Edtison/EDTV4/media/renders/EDTV4_CAD_Render.png

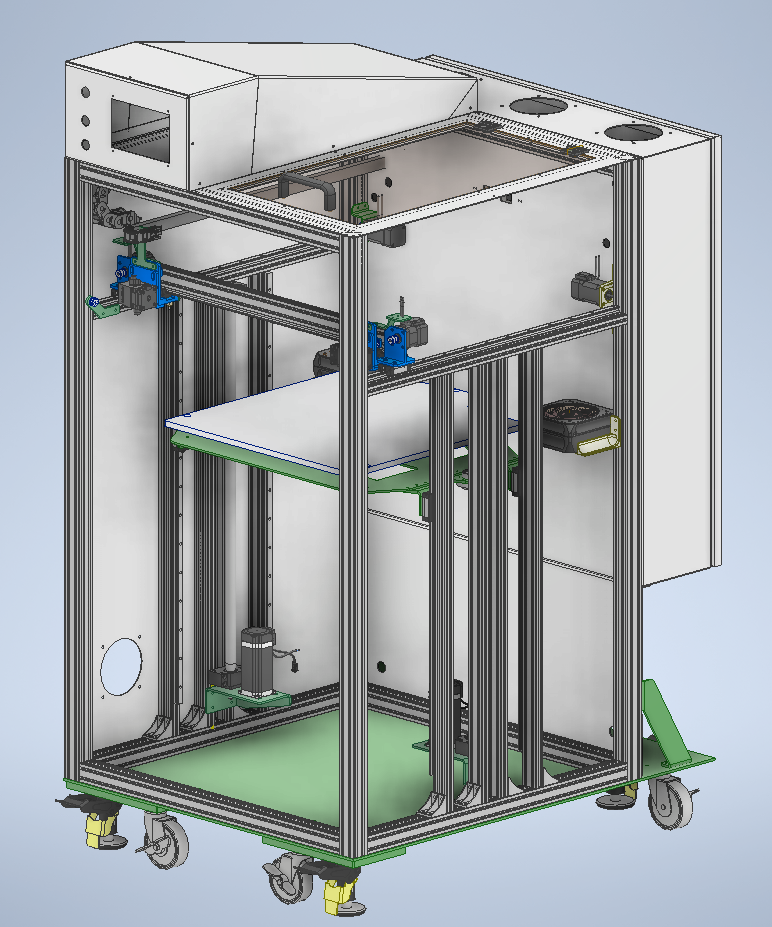
media/renders/EDTV4_CAD_Render.png
