Edtison/EDTV4/hardware/cad/milled_parts/Stueckliste_Fraesteile.pdf

Pos | Name | Stk | Besonderheit
1 Extruder Halteplatte | | 2 -
2 Extruderhalterung Mitnehmer X Links | | 2 -
3 Riemen Mitnhemer | | 2 -
4 Riemenspanner X-Achse | | 2 -
5 Träger X-Achse links | | 1 -
6 Träger X-Achse rechts | | 1 -
7
8
9
10
11
12

### Stückliste Frästeile EDT V4 - Drucker
