Edtison/EDTV4/hardware/cad/sheetmetal/Stueckliste_Blechteile_Verzinkt.pdf

Pos | Name | Stk | Besonderheit
1 Bodenplatte | | 1 -
2 Montageplatte_Lenkrollen_Fuss | | 4 -
3 Motorhalter Z-Achse Nema 23 | | 2 1 Stk Normal, 1 Stk gespiegelt
4 Winkel_Führung_zu_Träger | | 4 -
5 Druckbett Träger | | 1 -
6 Blech Spindelmutter zu Träger | | 2 -
7 Blechhalterung Y-Motoren | | 2 -
8 Mitnehmer Kabelschlepp | | 2 1 Stk Normal, 1 Stk gespiegelt
9 Mitnehmer Kabelschlepp Extruder | | 2 1 Stk Normal, 1 Stk gespiegelt
10 Riemenspanner | | 2 -
11 BLL-Touch HalterungsBlech | | 1 -
12 Bodenplatte_Winkel_Verstaerkung | | 2 1 Stk Normal, 1 Stk gespiegelt

### Stückliste galvanisch verzinkte Blechteile
