Edtison/EDTV4/hardware/cad/acrylics/Deckel Scheibe.stp

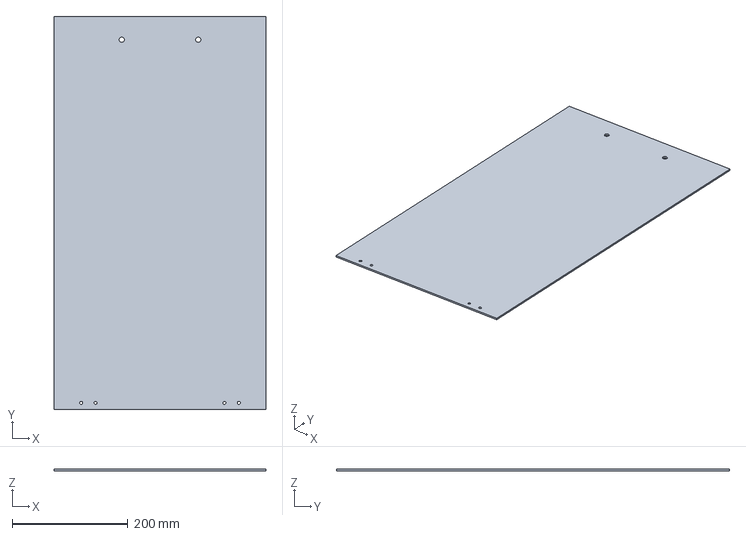
[picture p6: CAD file, 2026-10-13]
hardware/cad/acrylics/Deckel Scheibe.stp
365.0 x 678.0 x 3.00 mm
