Edtison/EDTV4/hardware/cad/electric_enclosure/Schaltschrank_Tuer.stp

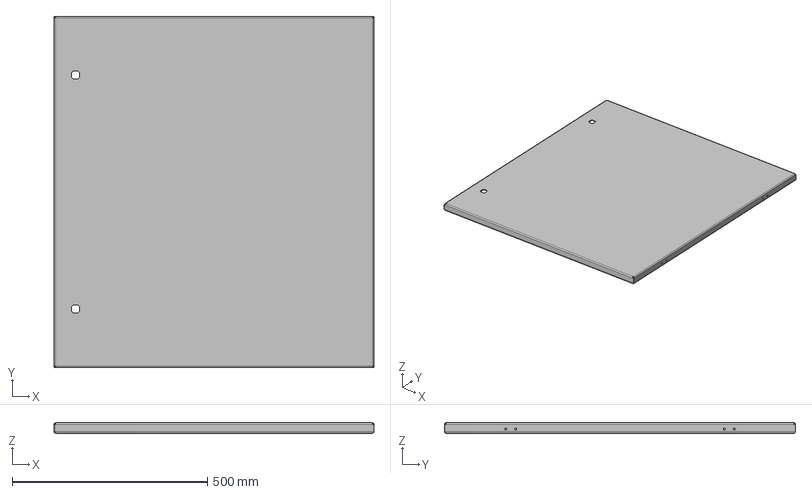
[picture p7: CAD file, 2026-10-13]
hardware/cad/electric_enclosure/Schaltschrank_Tuer.stp
820.0 x 900.0 x 27.0 mm
