Edtison/EDTV4/hardware/cad/milled_parts/Traeger X-Achse Links.stp

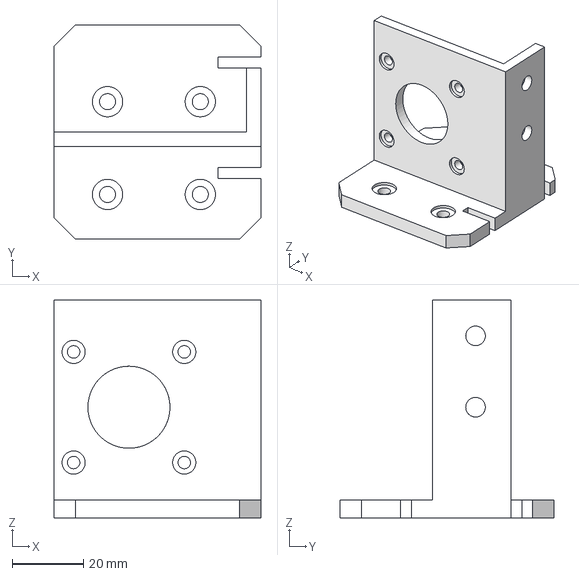
[picture p8: CAD file, 2026-10-13]
hardware/cad/milled_parts/Traeger X-Achse Links.stp
58.0 x 60.0 x 61.0 mm
