Edtison/EDTV4/hardware/cad/acrylics/Scheibe_Front_Tuer.stp

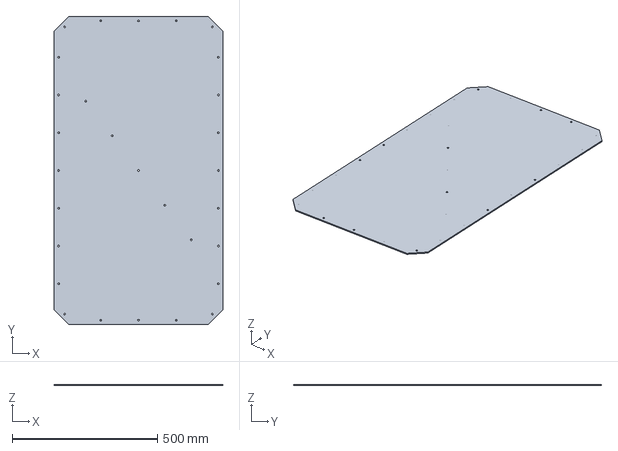
[picture p9: CAD file, 2026-10-13]
hardware/cad/acrylics/Scheibe_Front_Tuer.stp
580.0 x 1060.0 x 4.00 mm
