Edtison/EDTV4/hardware/cad/electric_enclosure/Blechabdeckung_Unten_Rueckseite.stp

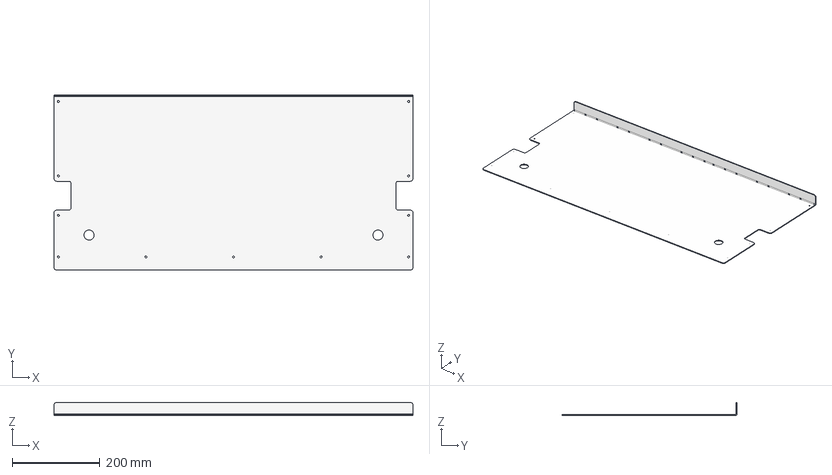
[picture p10: CAD file, 2026-10-13]
hardware/cad/electric_enclosure/Blechabdeckung_Unten_Rueckseite.stp
820.0 x 400.0 x 30.0 mm
