Edtison/EDTV4/hardware/cad/milled_parts/Extruder_Halteplatte.stp

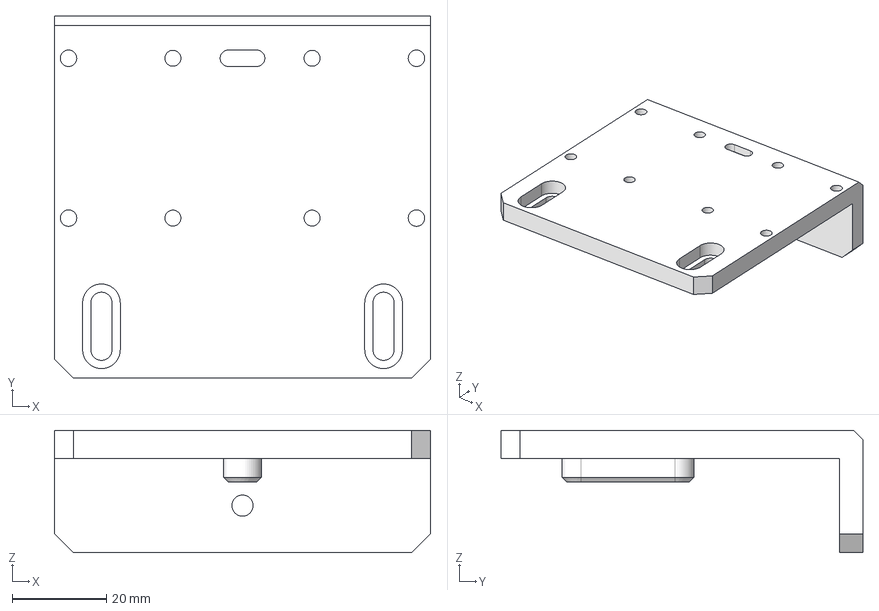
[picture p11: CAD file, 2026-10-13]
hardware/cad/milled_parts/Extruder_Halteplatte.stp
80.0 x 77.0 x 26.0 mm
