Edtison/EDTV4/hardware/cad/electric_enclosure/Schaltschrank_Kasten.stp

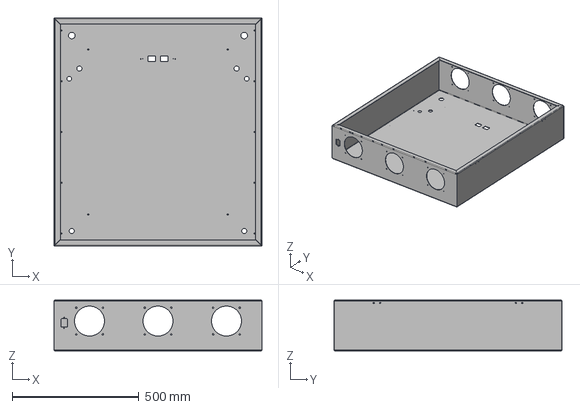
[picture p12: CAD file, 2026-10-13]
hardware/cad/electric_enclosure/Schaltschrank_Kasten.stp
820.0 x 900.0 x 200.0 mm
