Edtison/EDTV4/hardware/cad/milled_parts/Extruderhalterung_MitnehmerX_Links.stp

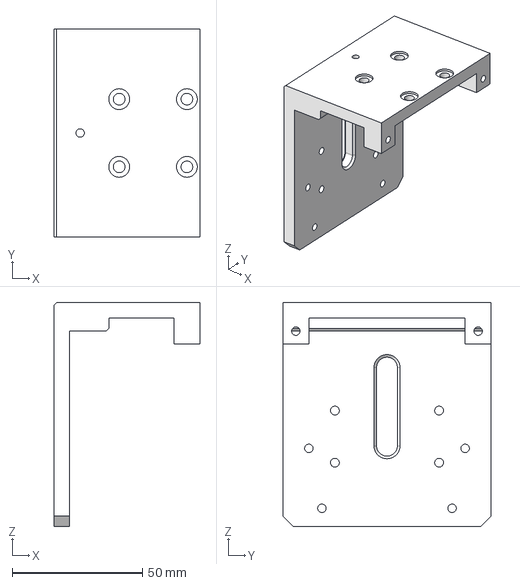
[picture p13: CAD file, 2026-10-13]
hardware/cad/milled_parts/Extruderhalterung_MitnehmerX_Links.stp
56.0 x 80.0 x 86.0 mm
