Edtison/EDTV4/hardware/cad/electric_enclosure/Elektronik_Blech.stp

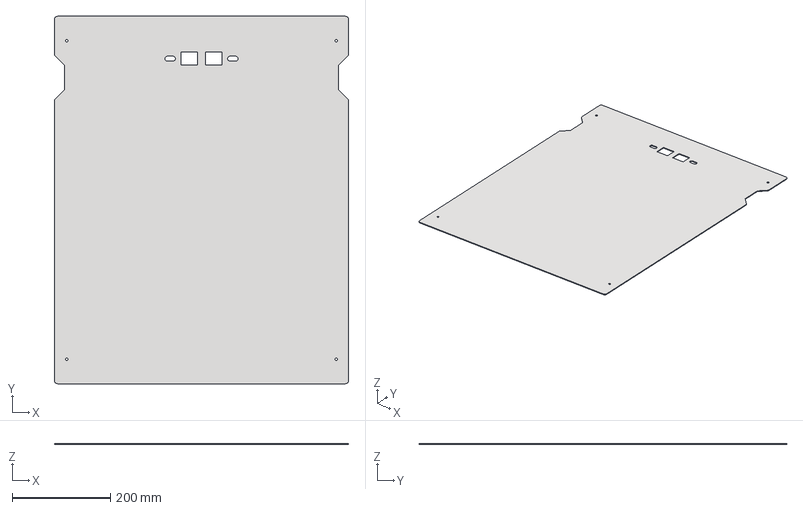
[picture p14: CAD file, 2026-10-13]
hardware/cad/electric_enclosure/Elektronik_Blech.stp
600.0 x 750.0 x 2.00 mm
