Edtison/EDTV4/hardware/cad/milled_parts/Riemen_Mitnehmer.stp

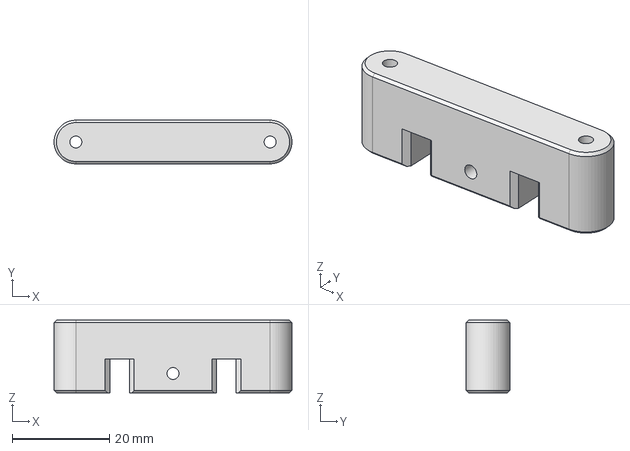
[picture p15: CAD file, 2026-10-13]
hardware/cad/milled_parts/Riemen_Mitnehmer.stp
49.0 x 9.00 x 15.0 mm
