Edtison/EDTV4/hardware/cad/milled_parts/Traeger X-Achse Rechts.stp

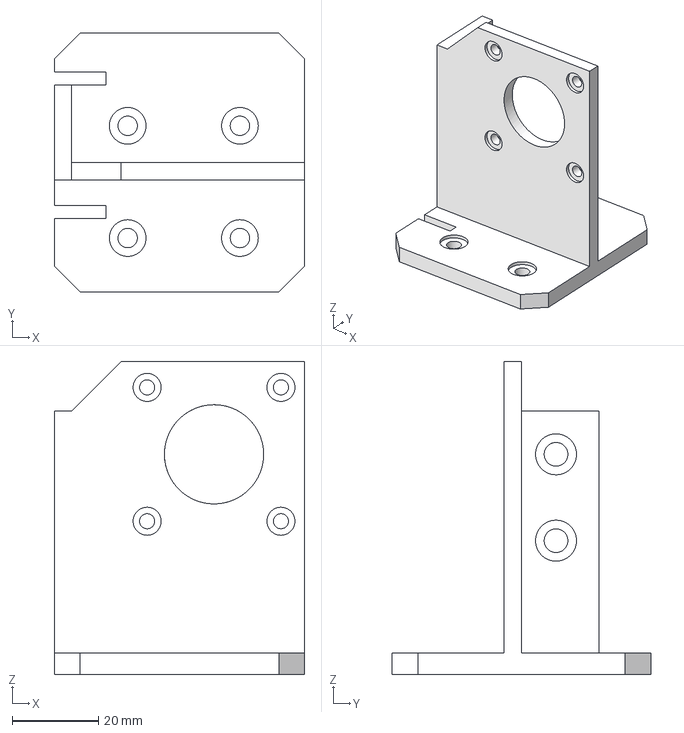
[picture p16: CAD file, 2026-10-13]
hardware/cad/milled_parts/Traeger X-Achse Rechts.stp
58.0 x 60.0 x 72.5 mm
