Edtison/EDTV4/hardware/cad/sheetmetal/Mitnehmer kabelschlepp Extruder.stp

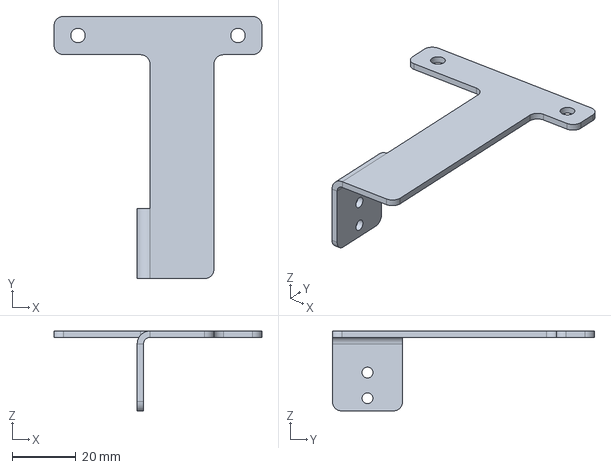
[picture p17: CAD file, 2026-10-13]
hardware/cad/sheetmetal/Mitnehmer kabelschlepp Extruder.stp
65.0 x 82.0 x 25.0 mm
