Edtison/EDTV4/hardware/cad/milled_parts/Riemenspanner X-Achse.stp

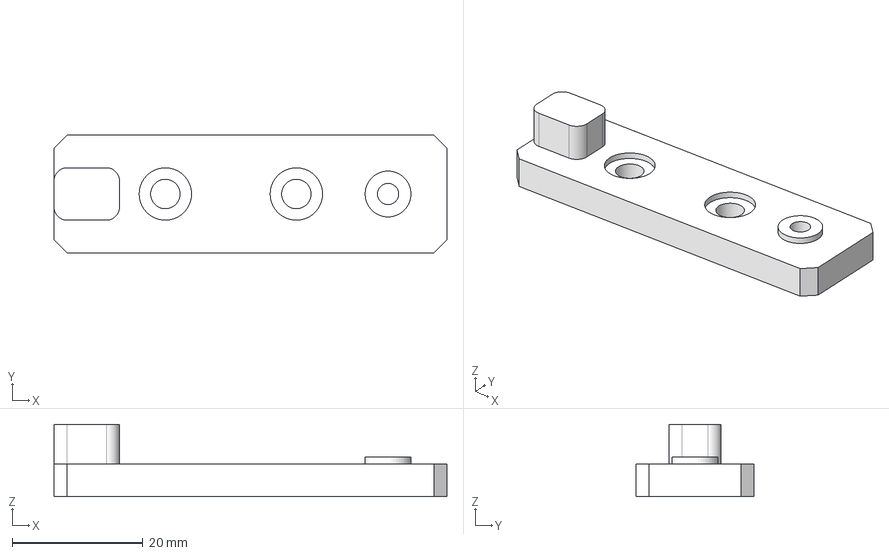
[picture p18: CAD file, 2026-10-13]
hardware/cad/milled_parts/Riemenspanner X-Achse.stp
60.0 x 18.0 x 11.0 mm
