Edtison/EDTV4/hardware/cad/sheetmetal/Motorhalter Z-Achse Nema 23.stp

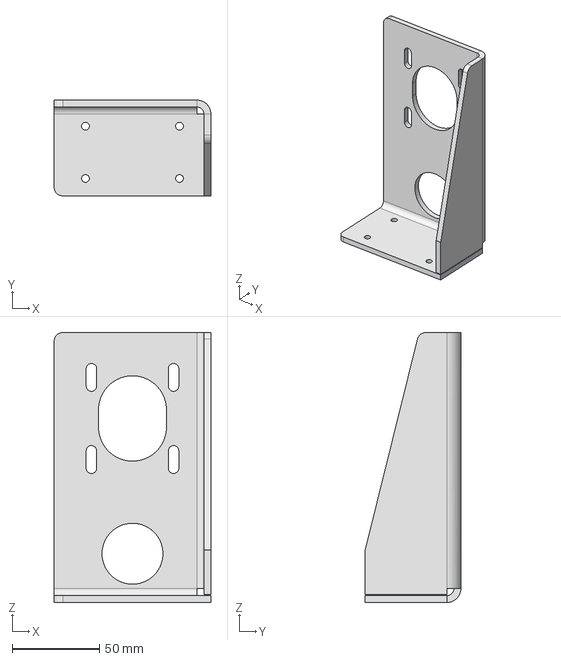
[picture p19: CAD file, 2026-10-13]
hardware/cad/sheetmetal/Motorhalter Z-Achse Nema 23.stp
90.0 x 55.0 x 155.0 mm
