Edtison/EDTV4/hardware/cad/sheetmetal/Mitnehmer Kabelschlepp.stp

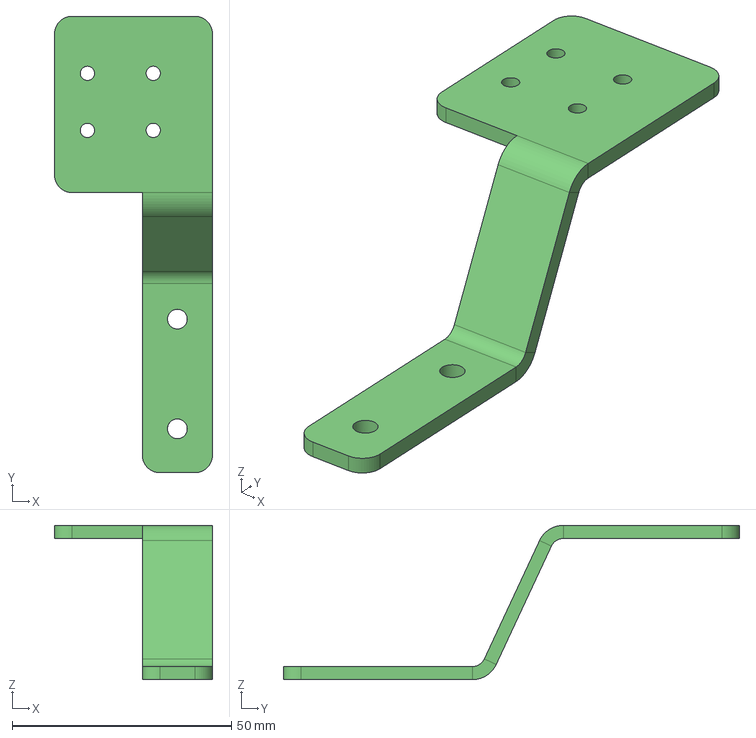
[picture p20: CAD file, 2026-10-13]
hardware/cad/sheetmetal/Mitnehmer Kabelschlepp.stp
36.0 x 104.0 x 35.2 mm
