Edtison/EDTV4/hardware/cad/sheetmetal/BL-Touch_HalterungsBlech.stp

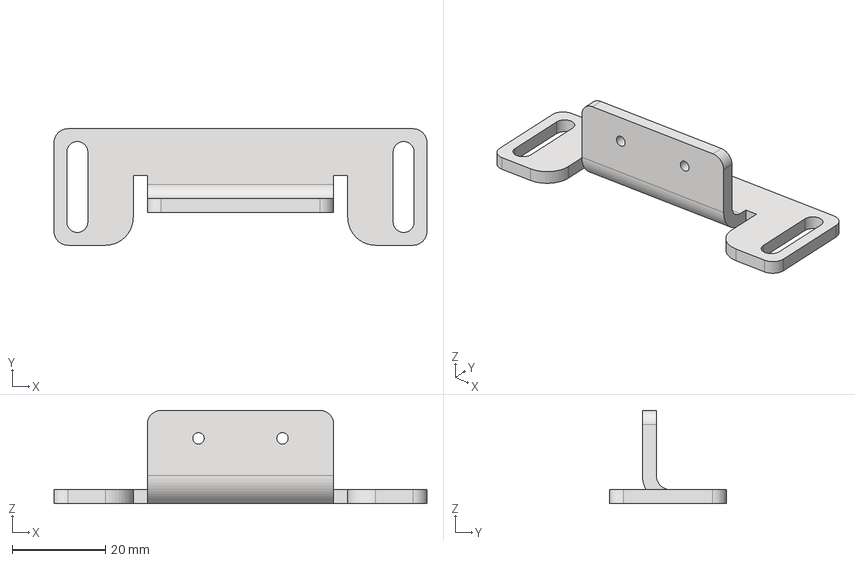
[picture p21: CAD file, 2026-10-13]
hardware/cad/sheetmetal/BL-Touch_HalterungsBlech.stp
80.0 x 25.0 x 20.0 mm
