Edtison/EDTV4/hardware/cad/sheetmetal/Druckbett_Traeger_Blech.stp

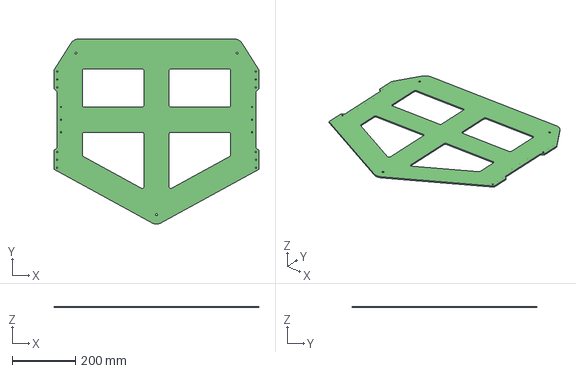
[picture p22: CAD file, 2026-10-13]
hardware/cad/sheetmetal/Druckbett_Traeger_Blech.stp
648.0 x 585.0 x 4.00 mm
