Edtison/EDTV4/hardware/cad/sheetmetal/Blechhalterung_Y_Motoren.stp

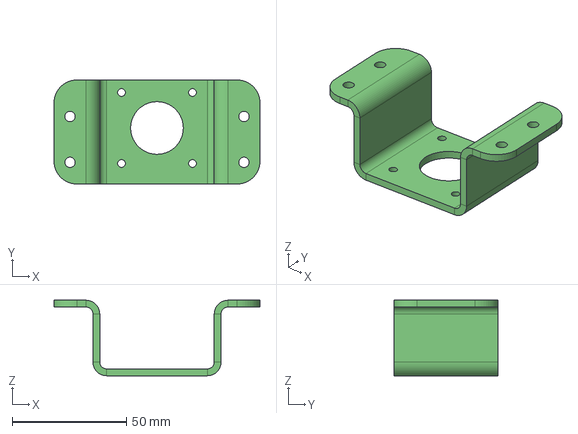
[picture p23: CAD file, 2026-10-13]
hardware/cad/sheetmetal/Blechhalterung_Y_Motoren.stp
90.0 x 45.5 x 33.0 mm
