Edtison/EDTV4/hardware/cad/sheetmetal/Montageplatte_Lenkrollen_Fuss.stp

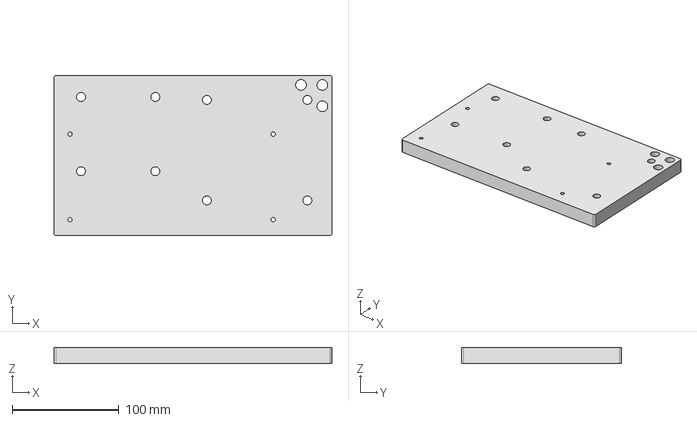
[picture p24: CAD file, 2026-10-13]
hardware/cad/sheetmetal/Montageplatte_Lenkrollen_Fuss.stp
260.0 x 150.0 x 15.0 mm
