Edtison/EDTV4/hardware/cad/sheetmetal/Blech_Spindelmutter_zu_Traeger.stp

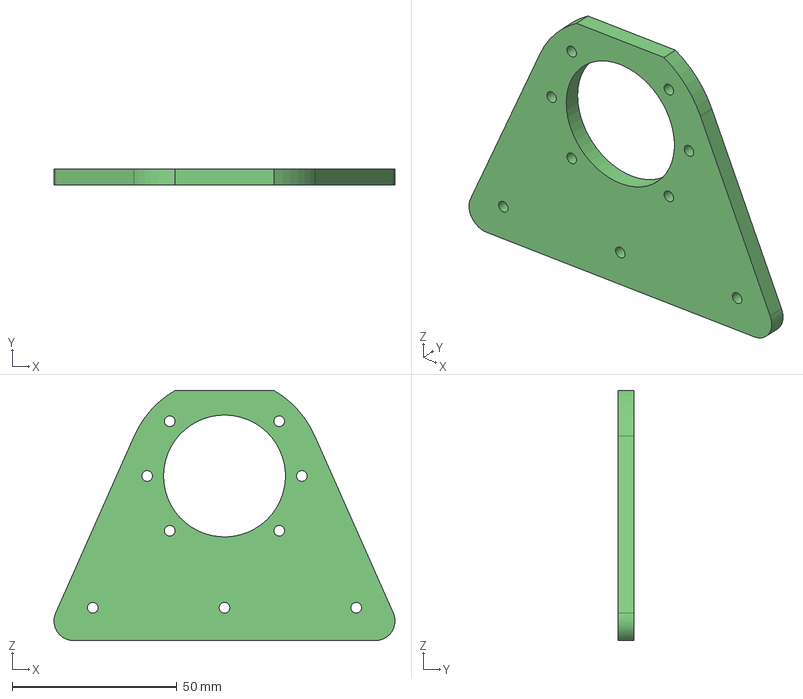
[picture p25: CAD file, 2026-10-13]
hardware/cad/sheetmetal/Blech_Spindelmutter_zu_Traeger.stp
103.5 x 5.00 x 76.0 mm
