Edtison/EDTV4/hardware/cad/sheetmetal/Bodenplatte_Winkel_Verstaerkung.stp

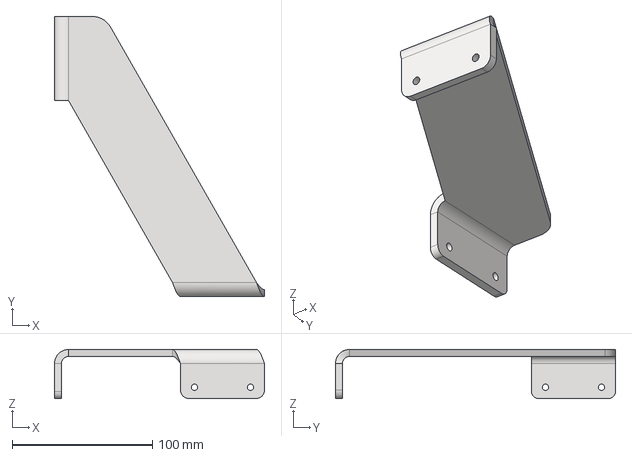
[picture p26: CAD file, 2026-10-13]
hardware/cad/sheetmetal/Bodenplatte_Winkel_Verstaerkung.stp
150.0 x 200.0 x 35.0 mm
