Edtison/EDTV4/hardware/cad/sheetmetal/Riemenspanner Y.stp

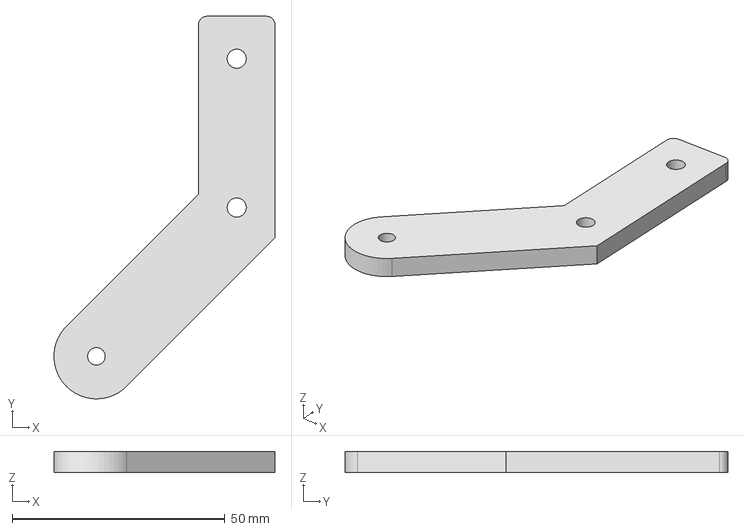
[picture p27: CAD file, 2026-10-13]
hardware/cad/sheetmetal/Riemenspanner Y.stp
52.0 x 90.0 x 5.00 mm
