Edtison/EDTV4/hardware/cad/sheetmetal/Bodenplatte.stp

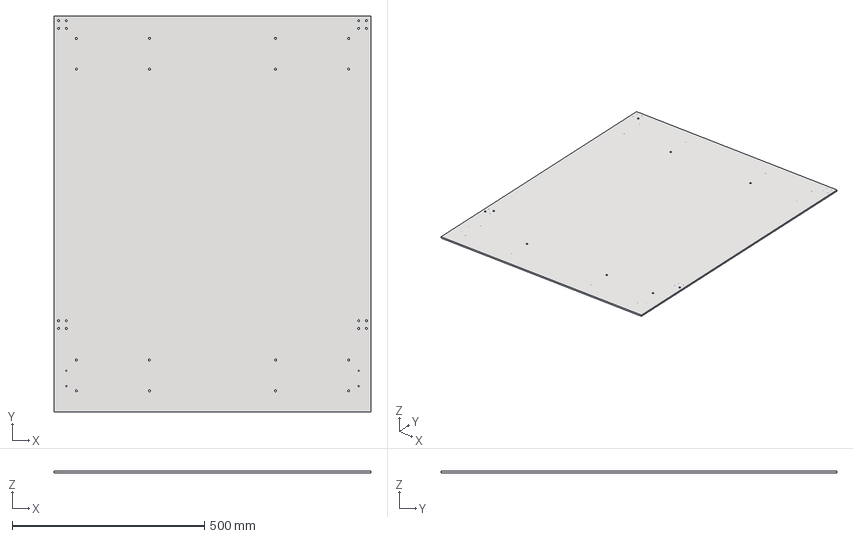
[picture p28: CAD file, 2026-10-13]
hardware/cad/sheetmetal/Bodenplatte.stp
824.0 x 1029.0 x 5.00 mm
