Edtison/EDTV4/(list of files, cad)

Other CAD files:
hardware/cad/sheetmetal/Deckel_Klappe_Blech.dwg
hardware/cad/sheetmetal/Winkel_Fuehrung_zu_Traeger.dwg
hardware/cad/sheetmetal/Seitenblech.dwg
hardware/cad/sheetmetal/Abstandsblech_Dichtung_Tuer.dwg
hardware/cad/sheetmetal/Deckplatte.dwg
hardware/cad/sheetmetal/Tuerblech_Front.dwg
hardware/cad/sheetmetal/Dichtungsblech.dwg
hardware/cad/sheetmetal/Frontblech.dwg
hardware/cad/sheetmetal/Dichtungsblech_Tuer_Front.dwg
hardware/cad/sheetmetal/Zwischenblech_Klappe.dwg
hardware/cad/sheetmetal/Deckel_Haube.dwg
hardware/cad/sheetmetal/Mitnehmer Kabelschlepp X.dwg
hardware/cad/acrylics/Deckel Scheibe.dwg
hardware/cad/acrylics/Scheibe_Front_Tuer.dwg
hardware/cad/electric_enclosure/Blechabdeckung_Unten_Rueckseite.dwg
hardware/cad/electric_enclosure/Elektronik_Blech.dwg
hardware/cad/electric_enclosure/Schaltschranktuer.dwg
hardware/cad/sheetmetal/BL-Touch_HalterungsBlech.dwg
hardware/cad/sheetmetal/Blech_Spindelmutter_zu_Traeger.dwg
hardware/cad/sheetmetal/Blechhalterung_Y_Motoren.dwg
hardware/cad/sheetmetal/Bodenplatte.dwg
hardware/cad/sheetmetal/Bodenplatte_Winkel_Verstaerkung.dwg
hardware/cad/sheetmetal/Druckbett_Traeger_Blech.dwg
hardware/cad/sheetmetal/Mitnehmer kabelschlepp Extruder.dwg
hardware/cad/sheetmetal/Montageplatte_Lenkrollen_Fuss.dwg
hardware/cad/sheetmetal/Motorhalter Z-Achse Nema 23.dwg
hardware/cad/sheetmetal/Riemenspanner Y.dwg
