Edtison/EDTV4/hardware/cad/acrylics/Deckel Scheibe.pdf

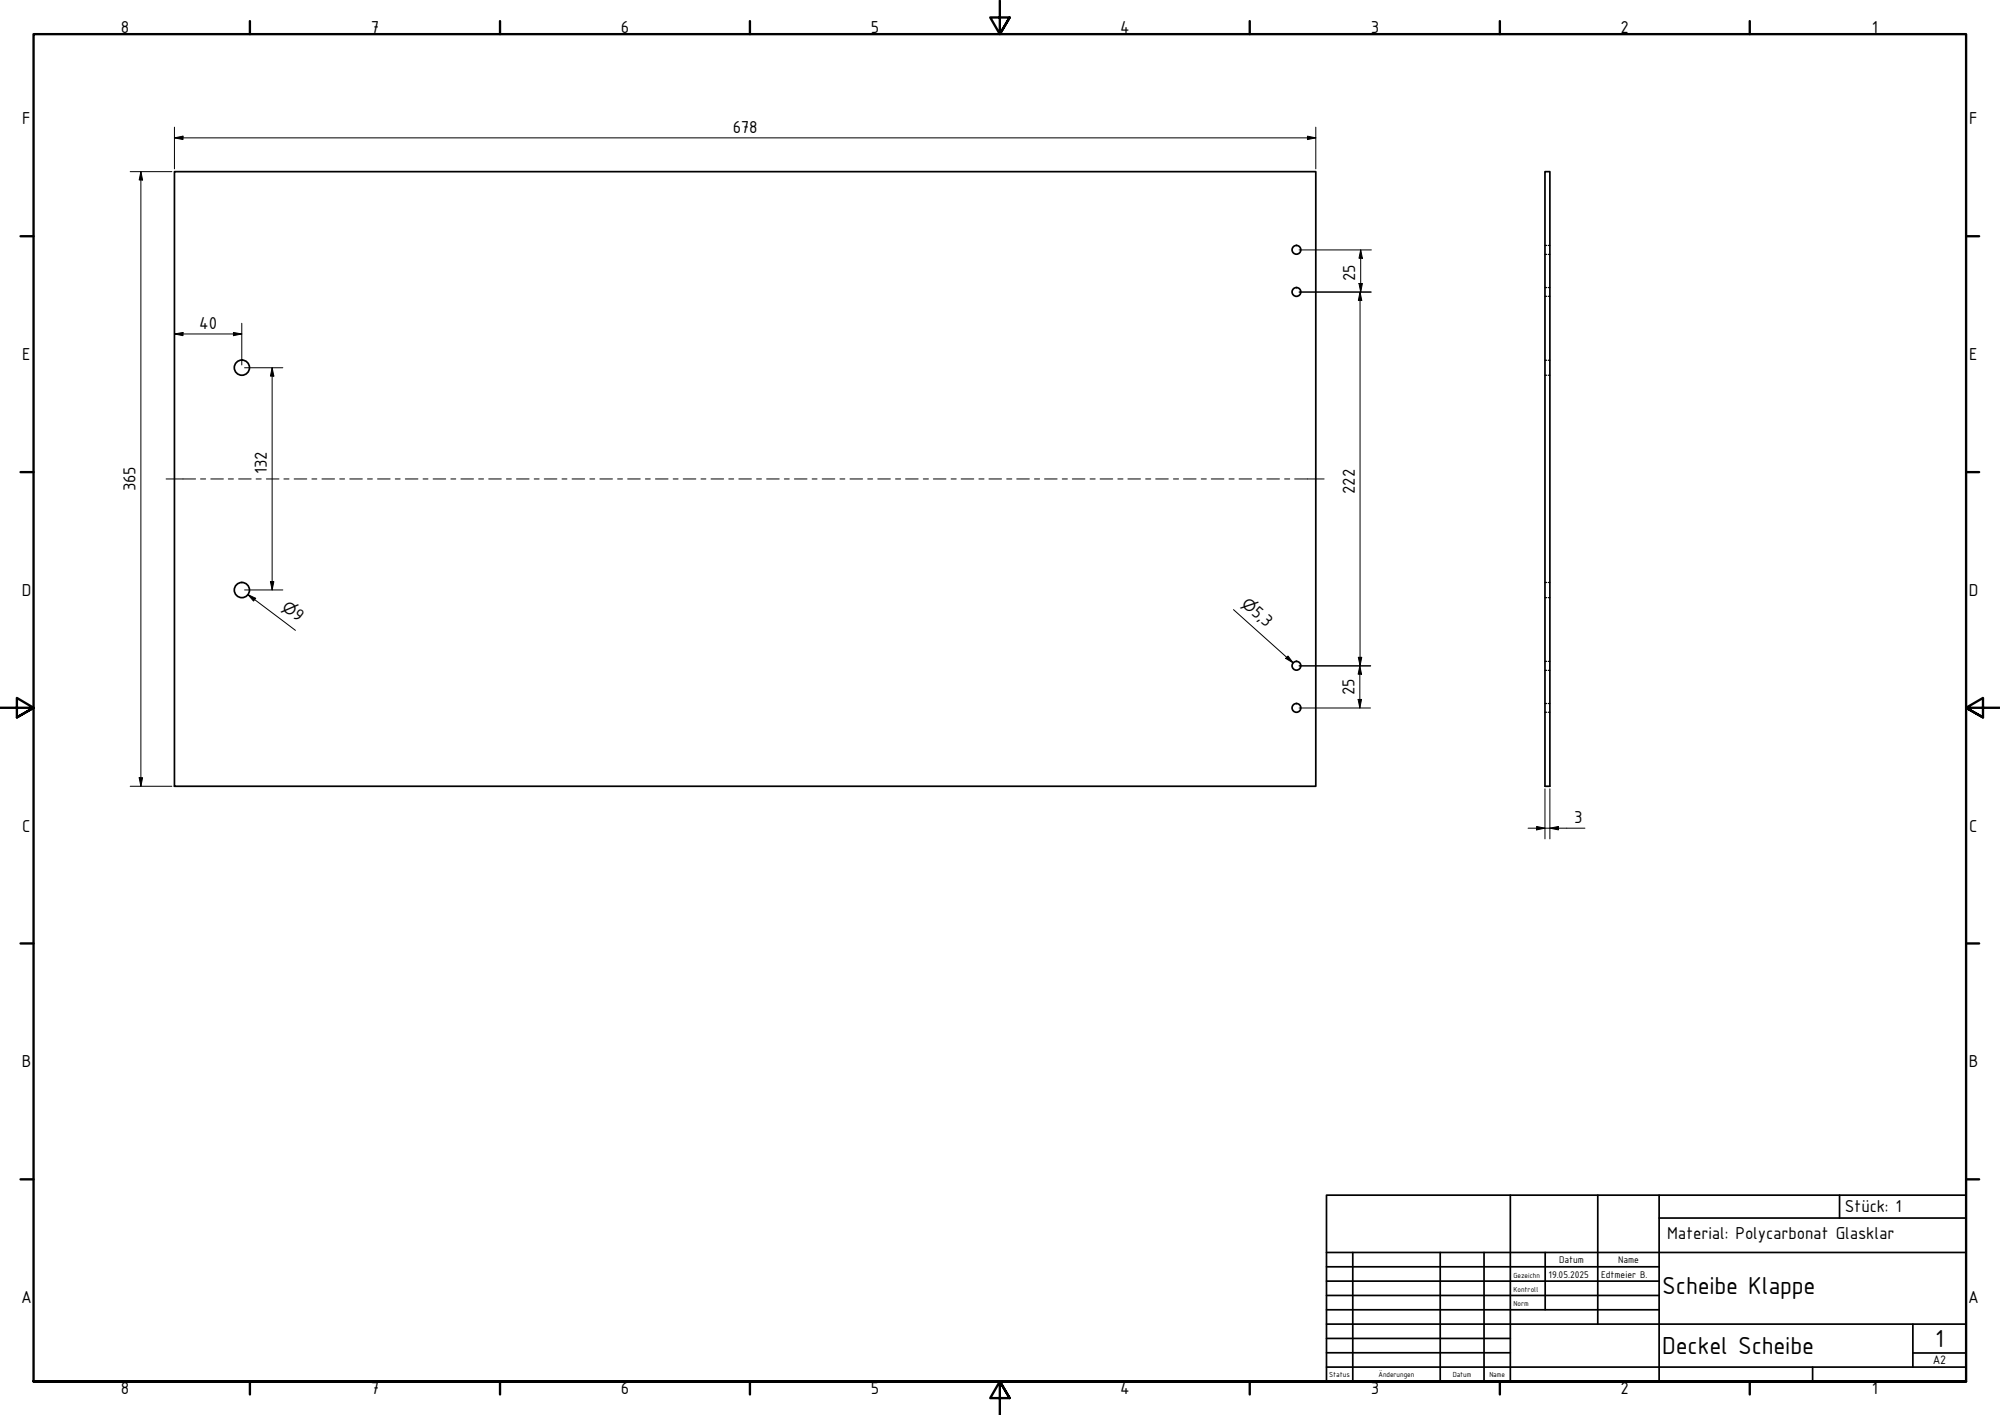
[picture p29: page 1]
Deckel Scheibe

Material: Polycarbonat Glasklar

Datum | Name | Scheibe Klappe

Gezeichn | 19.05.2025 | Edtmeier B.

Kontroll

Norm
