Edtison/EDTV4/hardware/cad/acrylics/Scheibe_Front_Tuer.pdf

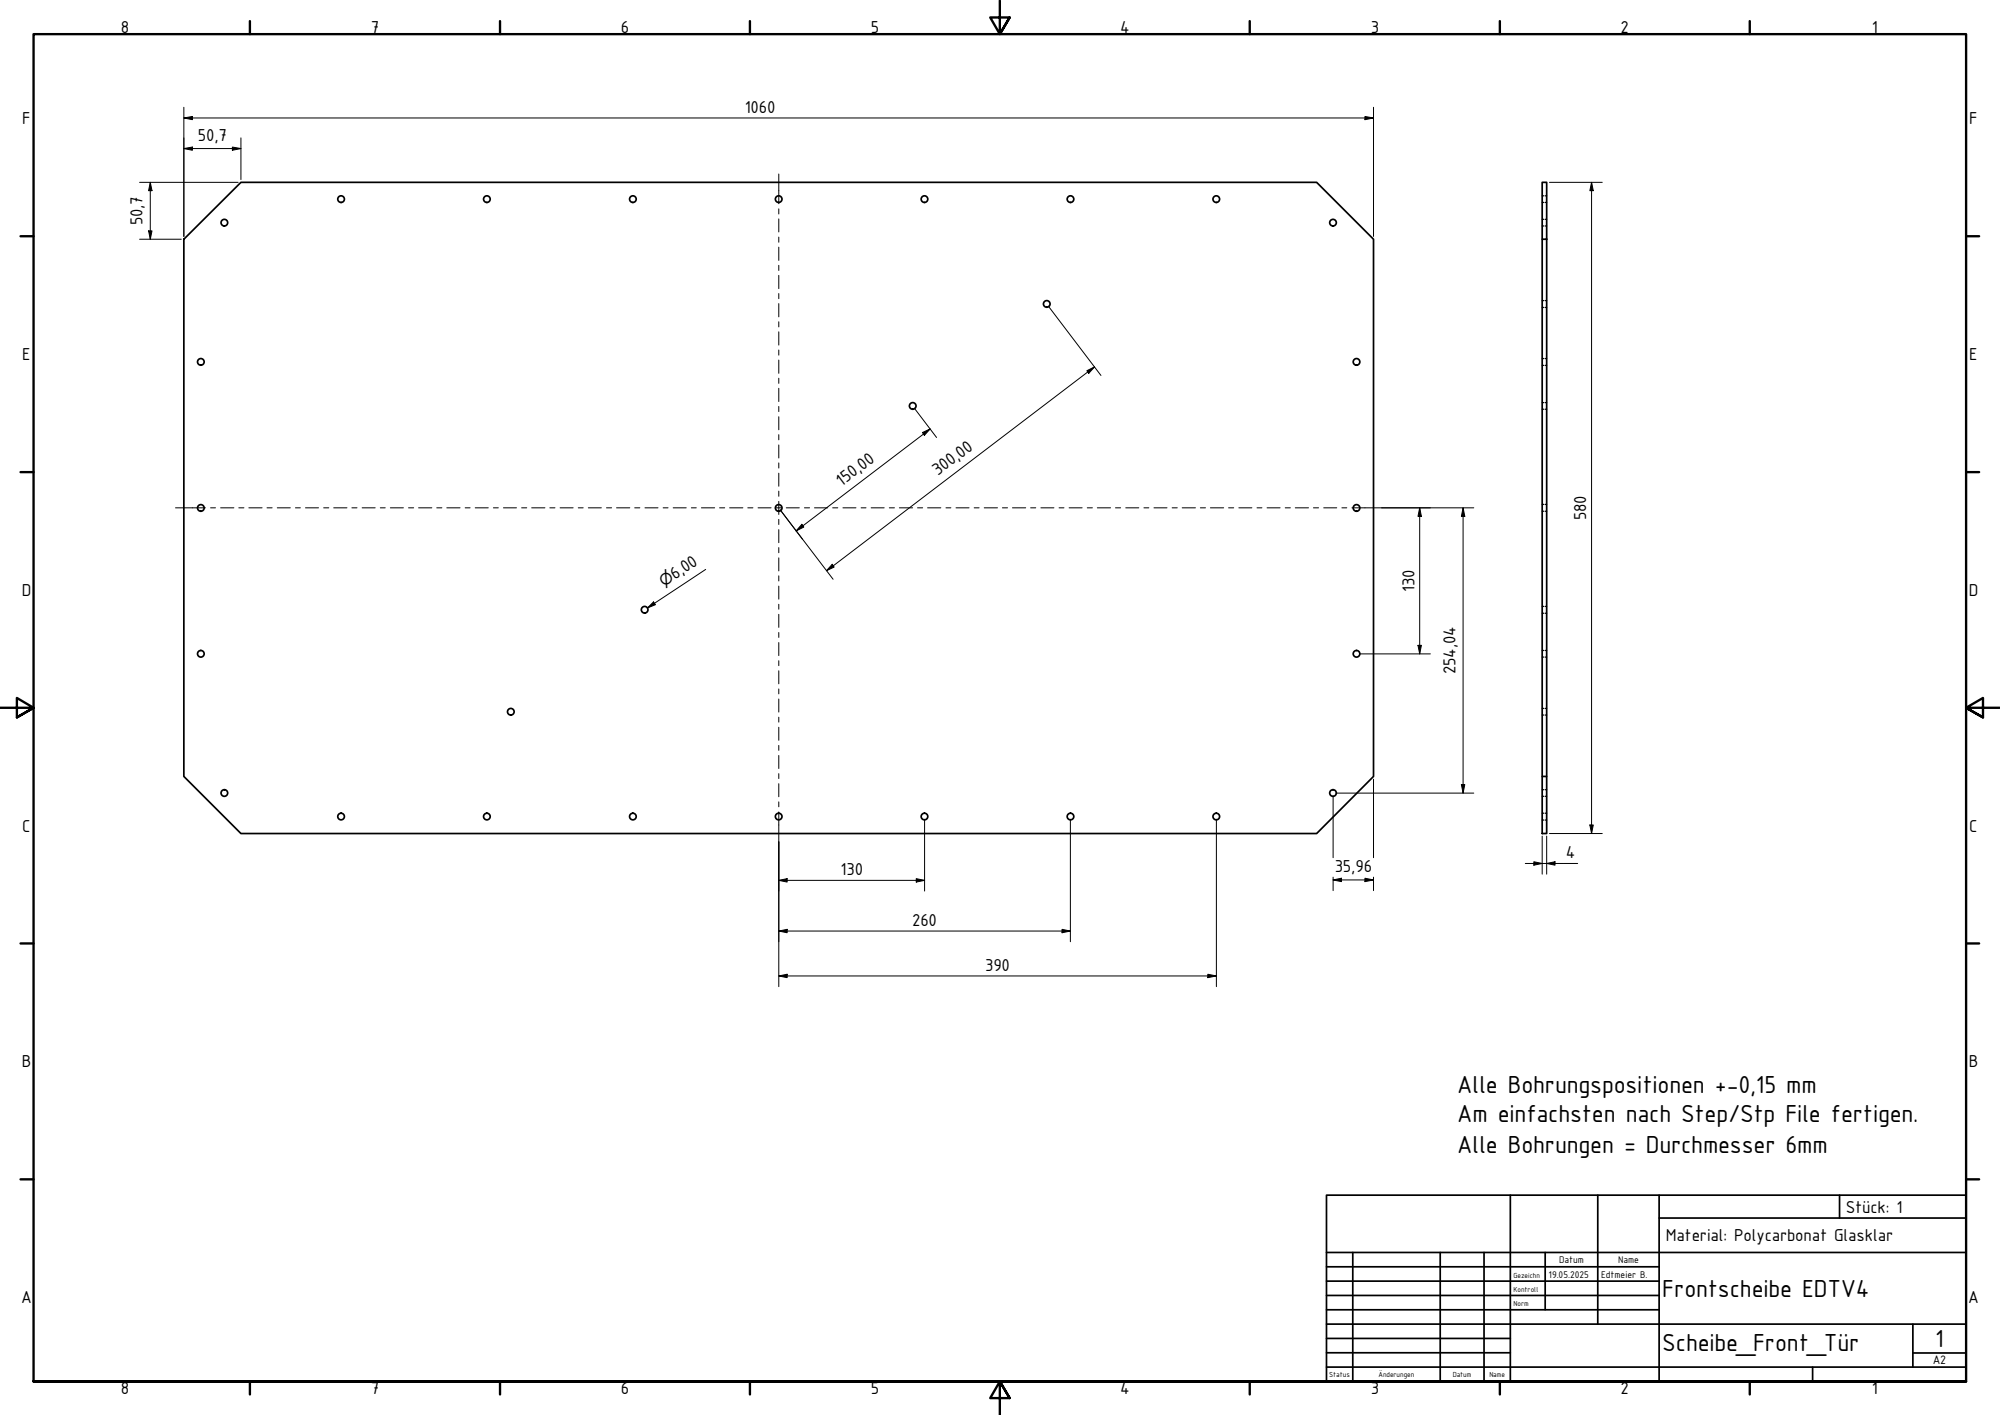
[picture p30: page 1]

Alle Bohrungspositionen +-0,15 mm
Am einfachsten nach Step/Stp File fertigen.
Alle Bohrungen = Durchmesser 6mm

Material: Polycarbonat Glasklar

Datum | Name | Frontscheibe EDTV4

Gezeichn | 19.05.2025 | Edtmeier B.

Kontroll

Norm
