Edtison/EDTV4/hardware/cad/electric_enclosure/Blechabdeckung_Unten_Rueckseite.pdf

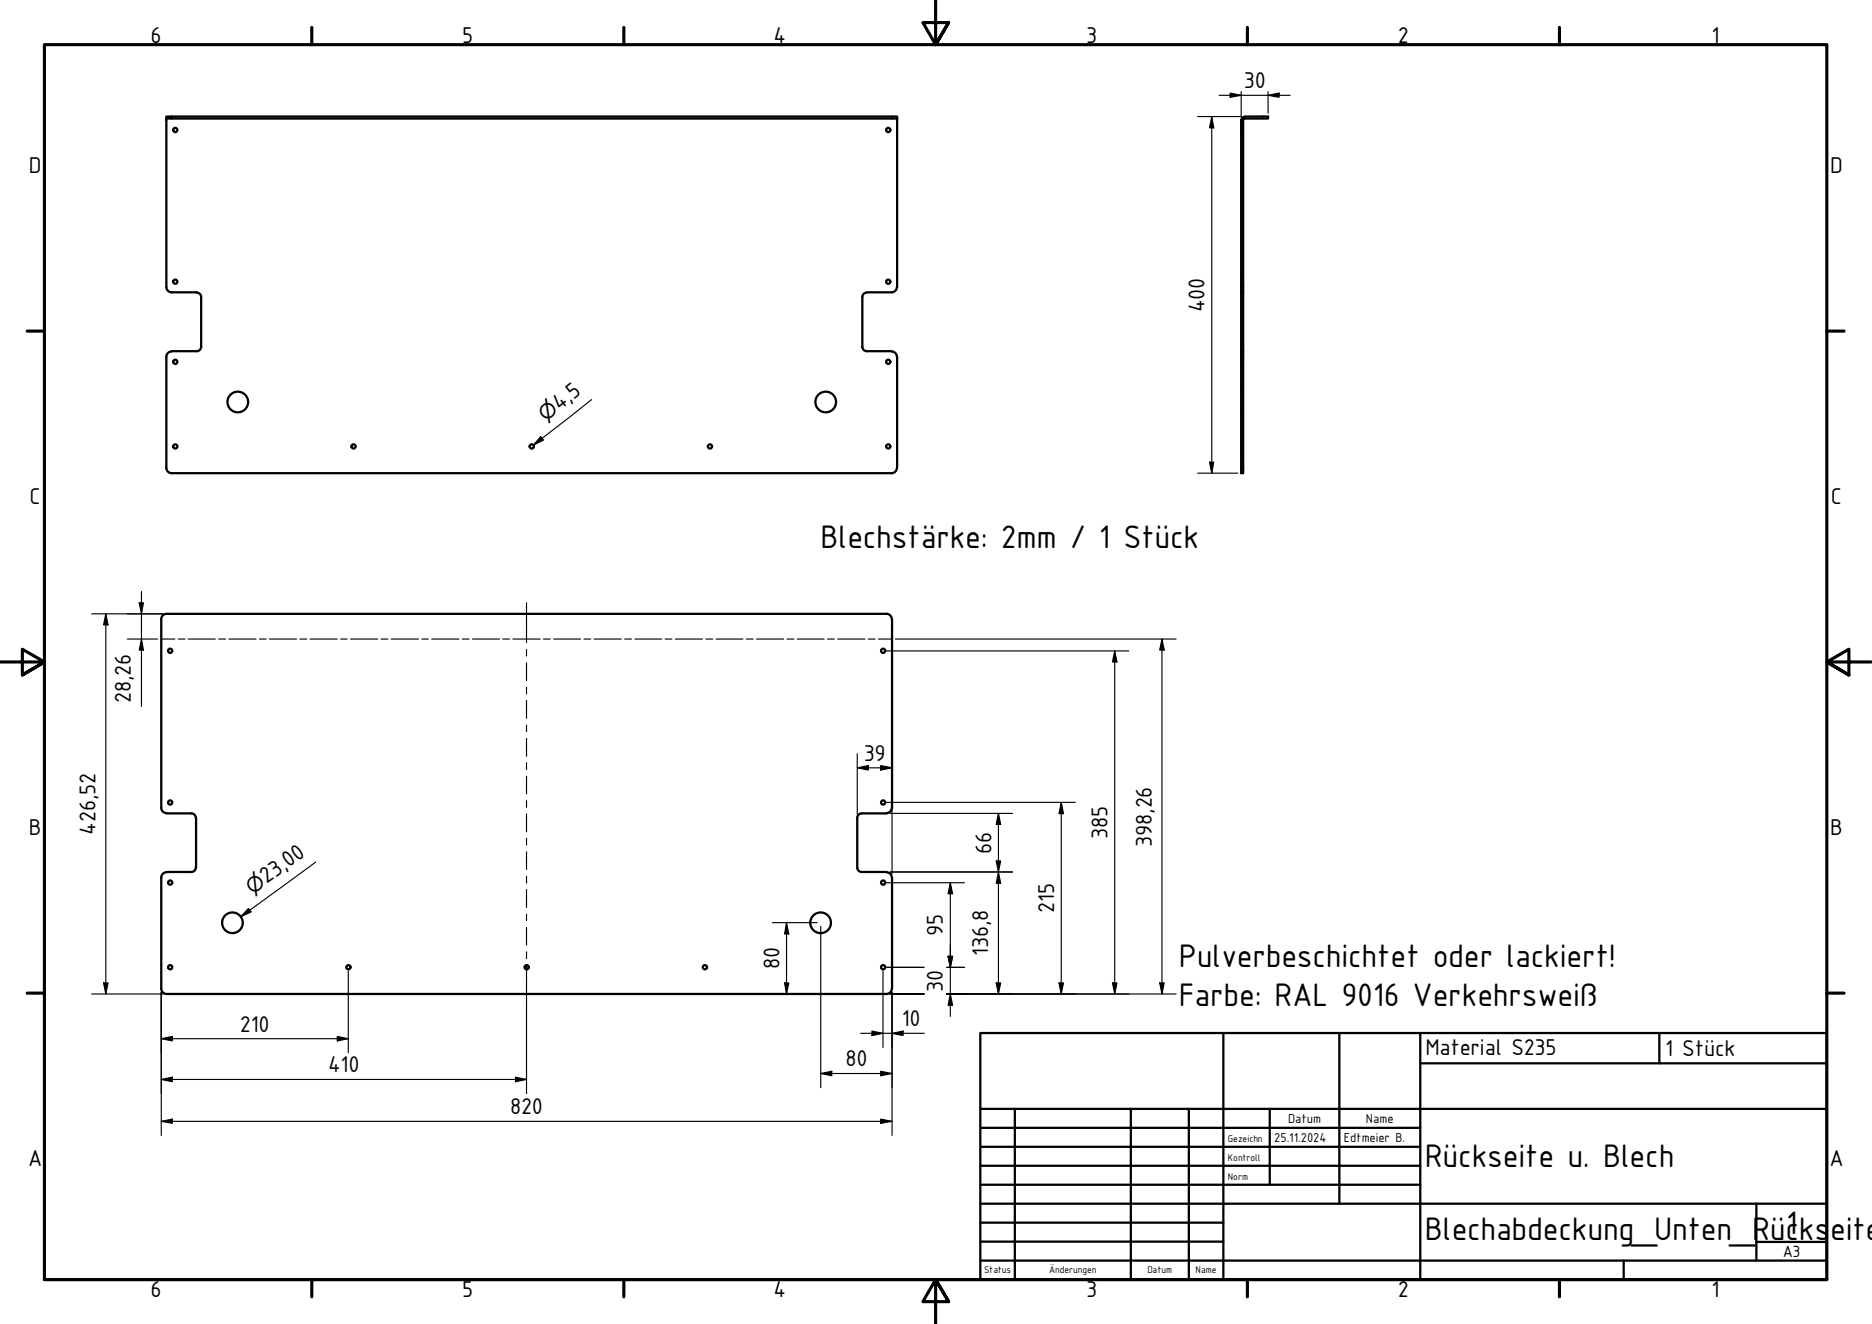
[picture p31: page 1]
Material S235

Blechstrke: 2mm / 1 St¯ck

Pulverbeschichtet oder lackiert!
Farbe: RAL 9016 Verkehrswei

Datum | Name | R¯ckseite u. Blech

Gezeichn | 25.11.2024 | Edtmeier B.

Kontroll

Norm
