Edtison/EDTV4/hardware/cad/electric_enclosure/Elektronik_Blech.pdf

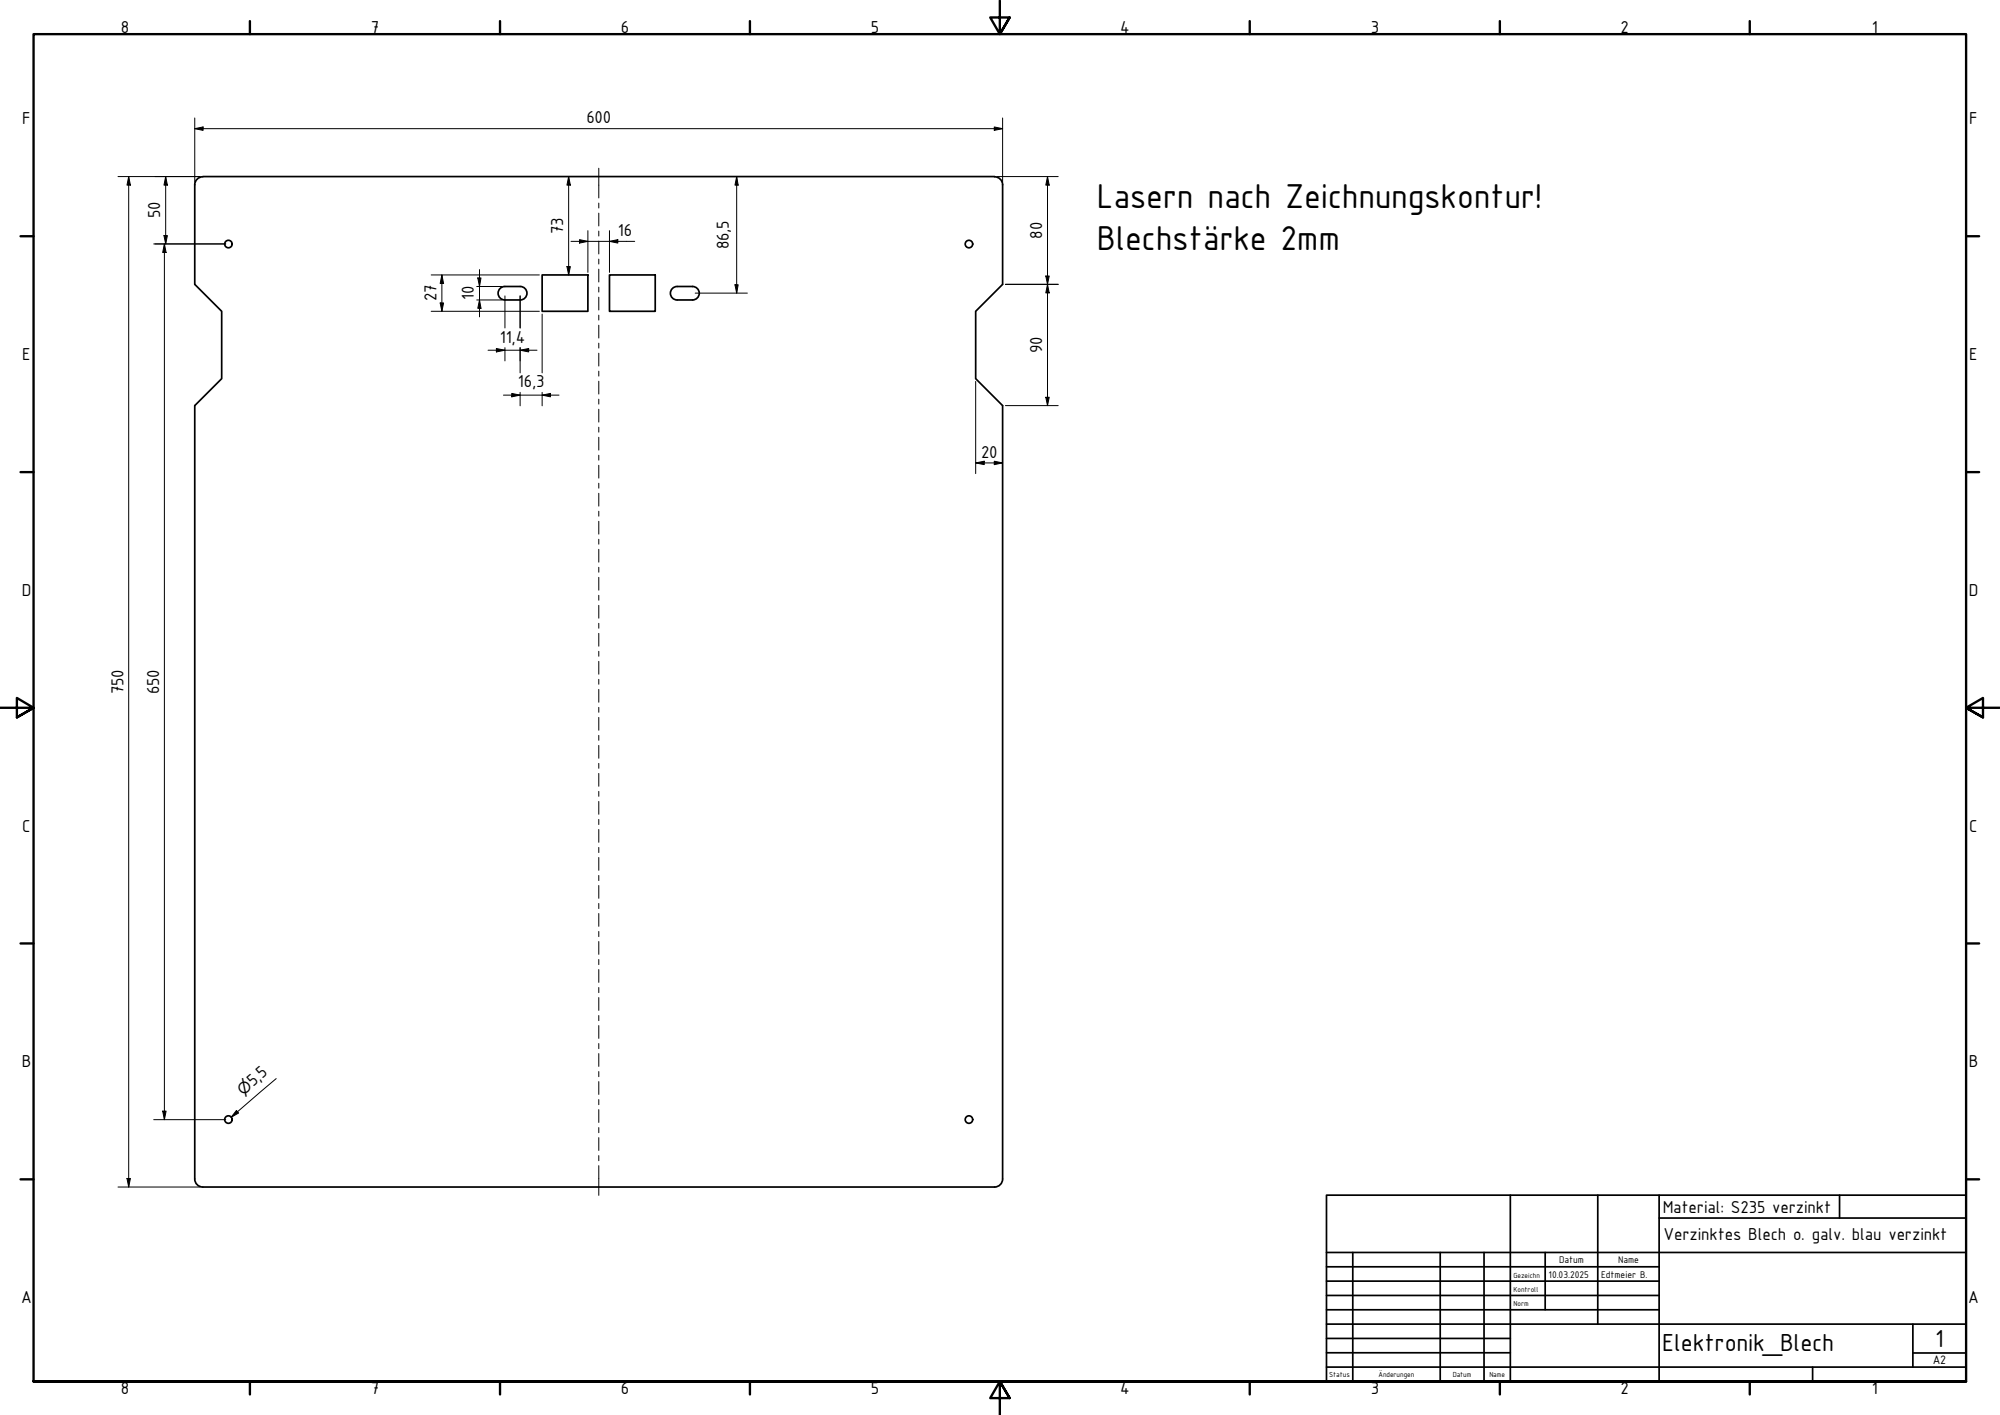
[picture p32: page 1]

Lasern nach Zeichnungskontur!
Blechstrke 2mm

Material: S235 verzinkt
Verzinktes Blech o. galv. blau verzinkt

Datum | Name

Gezeichn | 10.03.2025 | Edtmeier B.

Kontroll

Norm
