Edtison/EDTV4/hardware/cad/electric_enclosure/Schaltschrank_Kasten.pdf

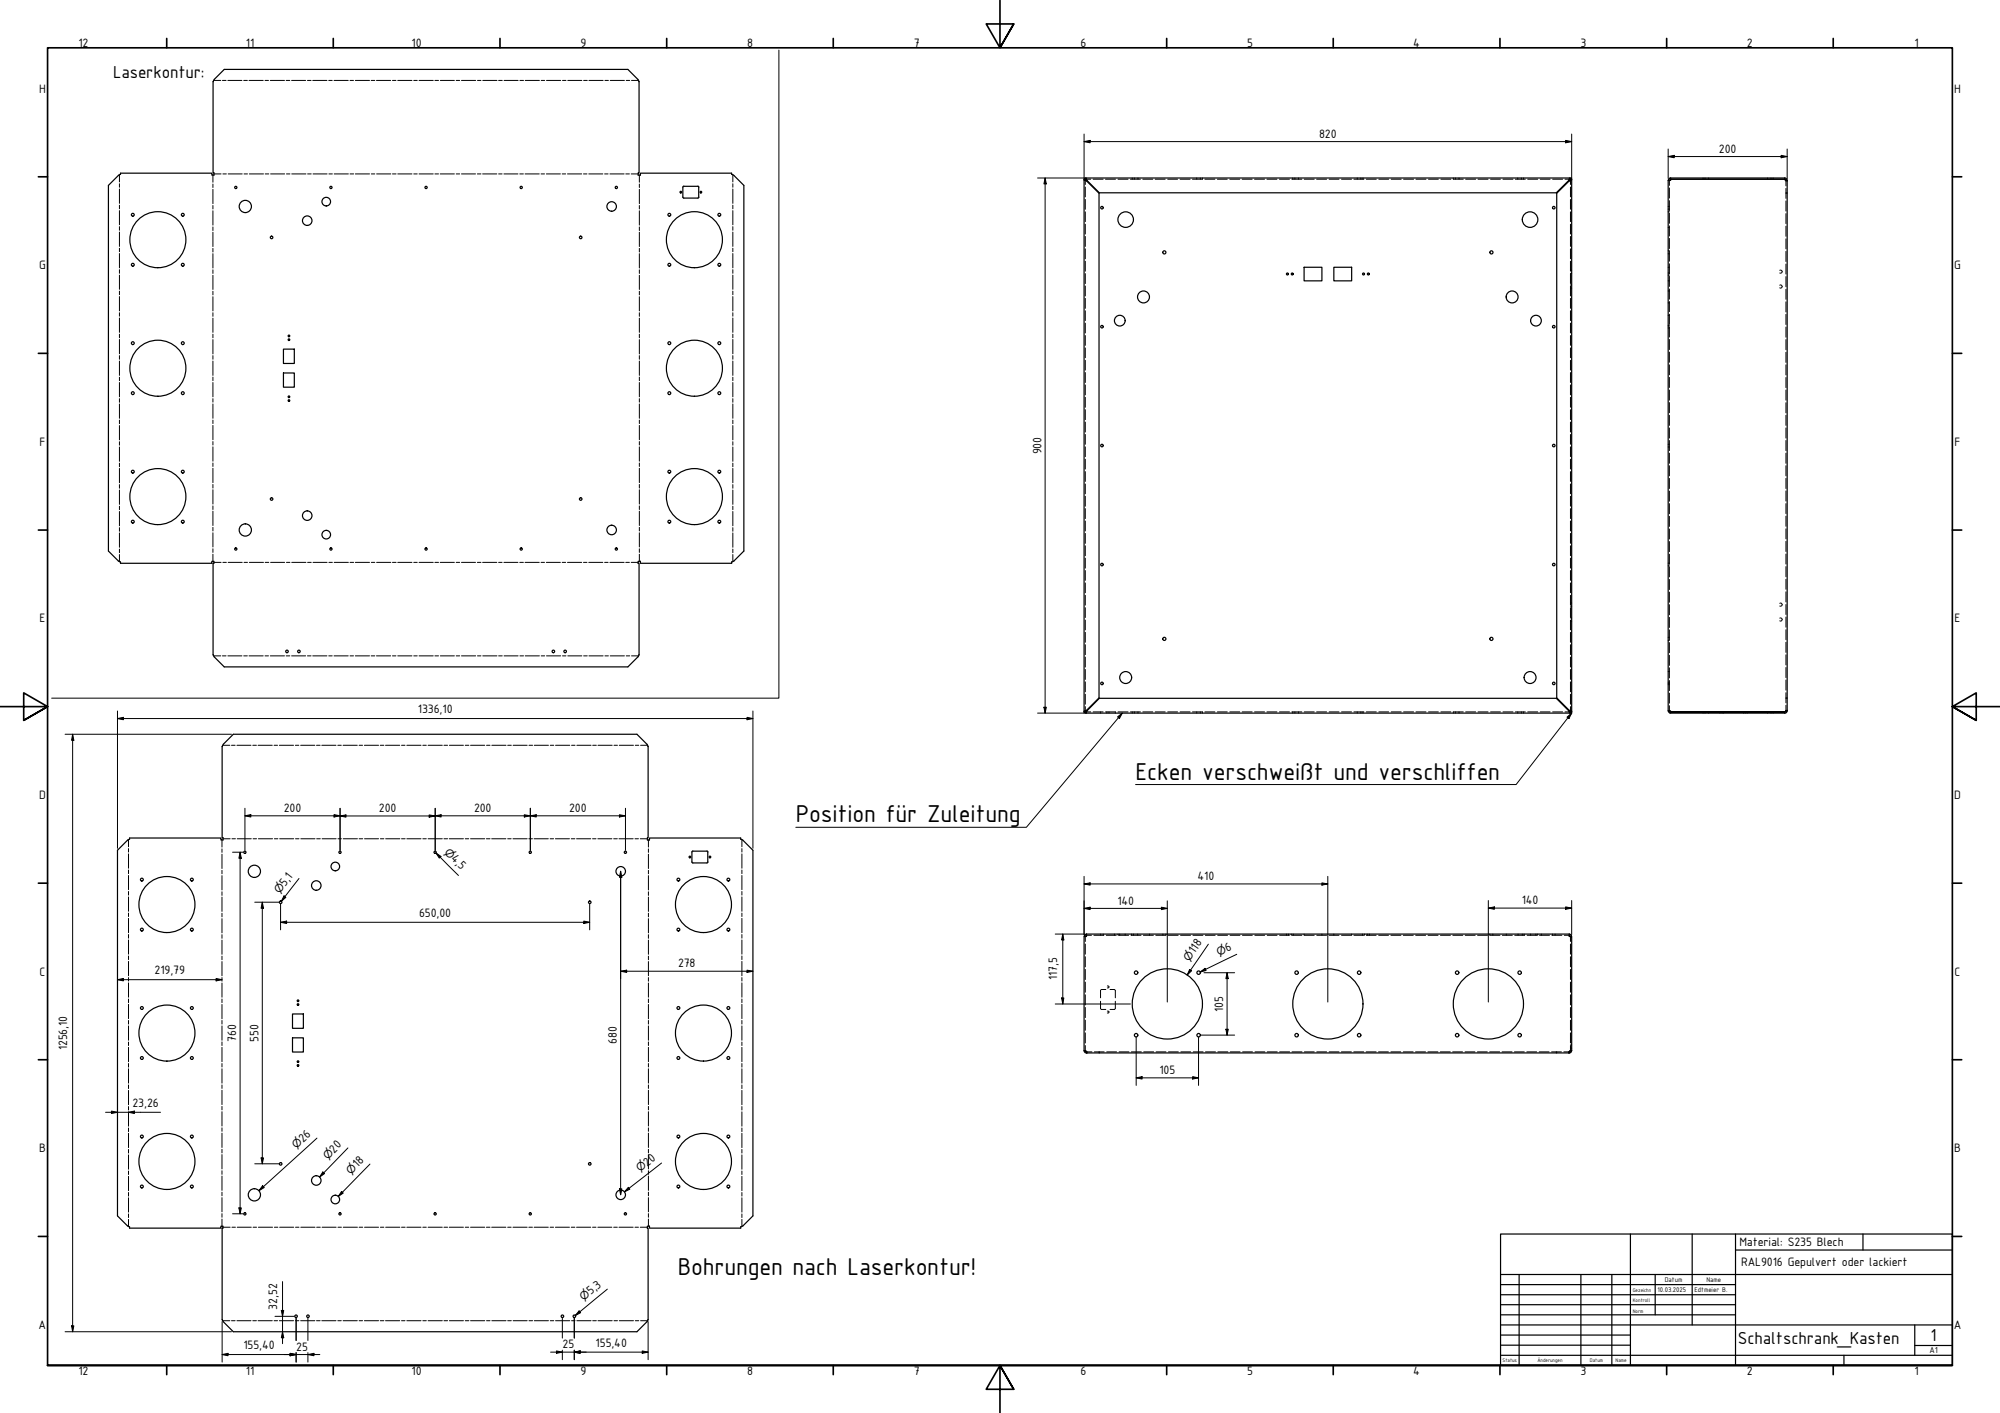
[picture p33: page 1]
Position f¯r Zuleitung

Ecken verschweit und verschliffen

Material: S235 Blech
RAL9016 Gepulvert oder lackiert

Bohrungen nach Laserkontur!

Datum | Name

Gezeichn | 10.03.2025 | Edtmeier B.

Kontroll

Norm
