Edtison/EDTV4/hardware/cad/milled_parts/Extruder_Halteplatte.pdf

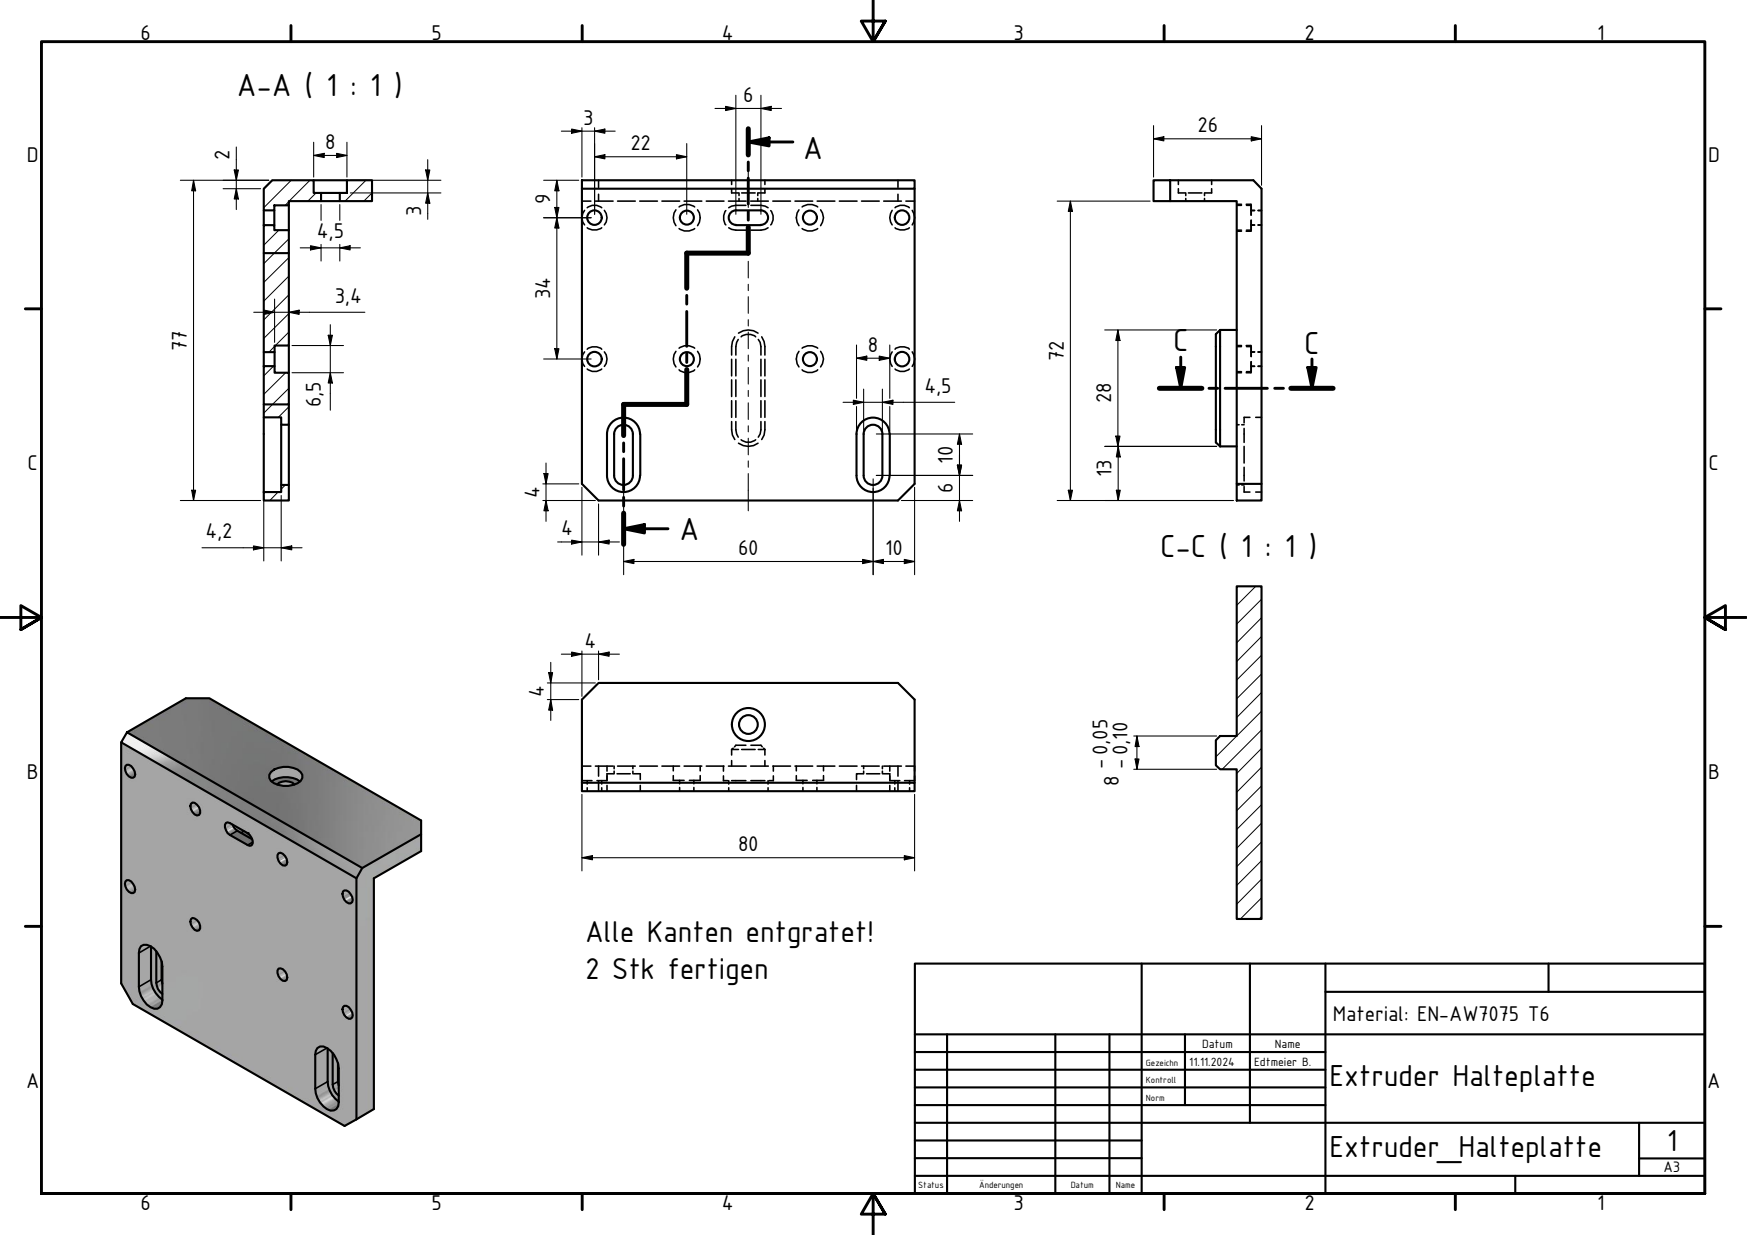
[picture p34: page 1]
Material: EN-AW7075 T6

Alle Kanten entgratet!
2 Stk fertigen

Datum | Name | Extruder Halteplatte

Gezeichn | 11.11.2024 | Edtmeier B.

Kontroll

Norm
