Edtison/EDTV4/hardware/cad/milled_parts/Extruderhalterung_MitnehmerX_Links.pdf

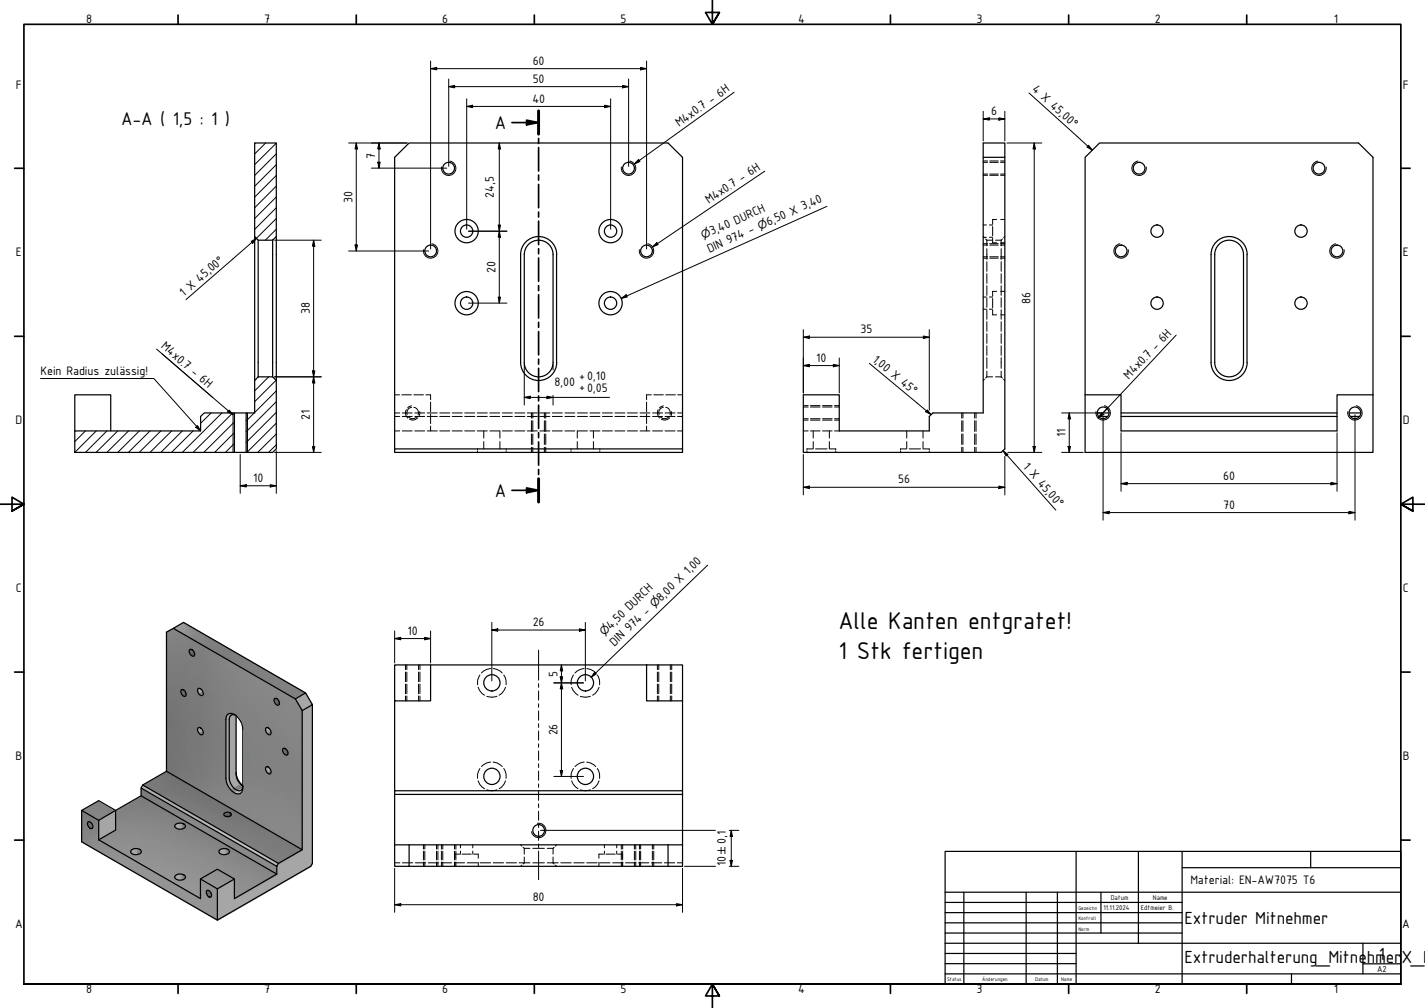
[picture p35: page 1]
Material: EN-AW7075 T6

Kein Radius zulssig!

Alle Kanten entgratet!
1 Stk fertigen

Datum | Name | Extruder Mitnehmer

Gezeichn | 11.11.2024 | Edtmeier B.

Kontroll

Norm
