Edtison/EDTV4/hardware/cad/milled_parts/Riemen_Mitnehmer.pdf

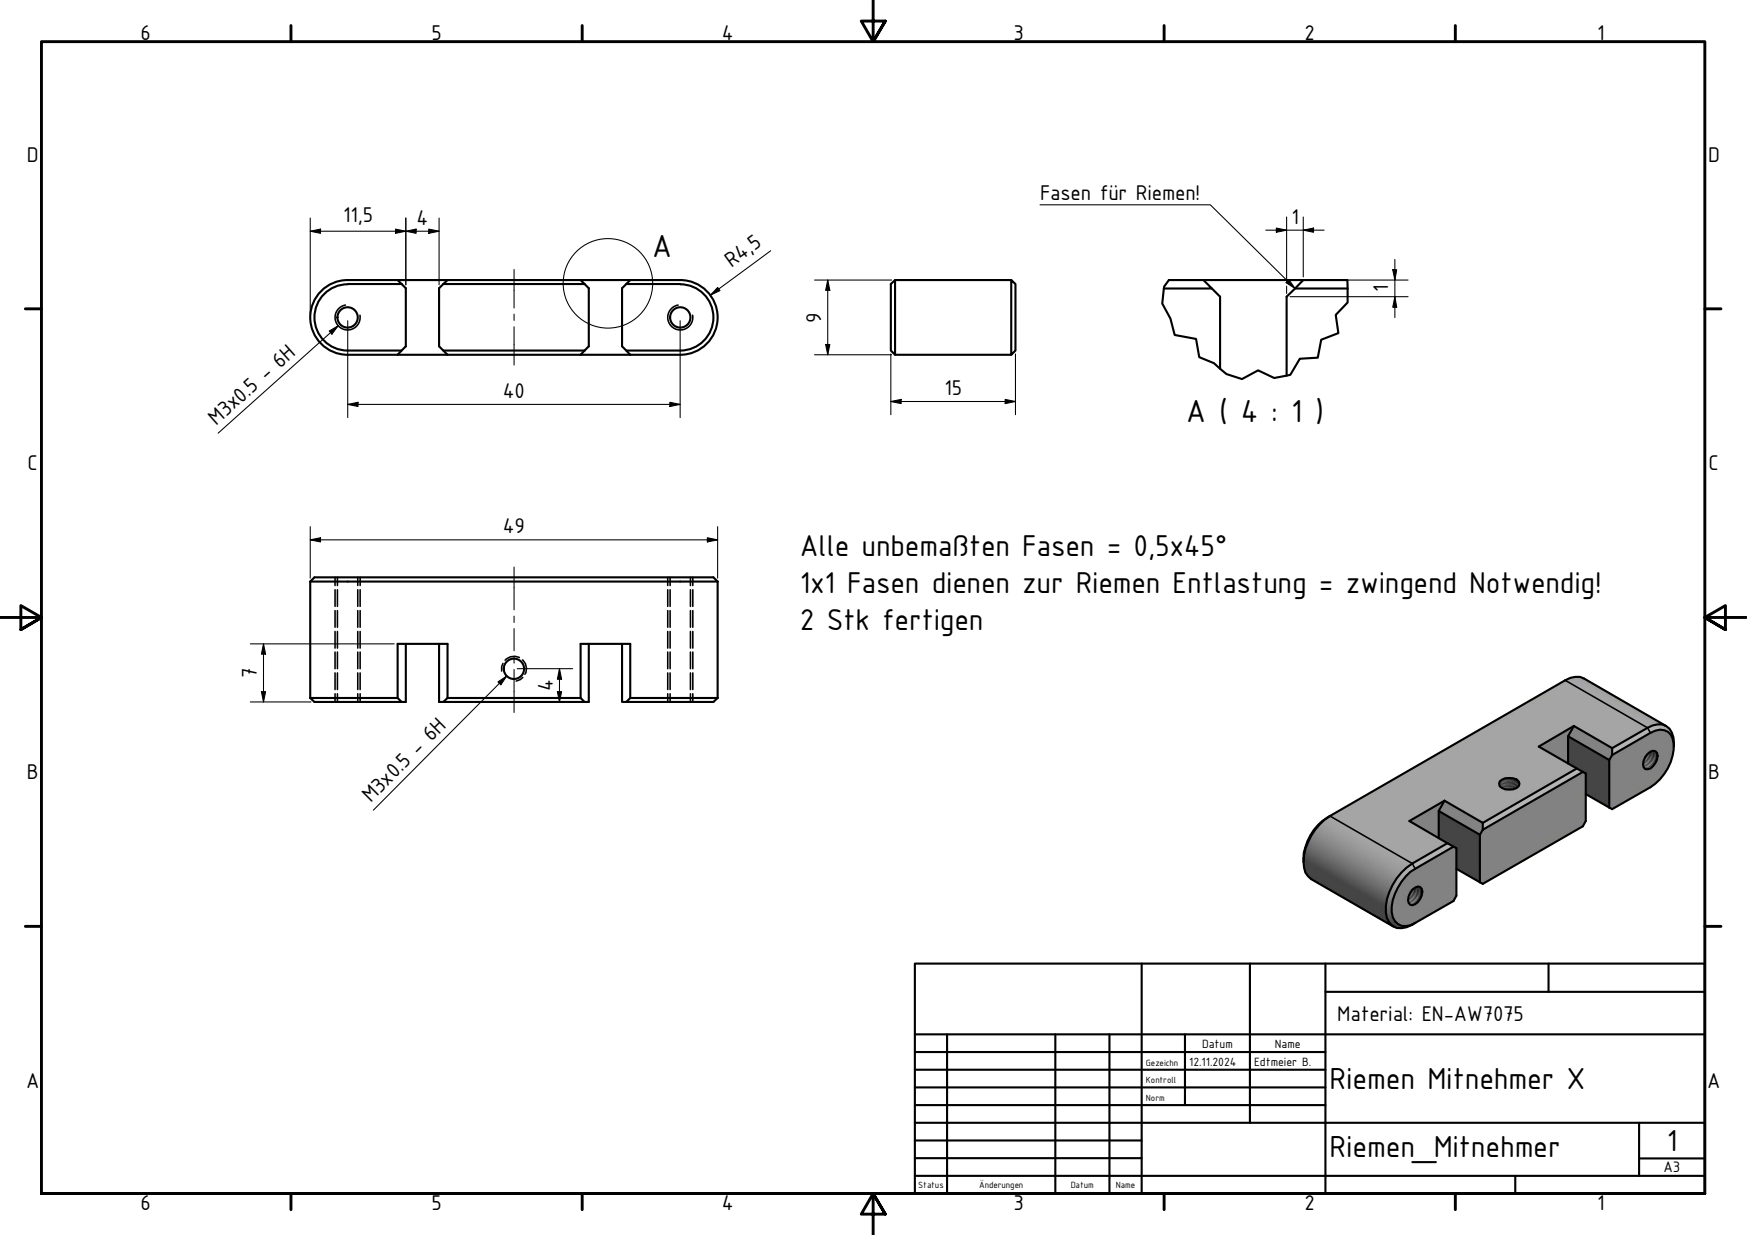
[picture p36: page 1]
Material: EN-AW7075; Fasen f¯r Riemen!

Alle unbematen Fasen = 0,5x45n
1x1 Fasen dienen zur Riemen Entlastung = zwingend Notwendig!
2 Stk fertigen

Datum | Name | Riemen Mitnehmer X

Gezeichn | 12.11.2024 | Edtmeier B.

Kontroll

Norm
