Edtison/EDTV4/hardware/cad/milled_parts/Riemenspanner X-Achse.pdf

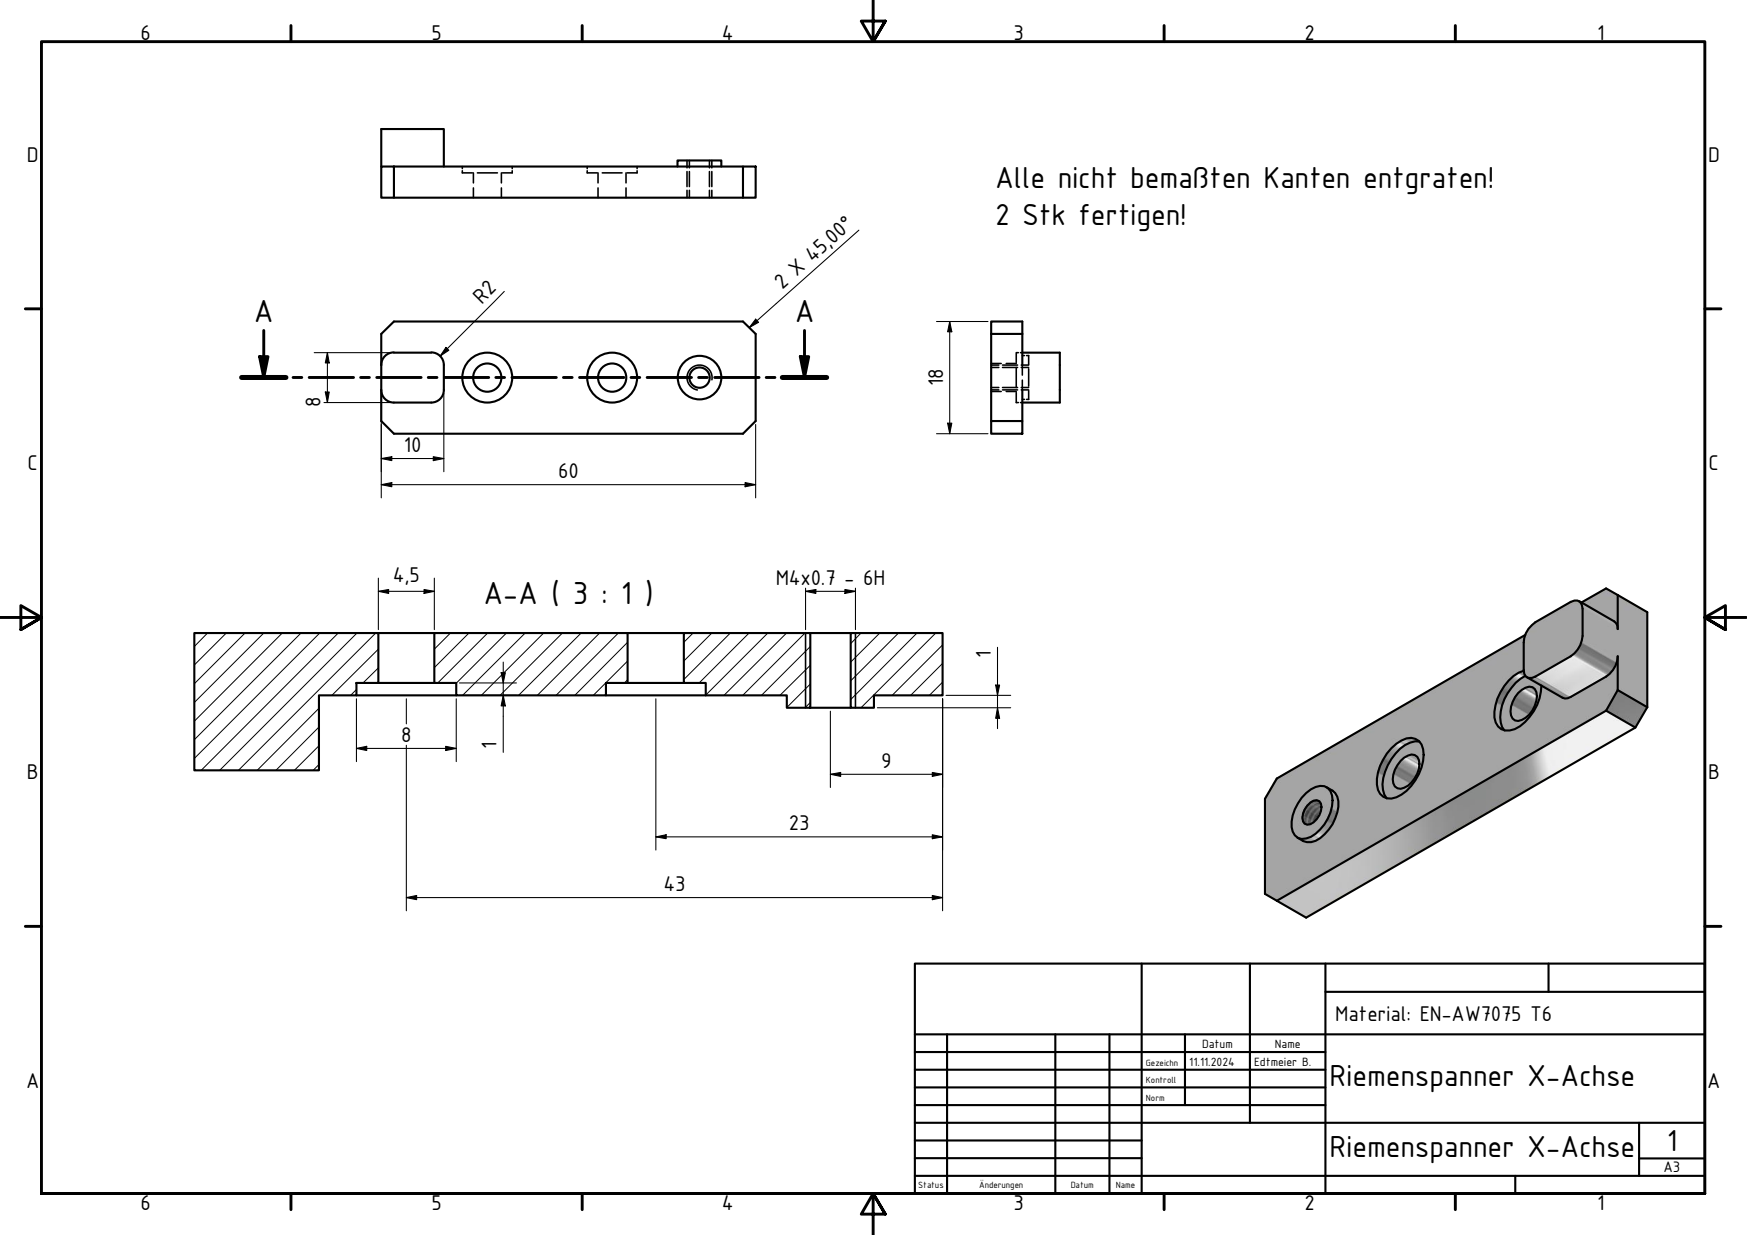
[picture p37: page 1]
Riemenspanner X-Achse; Material: EN-AW7075 T6

Alle nicht bematen Kanten entgraten!
2 Stk fertigen!

Datum | Name | Riemenspanner X-Achse

Gezeichn | 11.11.2024 | Edtmeier B.

Kontroll

Norm
