Edtison/EDTV4/hardware/cad/milled_parts/Traeger X-Achse Rechts.pdf

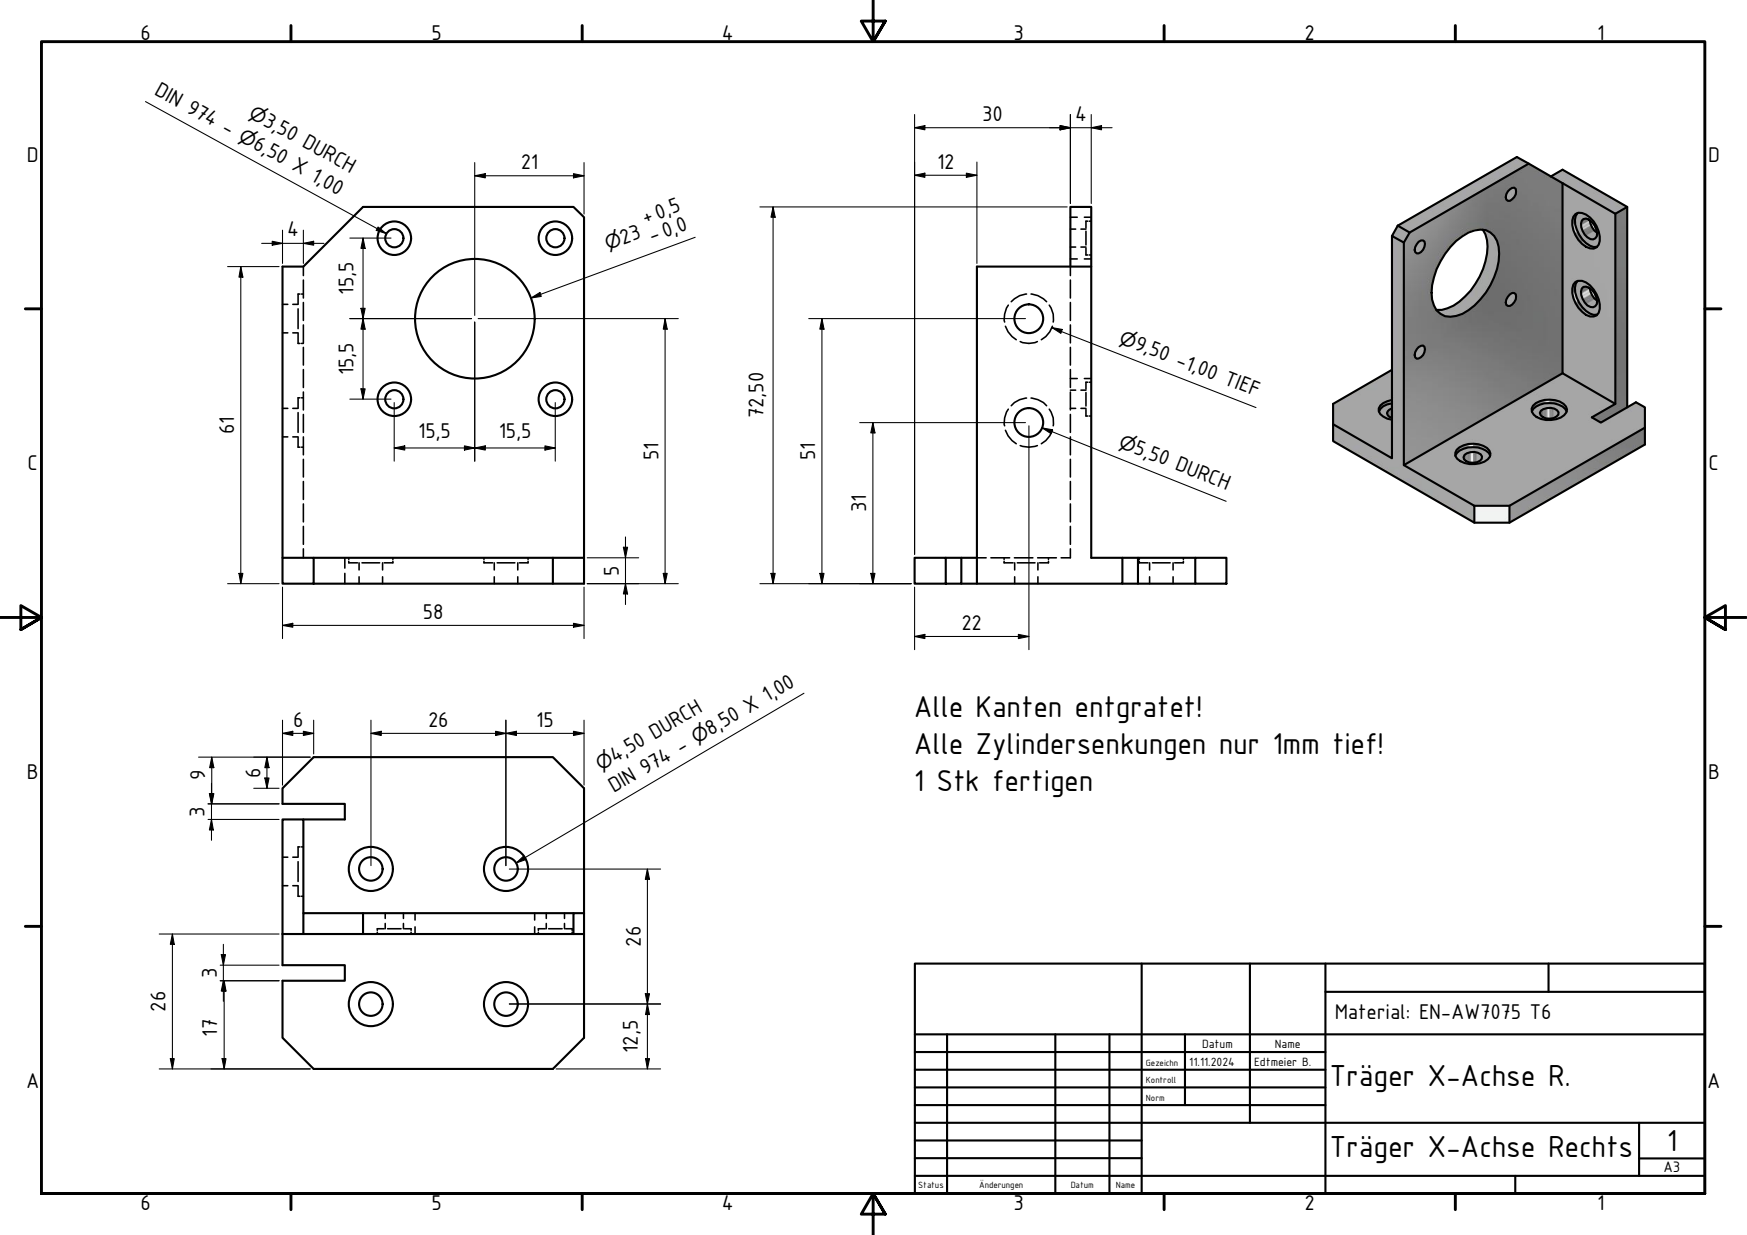
[picture p39: page 1]
Material: EN-AW7075 T6

Alle Kanten entgratet!
Alle Zylindersenkungen nur 1mm tief!
1 Stk fertigen

Datum | Name | Trger X-Achse R.

Gezeichn | 11.11.2024 | Edtmeier B.

Kontroll

Norm

Trger X-Achse Rechts
