Edtison/EDTV4/hardware/cad/sheetmetal/Abstandsblech_Dichtung_Tuer.pdf

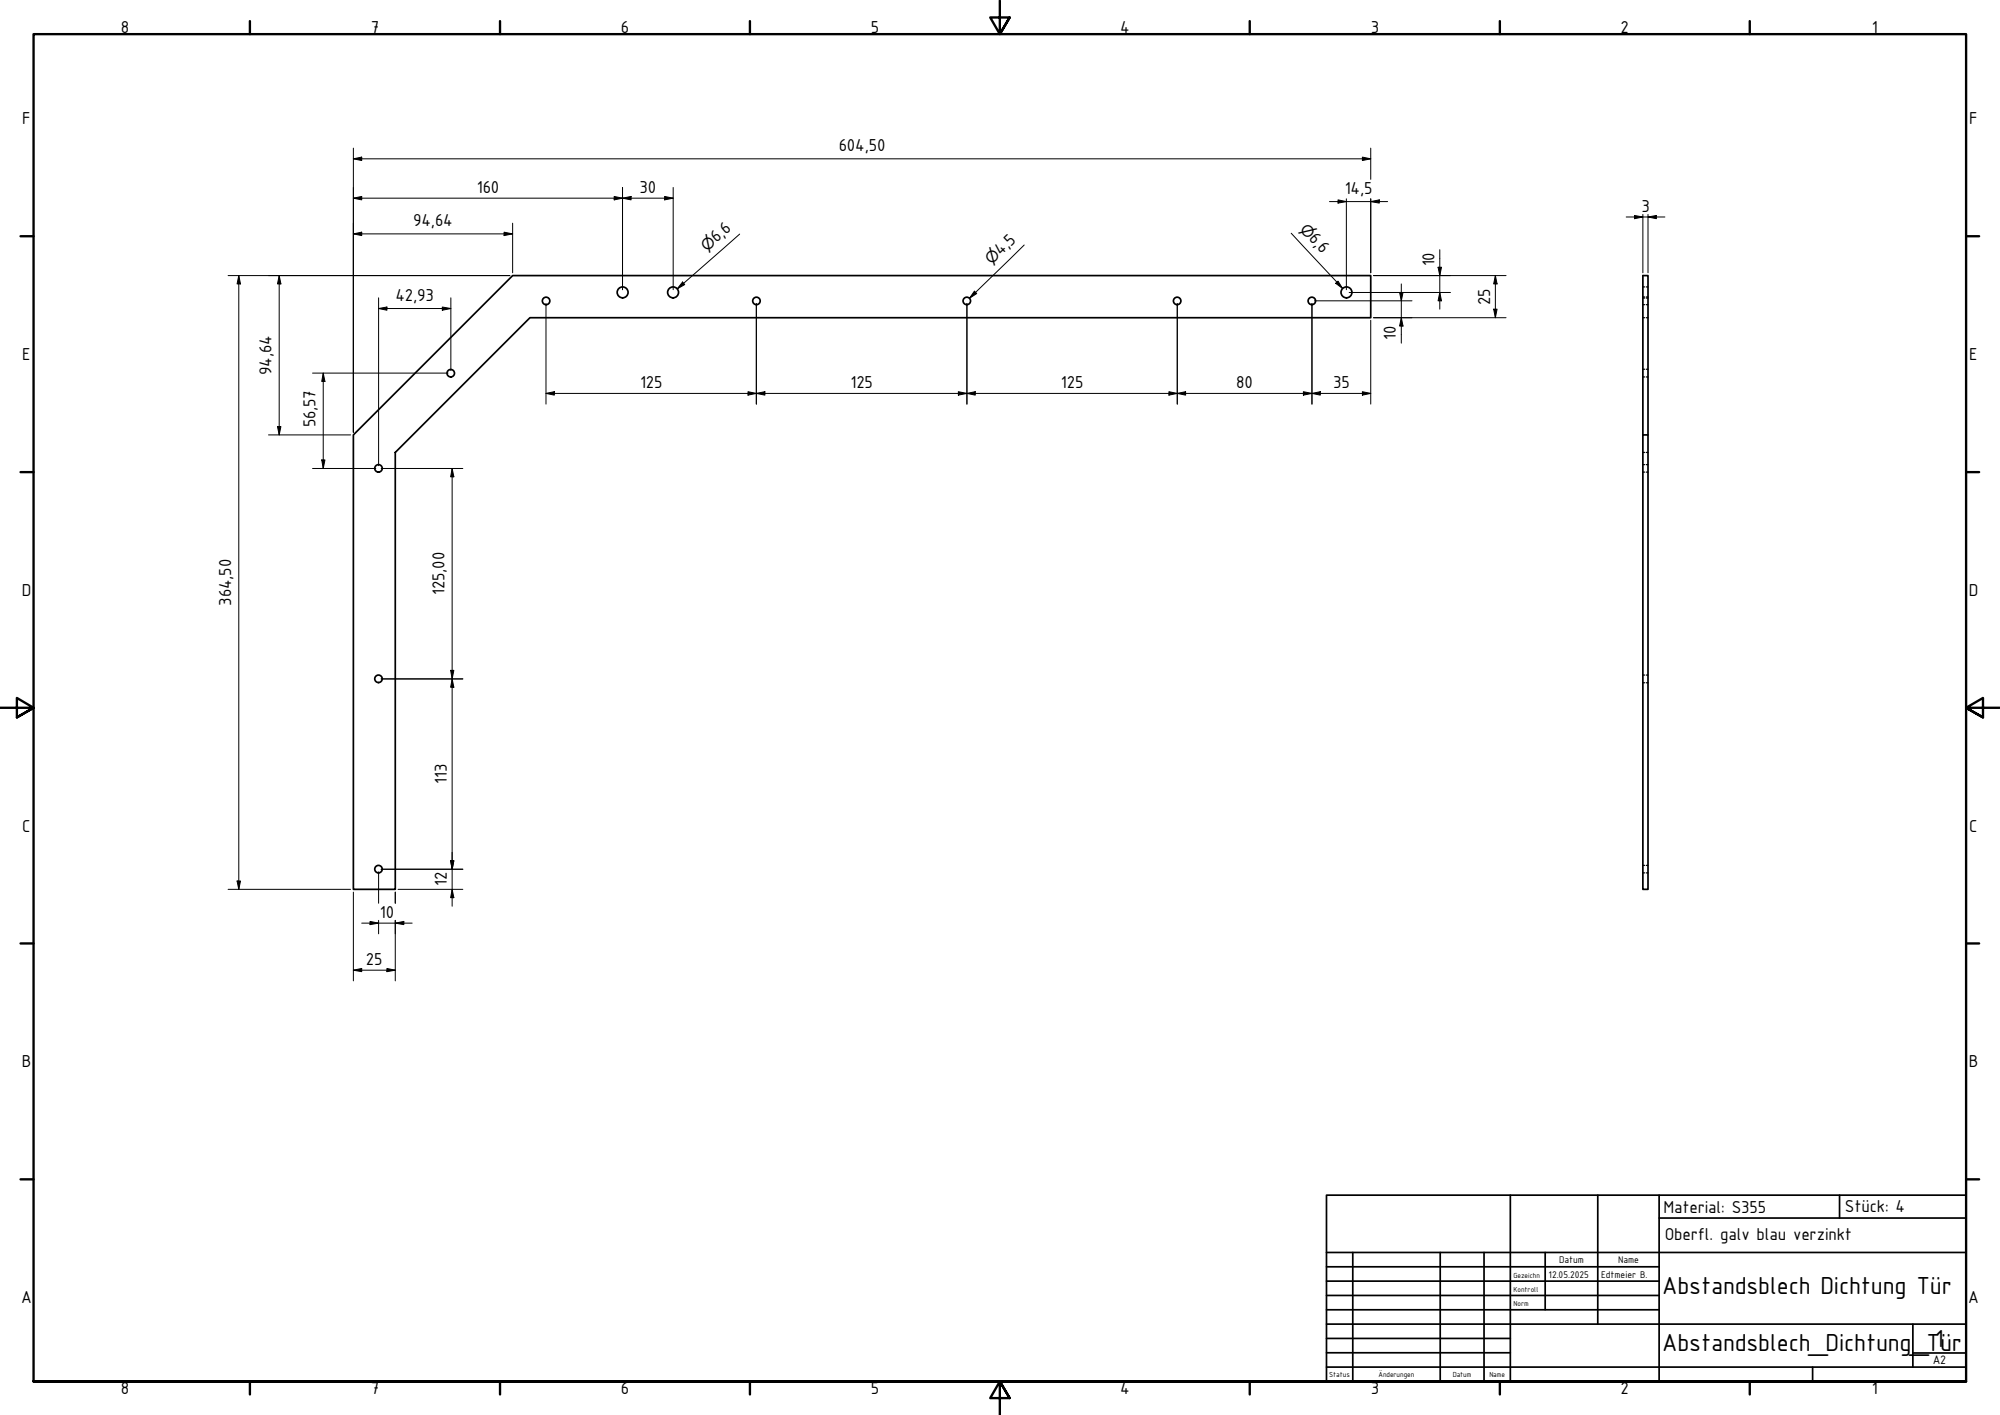
[picture p40: page 1]
Material: S355

Oberfl. galv blau verzinkt

Datum | Name | Abstandsblech Dichtung T¯r

Gezeichn | 12.05.2025 | Edtmeier B.

Kontroll

Norm
