Edtison/EDTV4/hardware/cad/sheetmetal/BL-Touch_HalterungsBlech.pdf

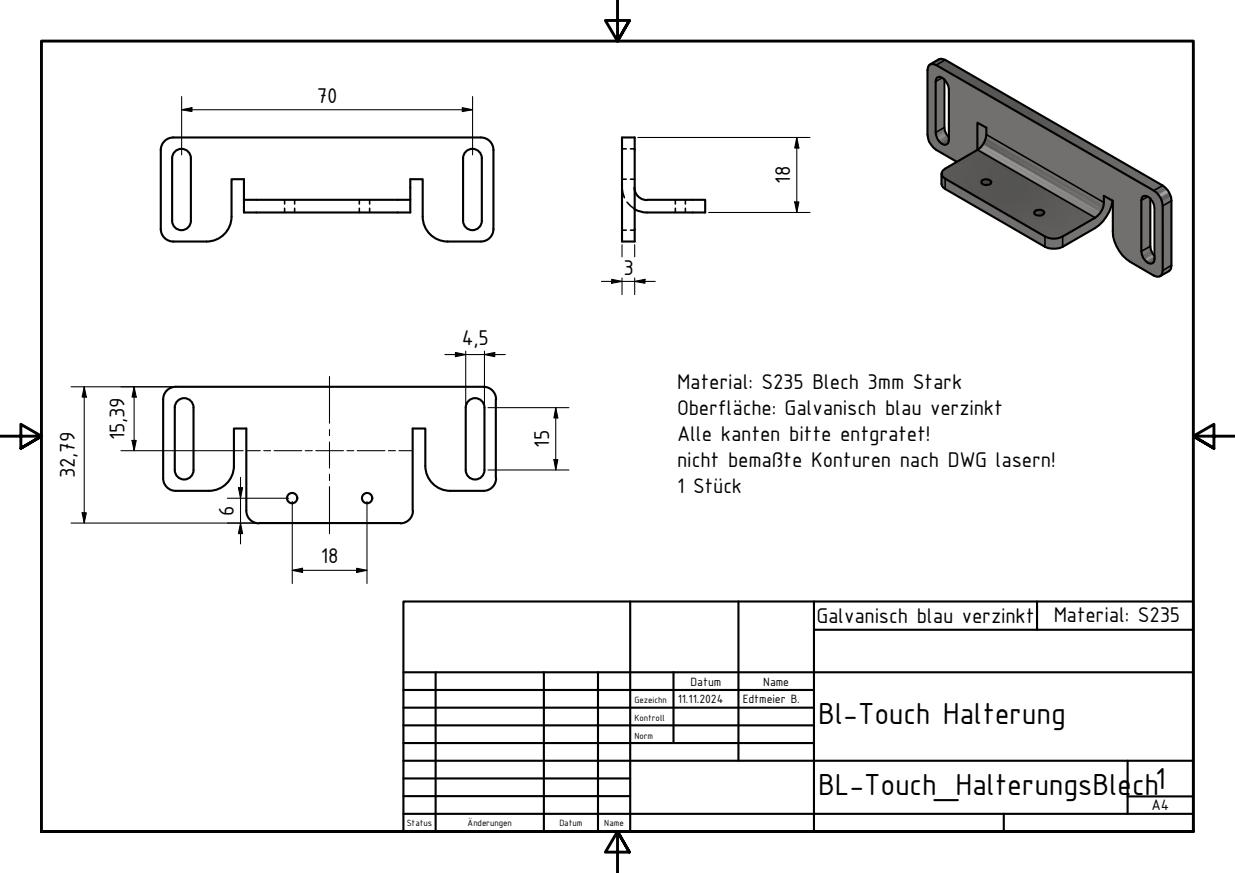
[picture p41: page 1]
Galvanisch blau verzinkt; Material: S235

Material: S235 Blech 3mm Stark
Oberflche: Galvanisch blau verzinkt
Alle kanten bitte entgratet!
nicht bemate Konturen nach DWG lasern!

Datum | Name | Bl-Touch Halterung

Gezeichn | 11.11.2024 | Edtmeier B.

Kontroll

Norm
