Edtison/EDTV4/hardware/cad/sheetmetal/Blech_Spindelmutter_zu_Traeger.pdf

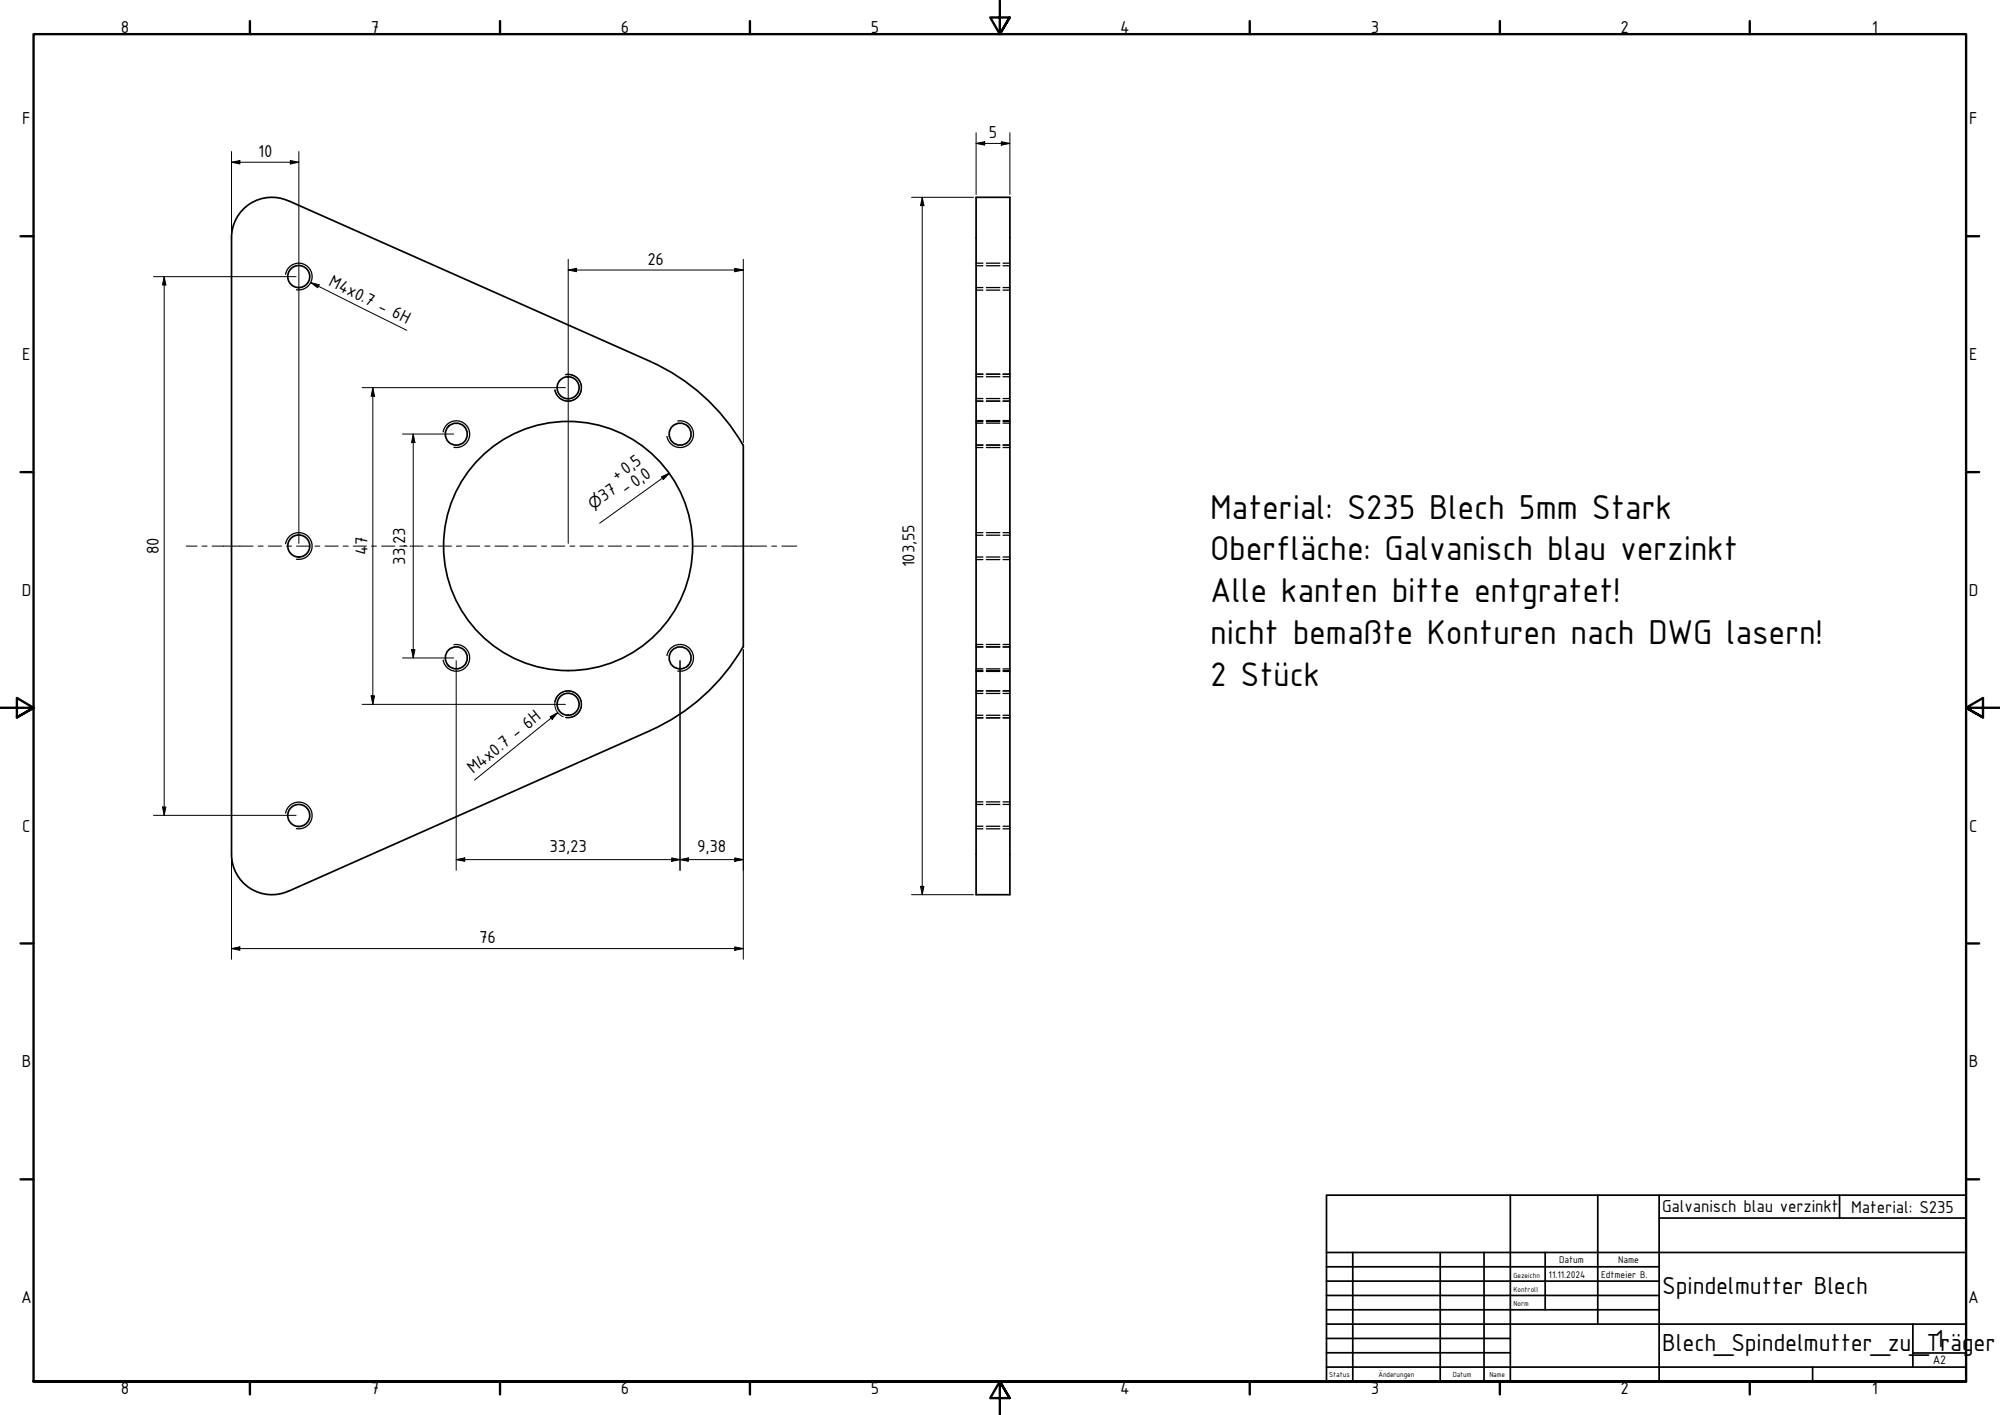
[picture p42: page 1]
Galvanisch blau verzinkt; Material: S235

Material: S235 Blech 5mm Stark
Oberflche: Galvanisch blau verzinkt
Alle kanten bitte entgratet!
nicht bemate Konturen nach DWG lasern!

Datum | Name | Spindelmutter Blech

Gezeichn | 11.11.2024 | Edtmeier B.

Kontroll

Norm
