Edtison/EDTV4/hardware/cad/sheetmetal/Blechhalterung_Y_Motoren.pdf

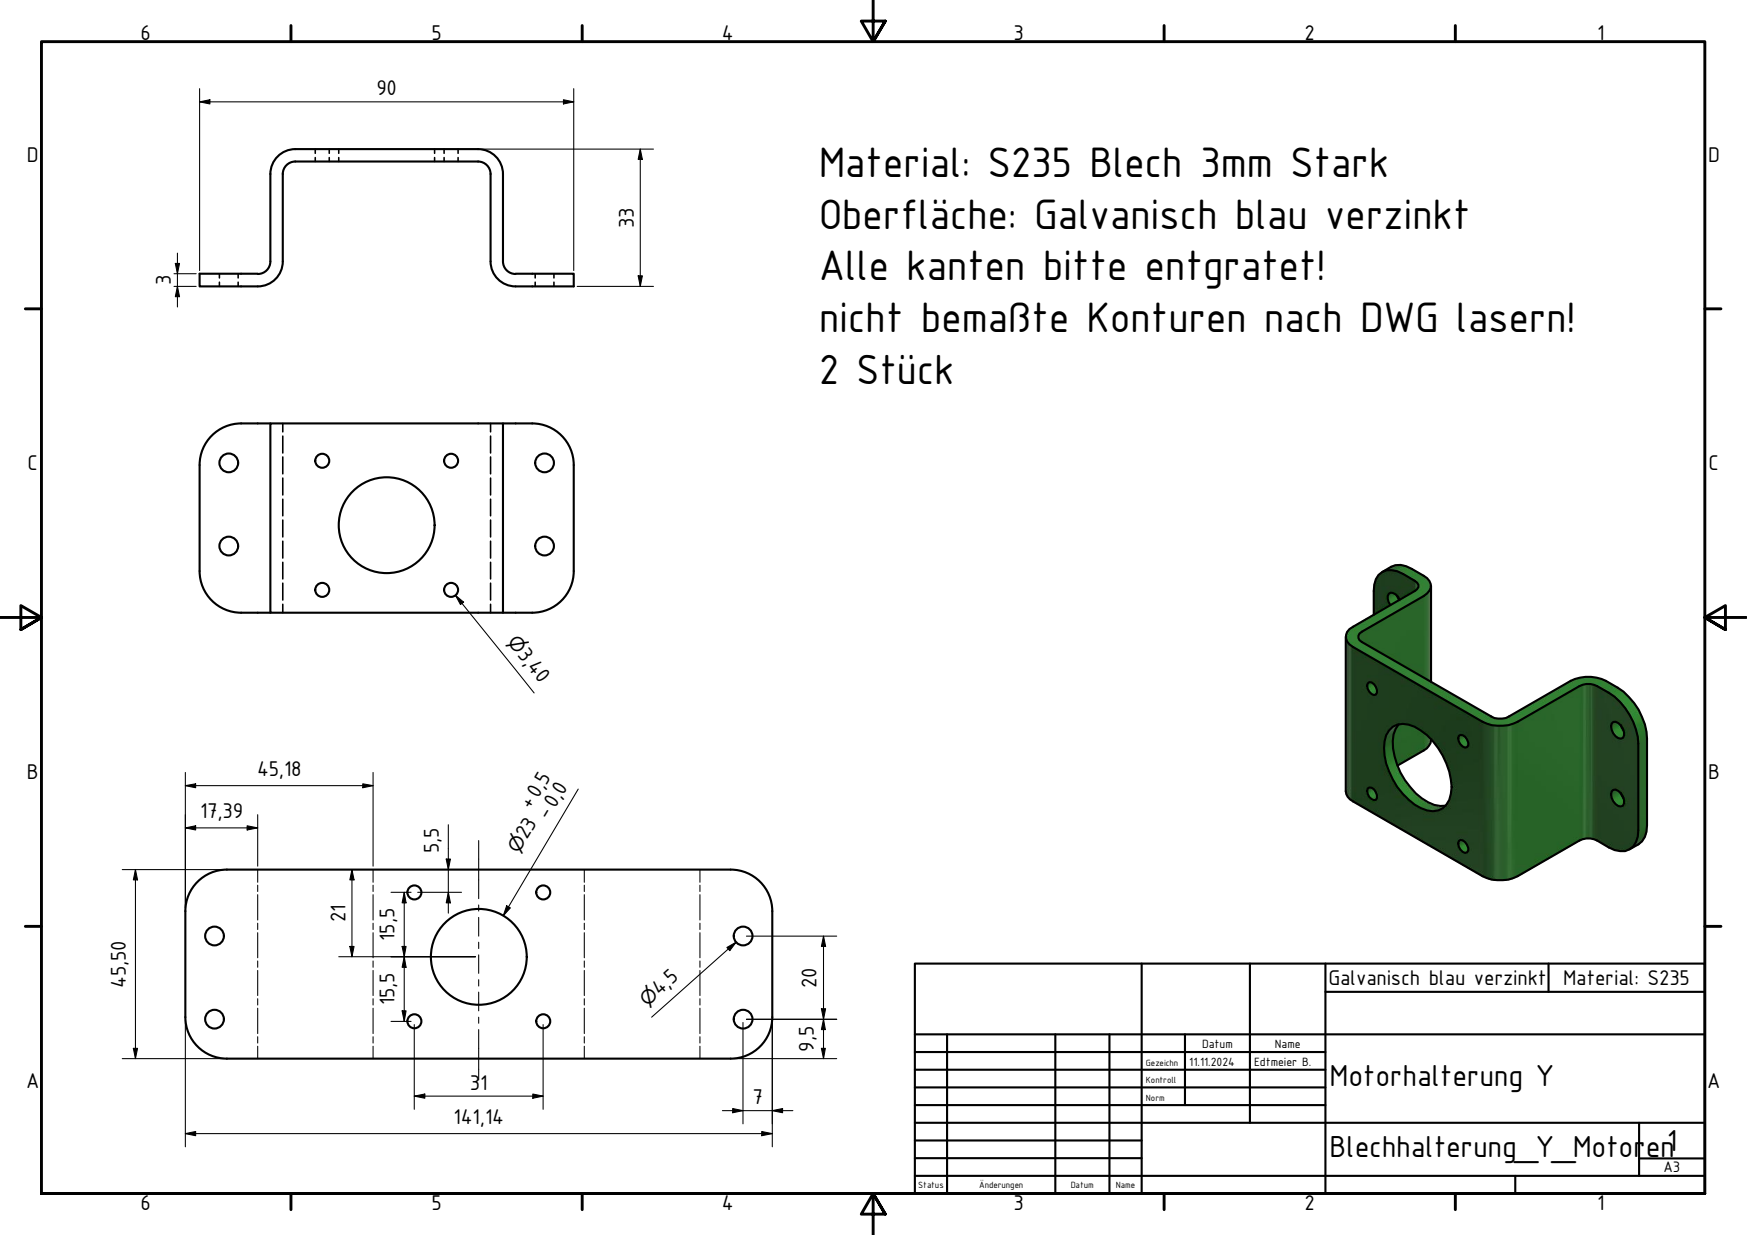
[picture p43: page 1]
Galvanisch blau verzinkt; Material: S235

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

Datum | Name | Motorhalterung Y

Gezeichn | 11.11.2024 | Edtmeier B.

Kontroll

Norm
