Edtison/EDTV4/hardware/cad/sheetmetal/Bodenplatte.pdf

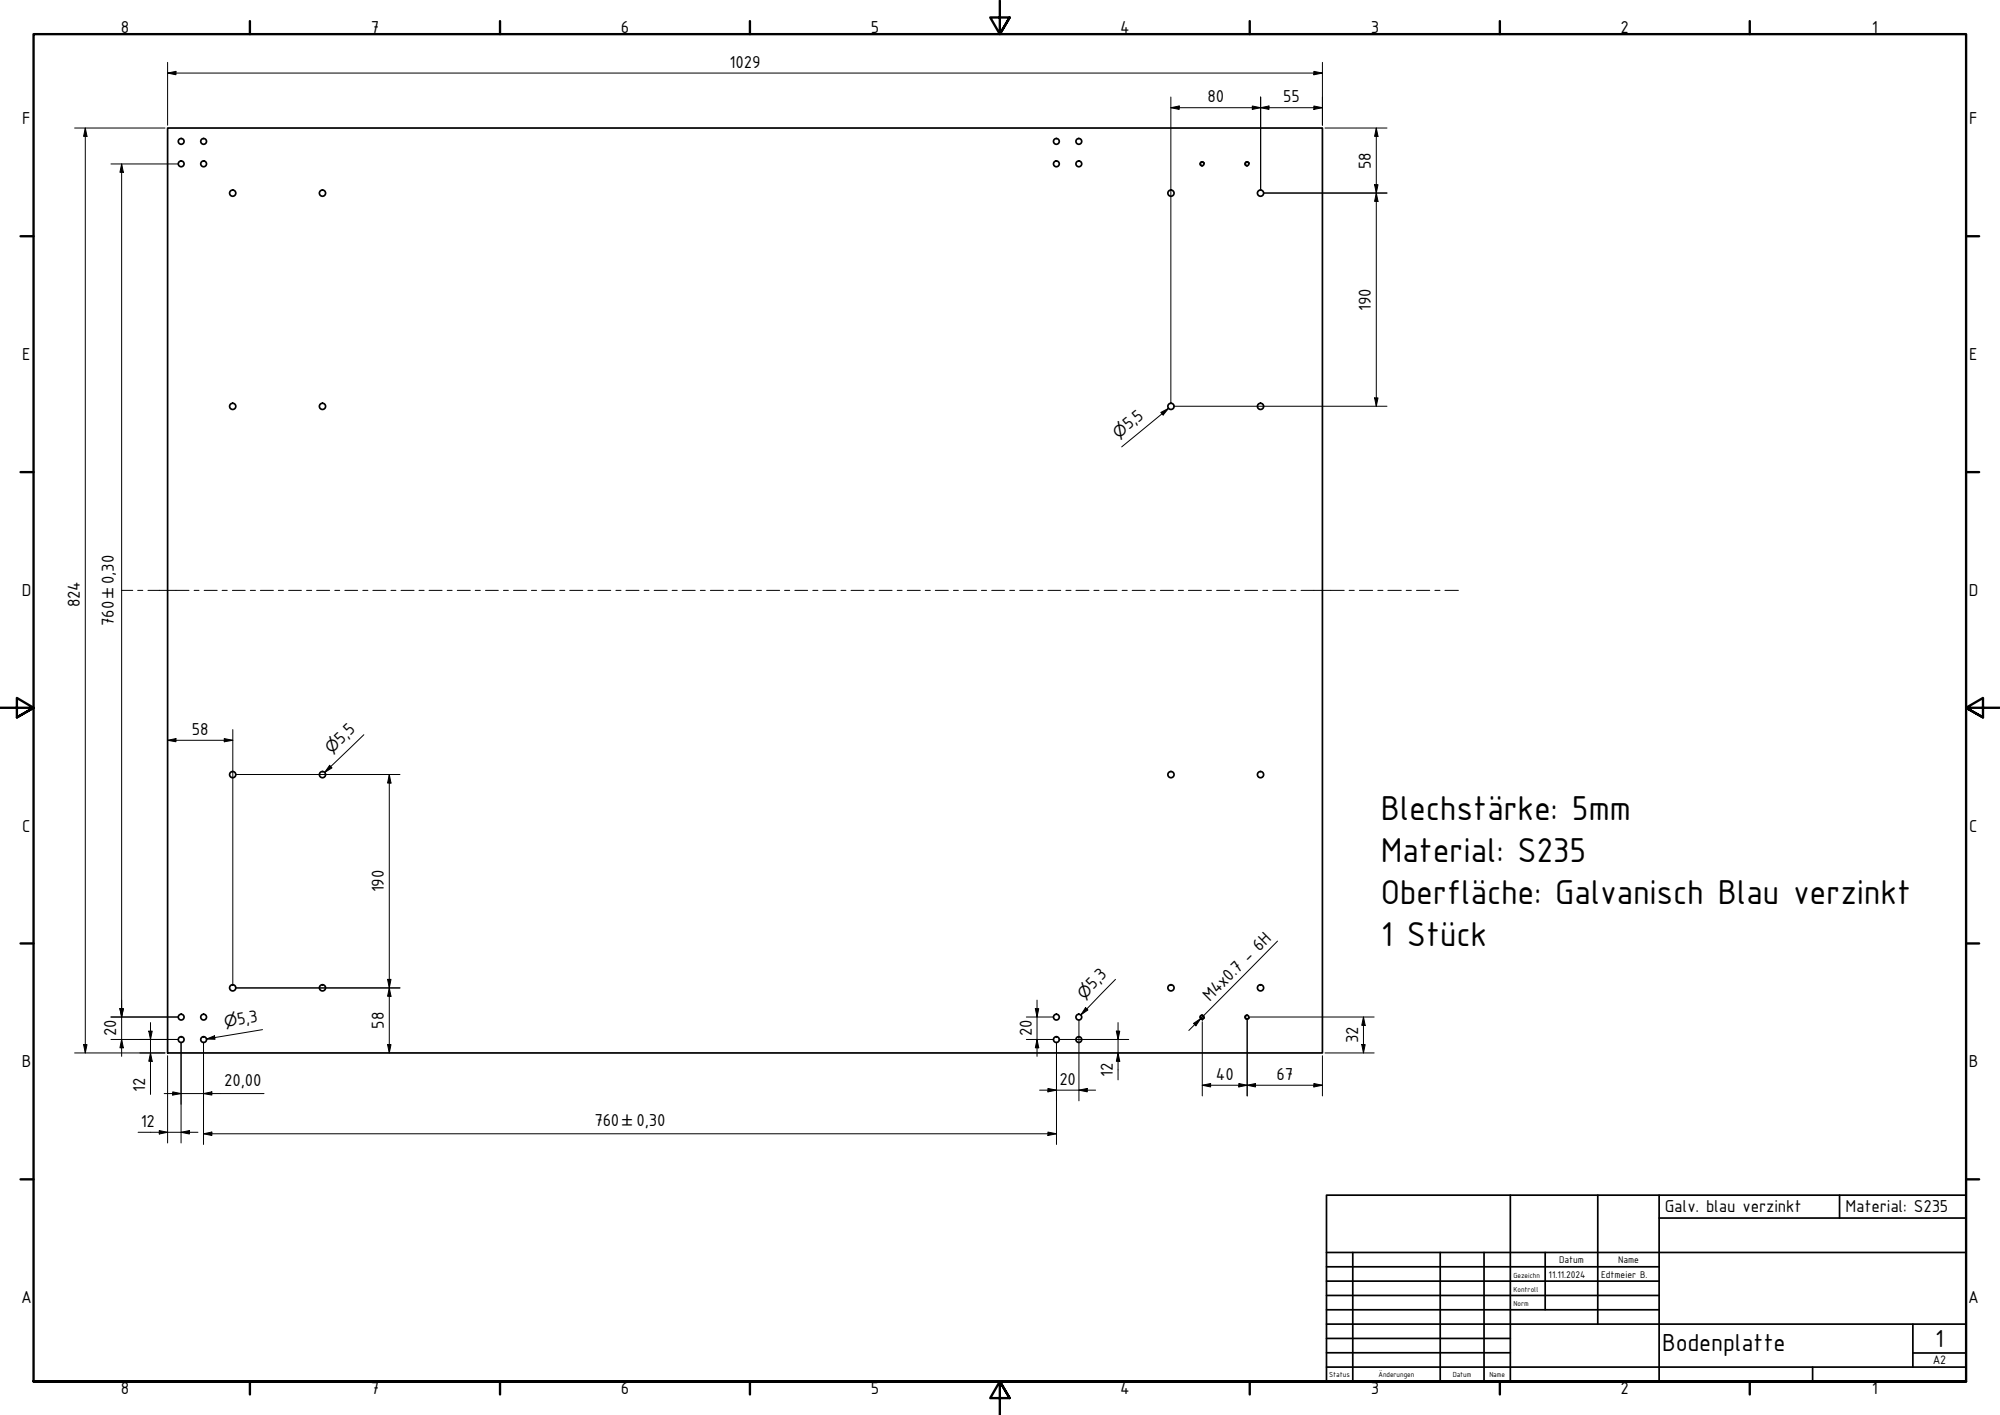
[picture p44: page 1]
Galv. blau verzinkt; Material: S235

Blechstrke: 5mm
Material: S235
Oberflche: Galvanisch Blau verzinkt

Datum | Name

Gezeichn | 11.11.2024 | Edtmeier B.

Kontroll

Norm
