Edtison/EDTV4/hardware/cad/sheetmetal/Bodenplatte_Winkel_Verstaerkung.pdf

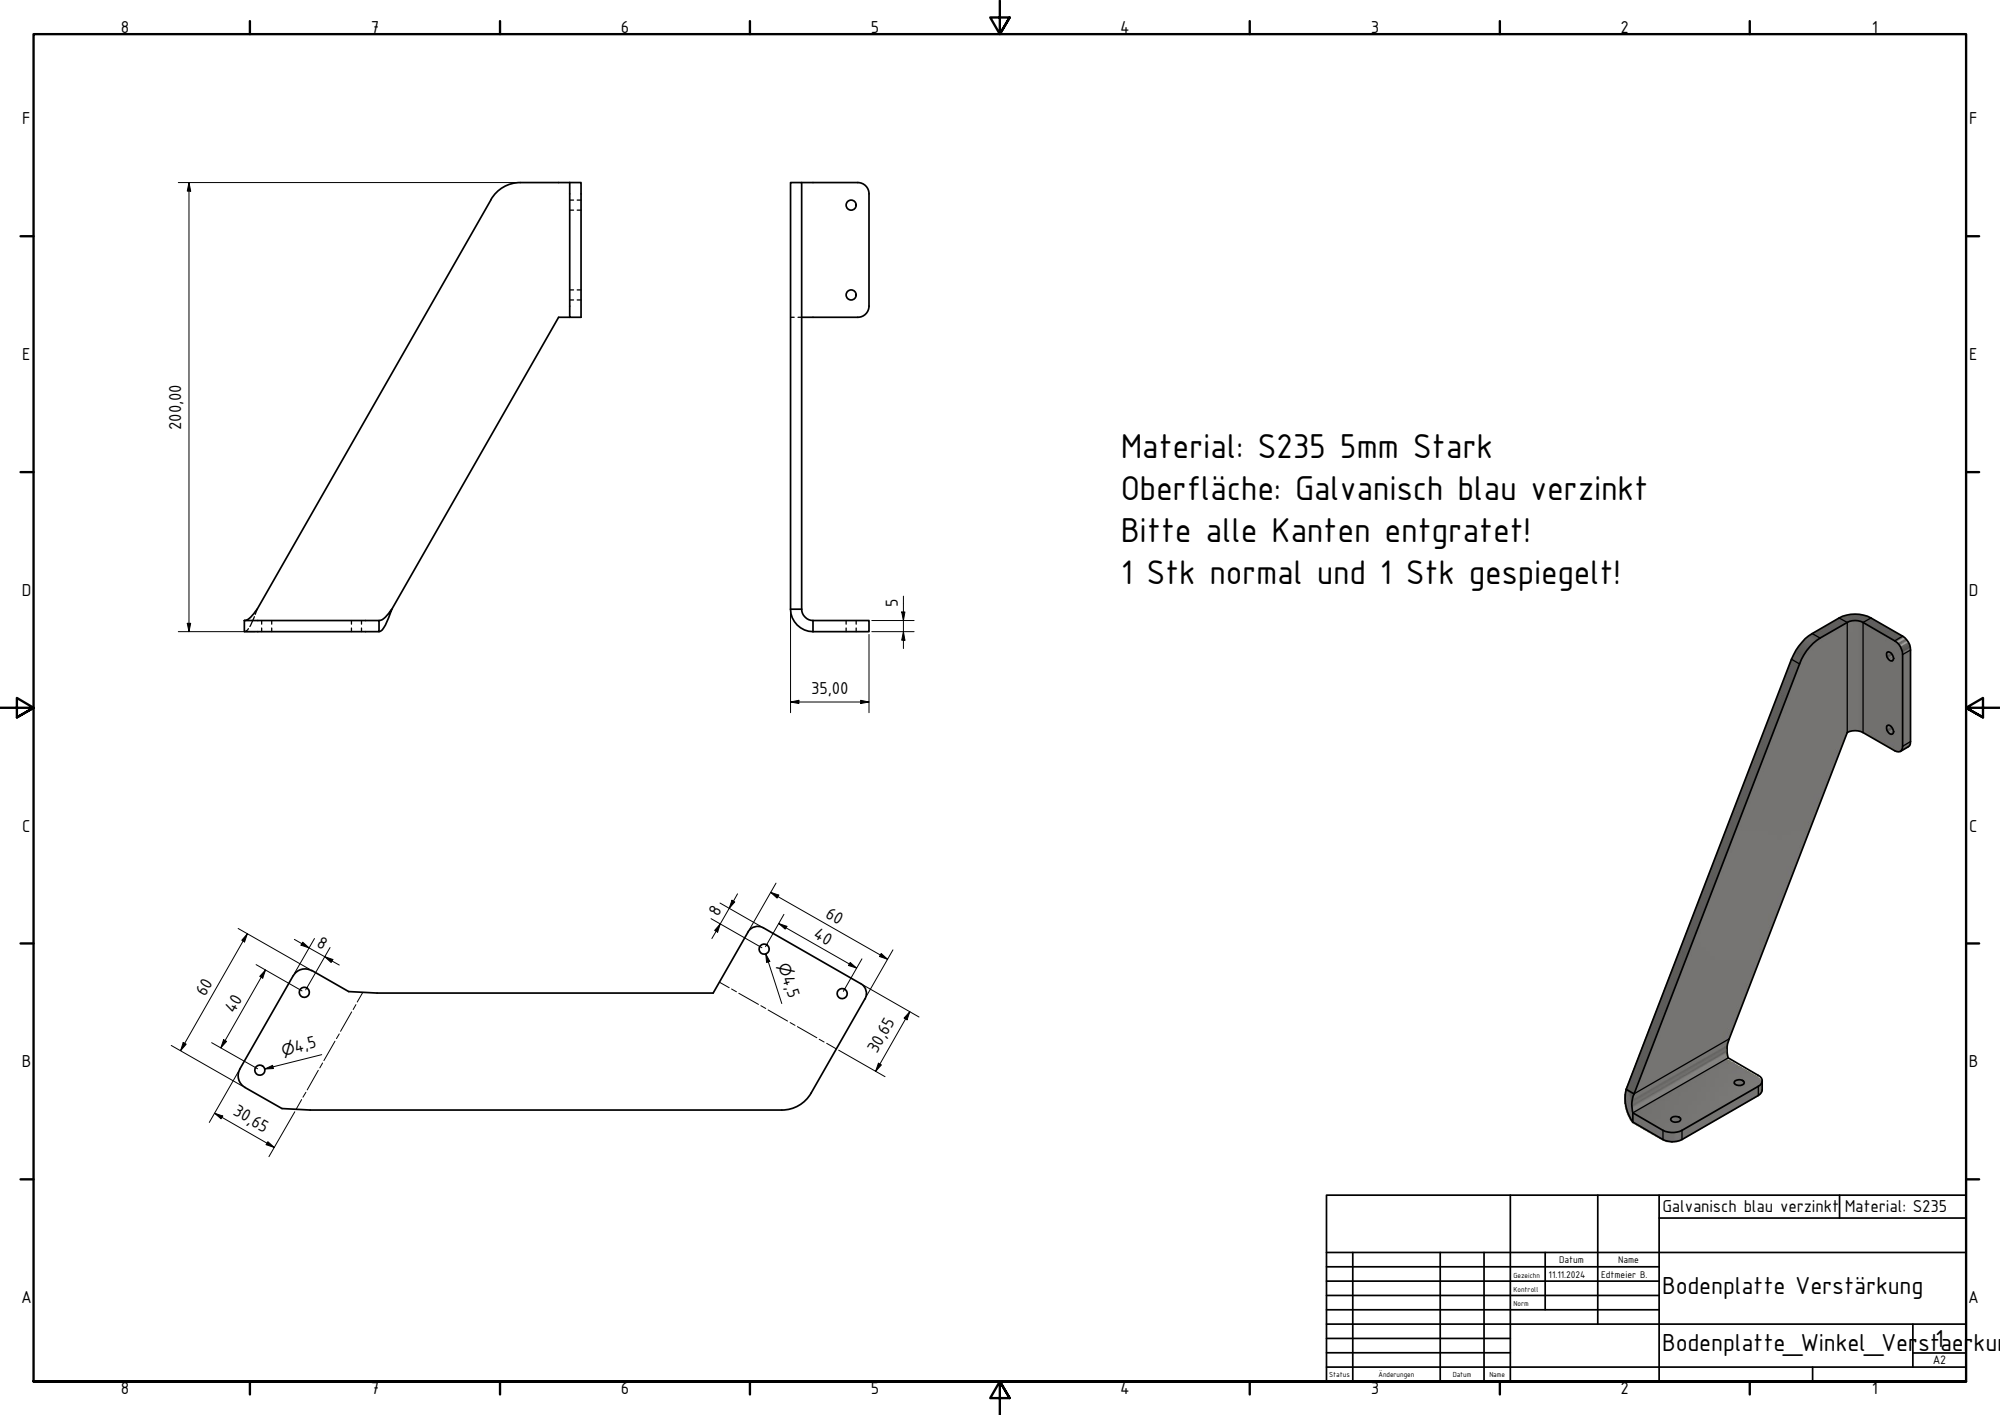
[picture p45: page 1]
Galvanisch blau verzinkt; Material: S235

Material: S235 5mm Stark
Oberflche: Galvanisch blau verzinkt
Bitte alle Kanten entgratet!
1 Stk normal und 1 Stk gespiegelt!

Datum | Name | Bodenplatte Verstrkung

Gezeichn | 11.11.2024 | Edtmeier B.

Kontroll

Norm
