Edtison/EDTV4/hardware/cad/sheetmetal/Deckel_Haube.pdf

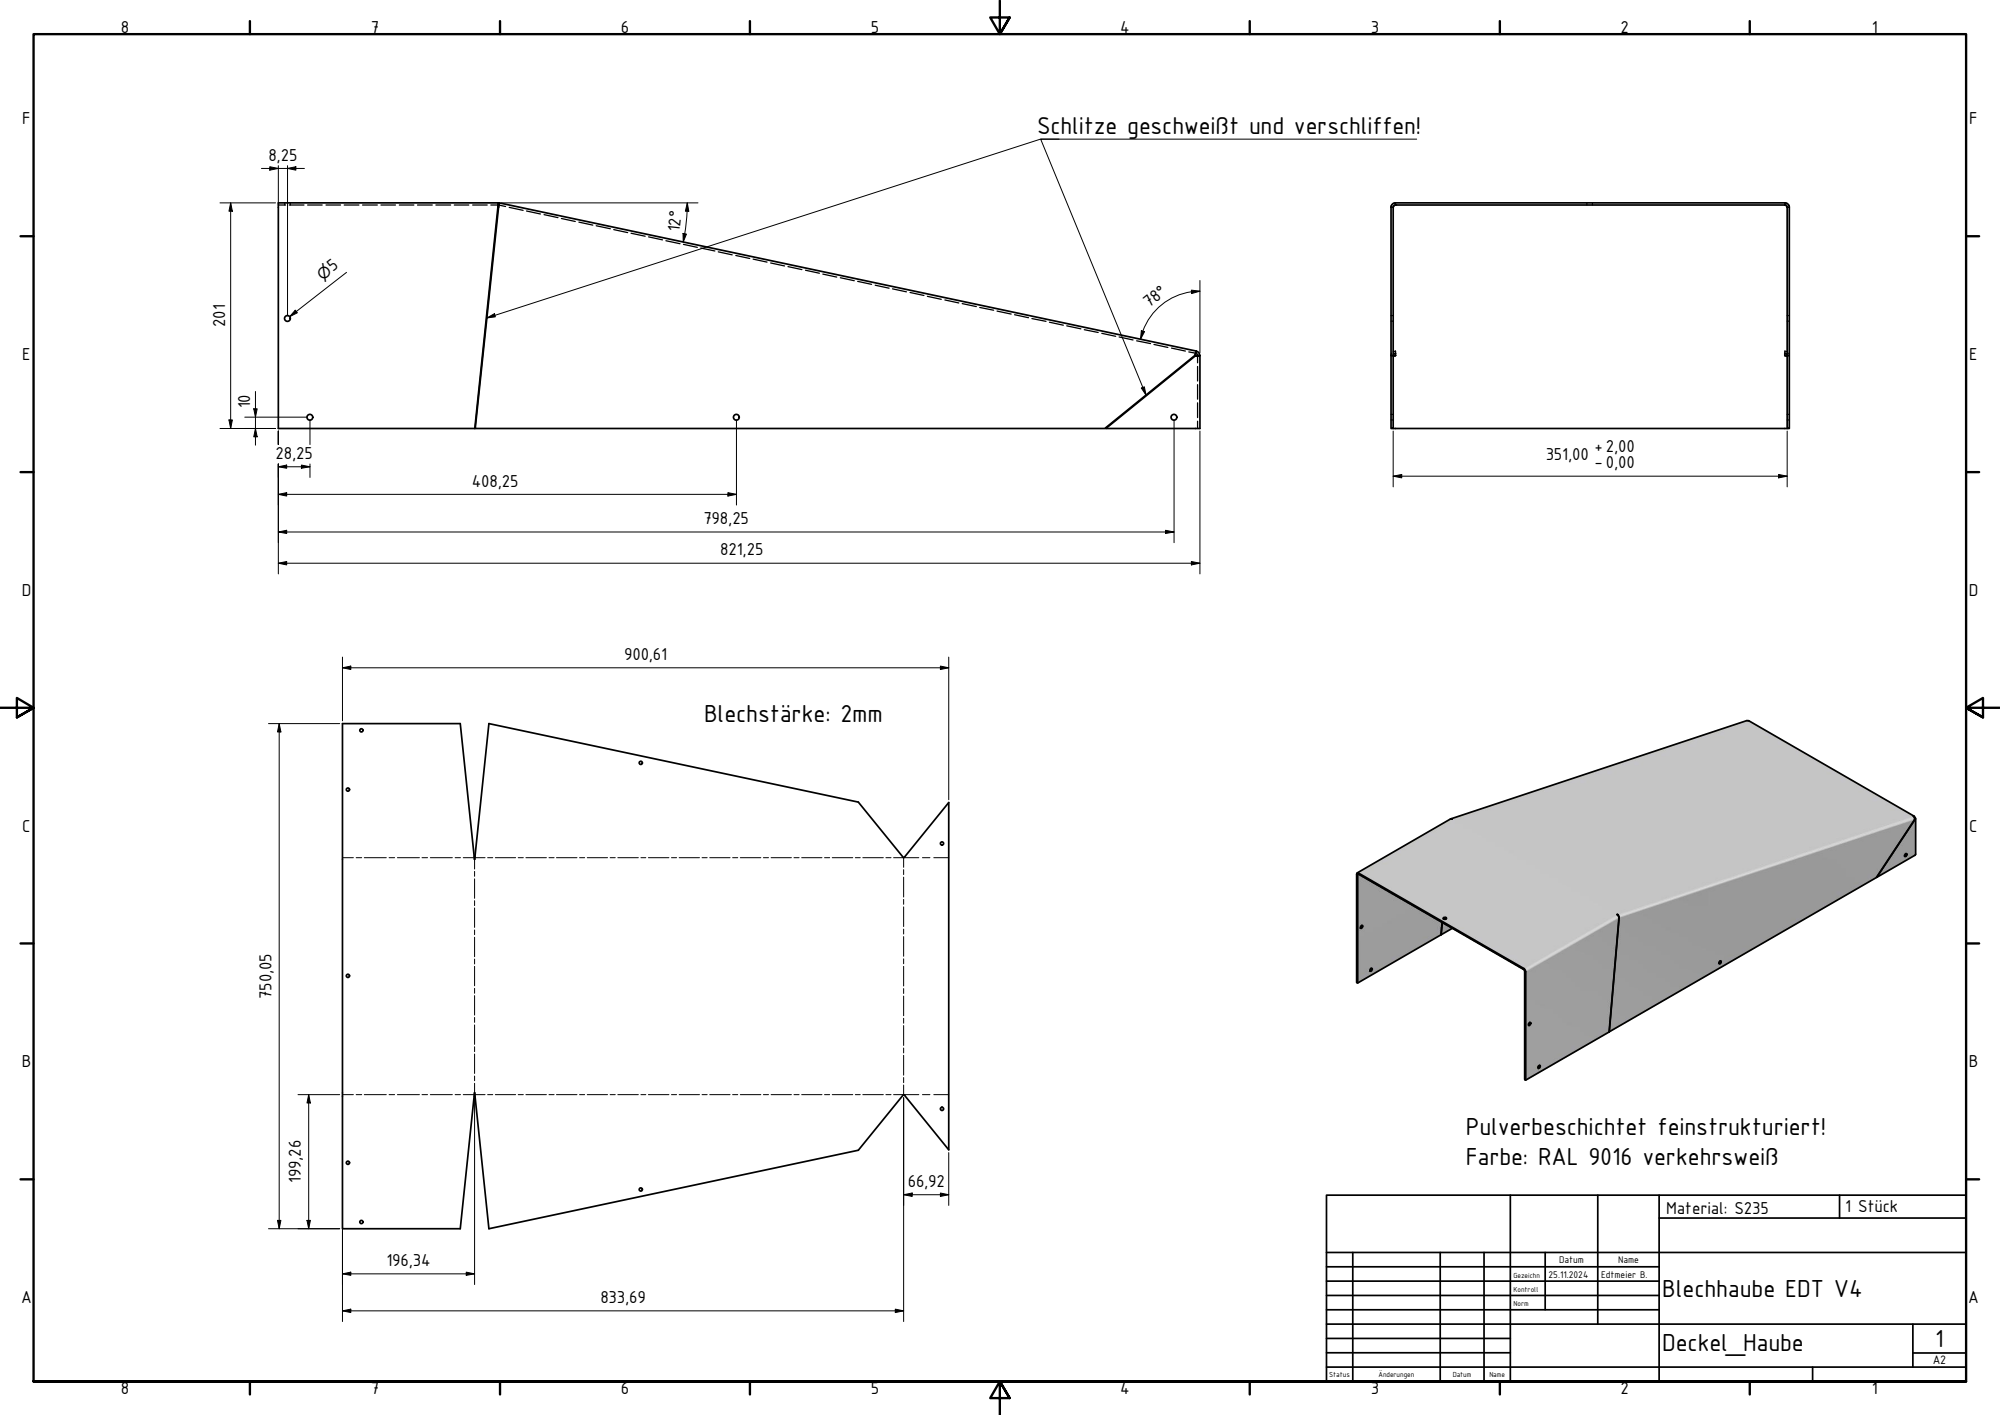
[picture p46: page 1]
Material: S235

Schlitze geschweit und verschliffen!

Pulverbeschichtet feinstrukturiert!
Farbe: RAL 9016 verkehrswei

Datum | Name | Blechhaube EDT V4

Gezeichn | 25.11.2024 | Edtmeier B.

Kontroll

Norm
