Edtison/EDTV4/hardware/cad/sheetmetal/Deckplatte.pdf

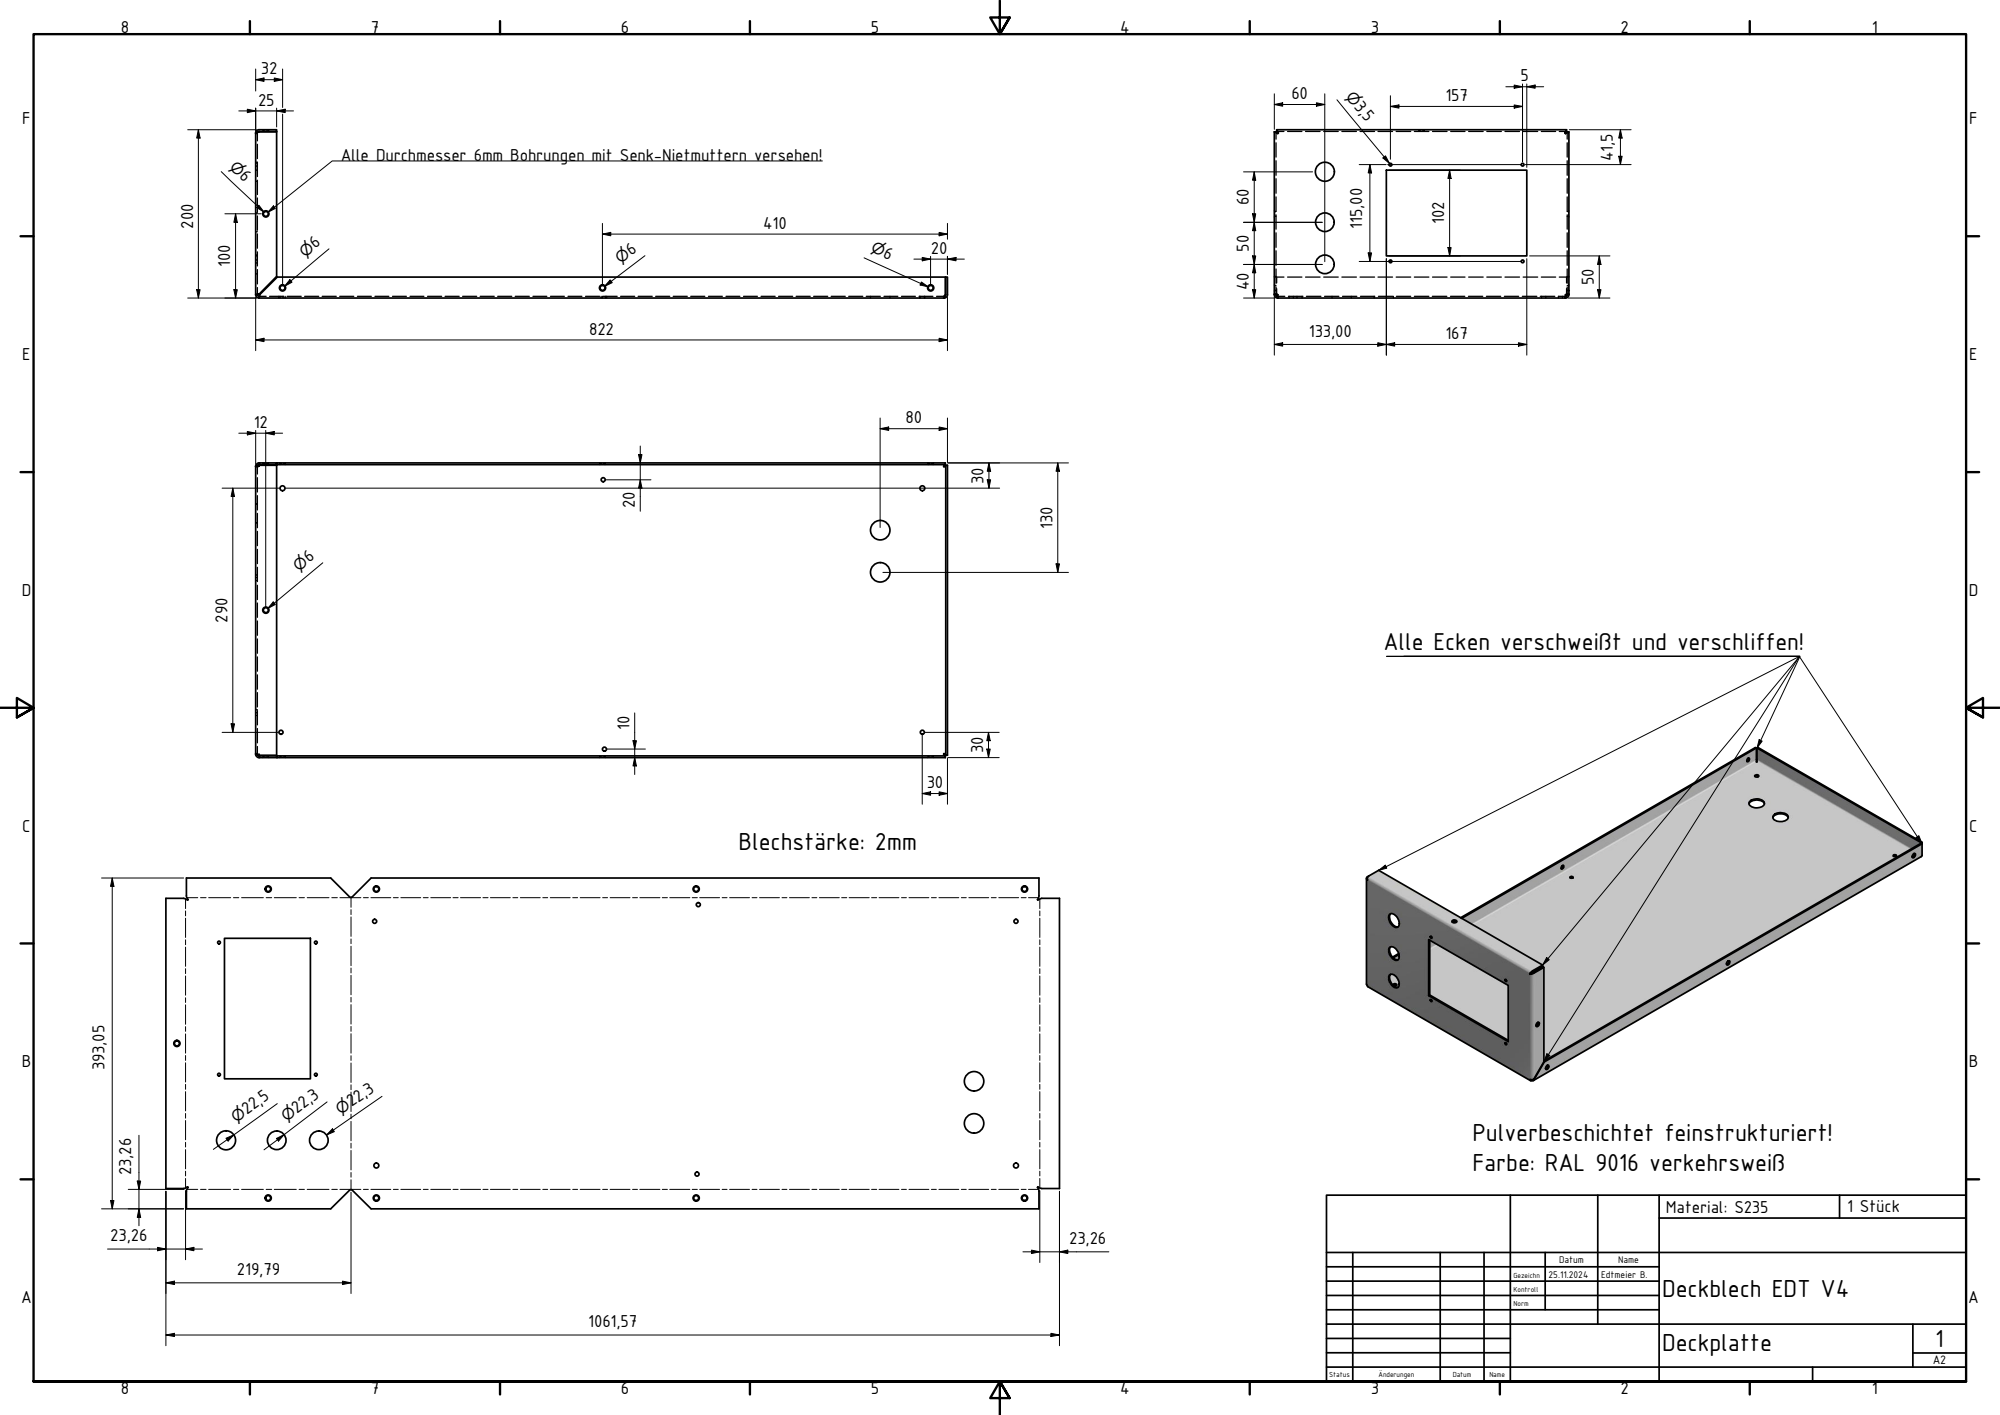
[picture p47: page 1]
Material: S235

Alle Durchmesser 6mm Bohrungen mit Senk-Nietmuttern versehen! 6

Alle Ecken verschweit und verschliffen!

Pulverbeschichtet feinstrukturiert!
Farbe: RAL 9016 verkehrswei

Datum | Name | Deckblech EDT V4

Gezeichn | 25.11.2024 | Edtmeier B.

Kontroll

Norm
