Edtison/EDTV4/hardware/cad/sheetmetal/Dichtungsblech.pdf

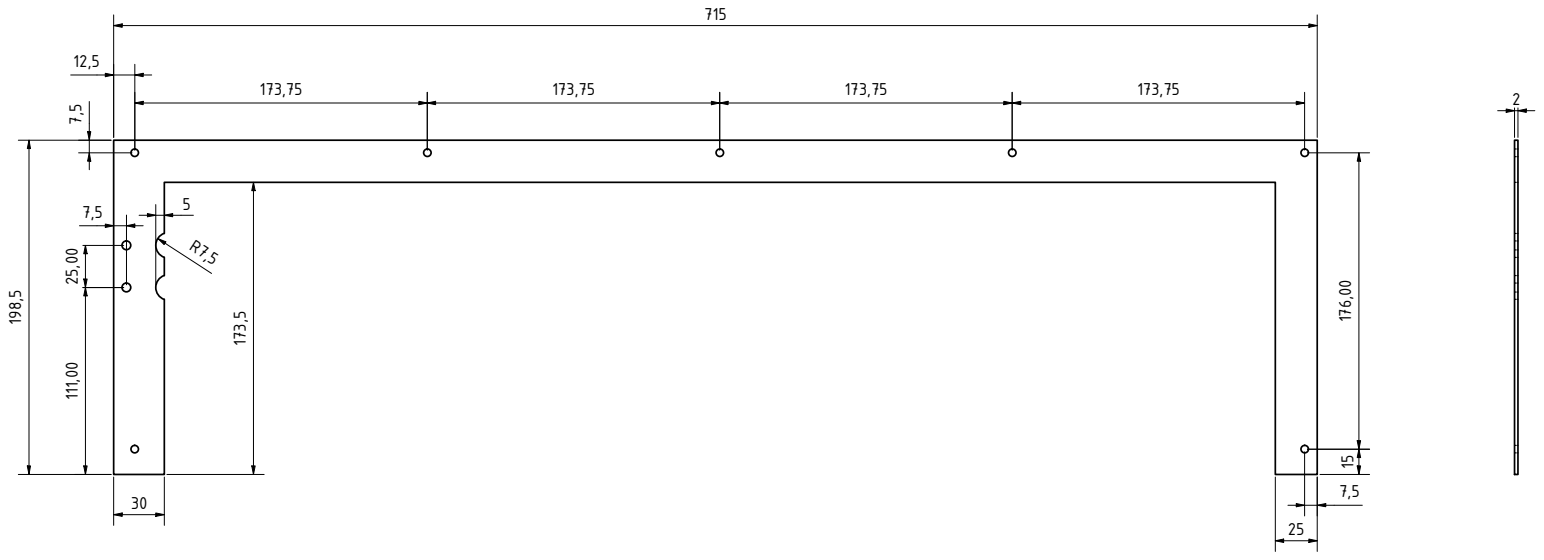
[picture p48: page 1]
Material: S355

Oberflche galv. blau verzinkt

Datum | Name | Dichtungsblech Klappe

Gezeichn | 12.05.2025 | Edtmeier B.

Kontroll

Norm
