Edtison/EDTV4/hardware/cad/sheetmetal/Dichtungsblech_Tuer_Front.pdf

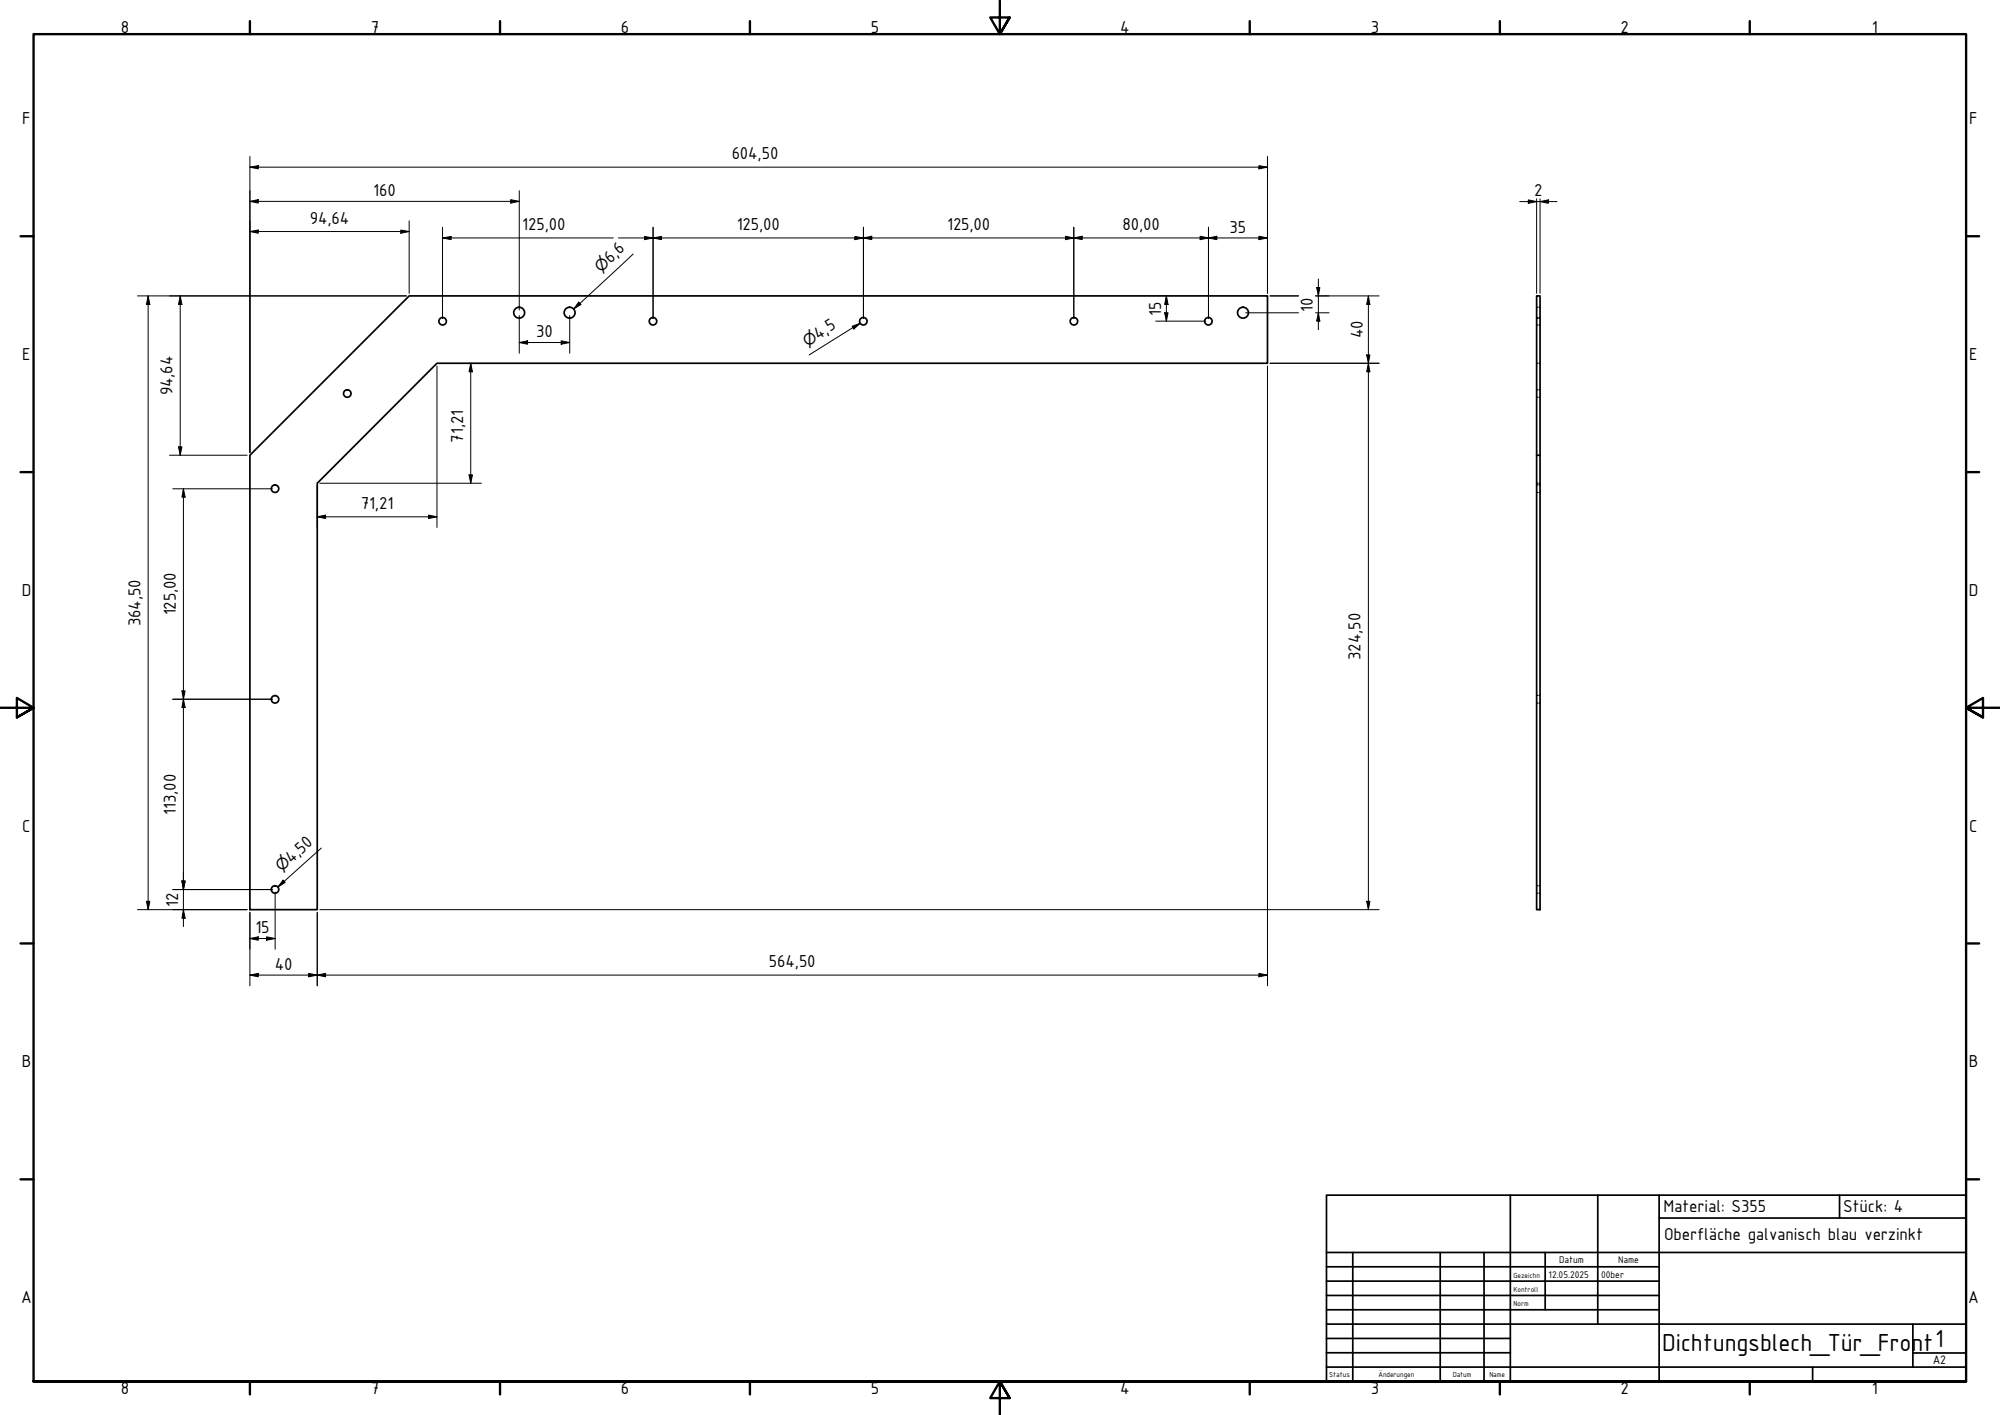
[picture p49: page 1]
Material: S355

Oberflche galvanisch blau verzinkt

Datum | Name

Gezeichn | 12.05.2025 | 00ber

Kontroll

Norm
