Edtison/EDTV4/hardware/cad/sheetmetal/Druckbett_Traeger_Blech.pdf

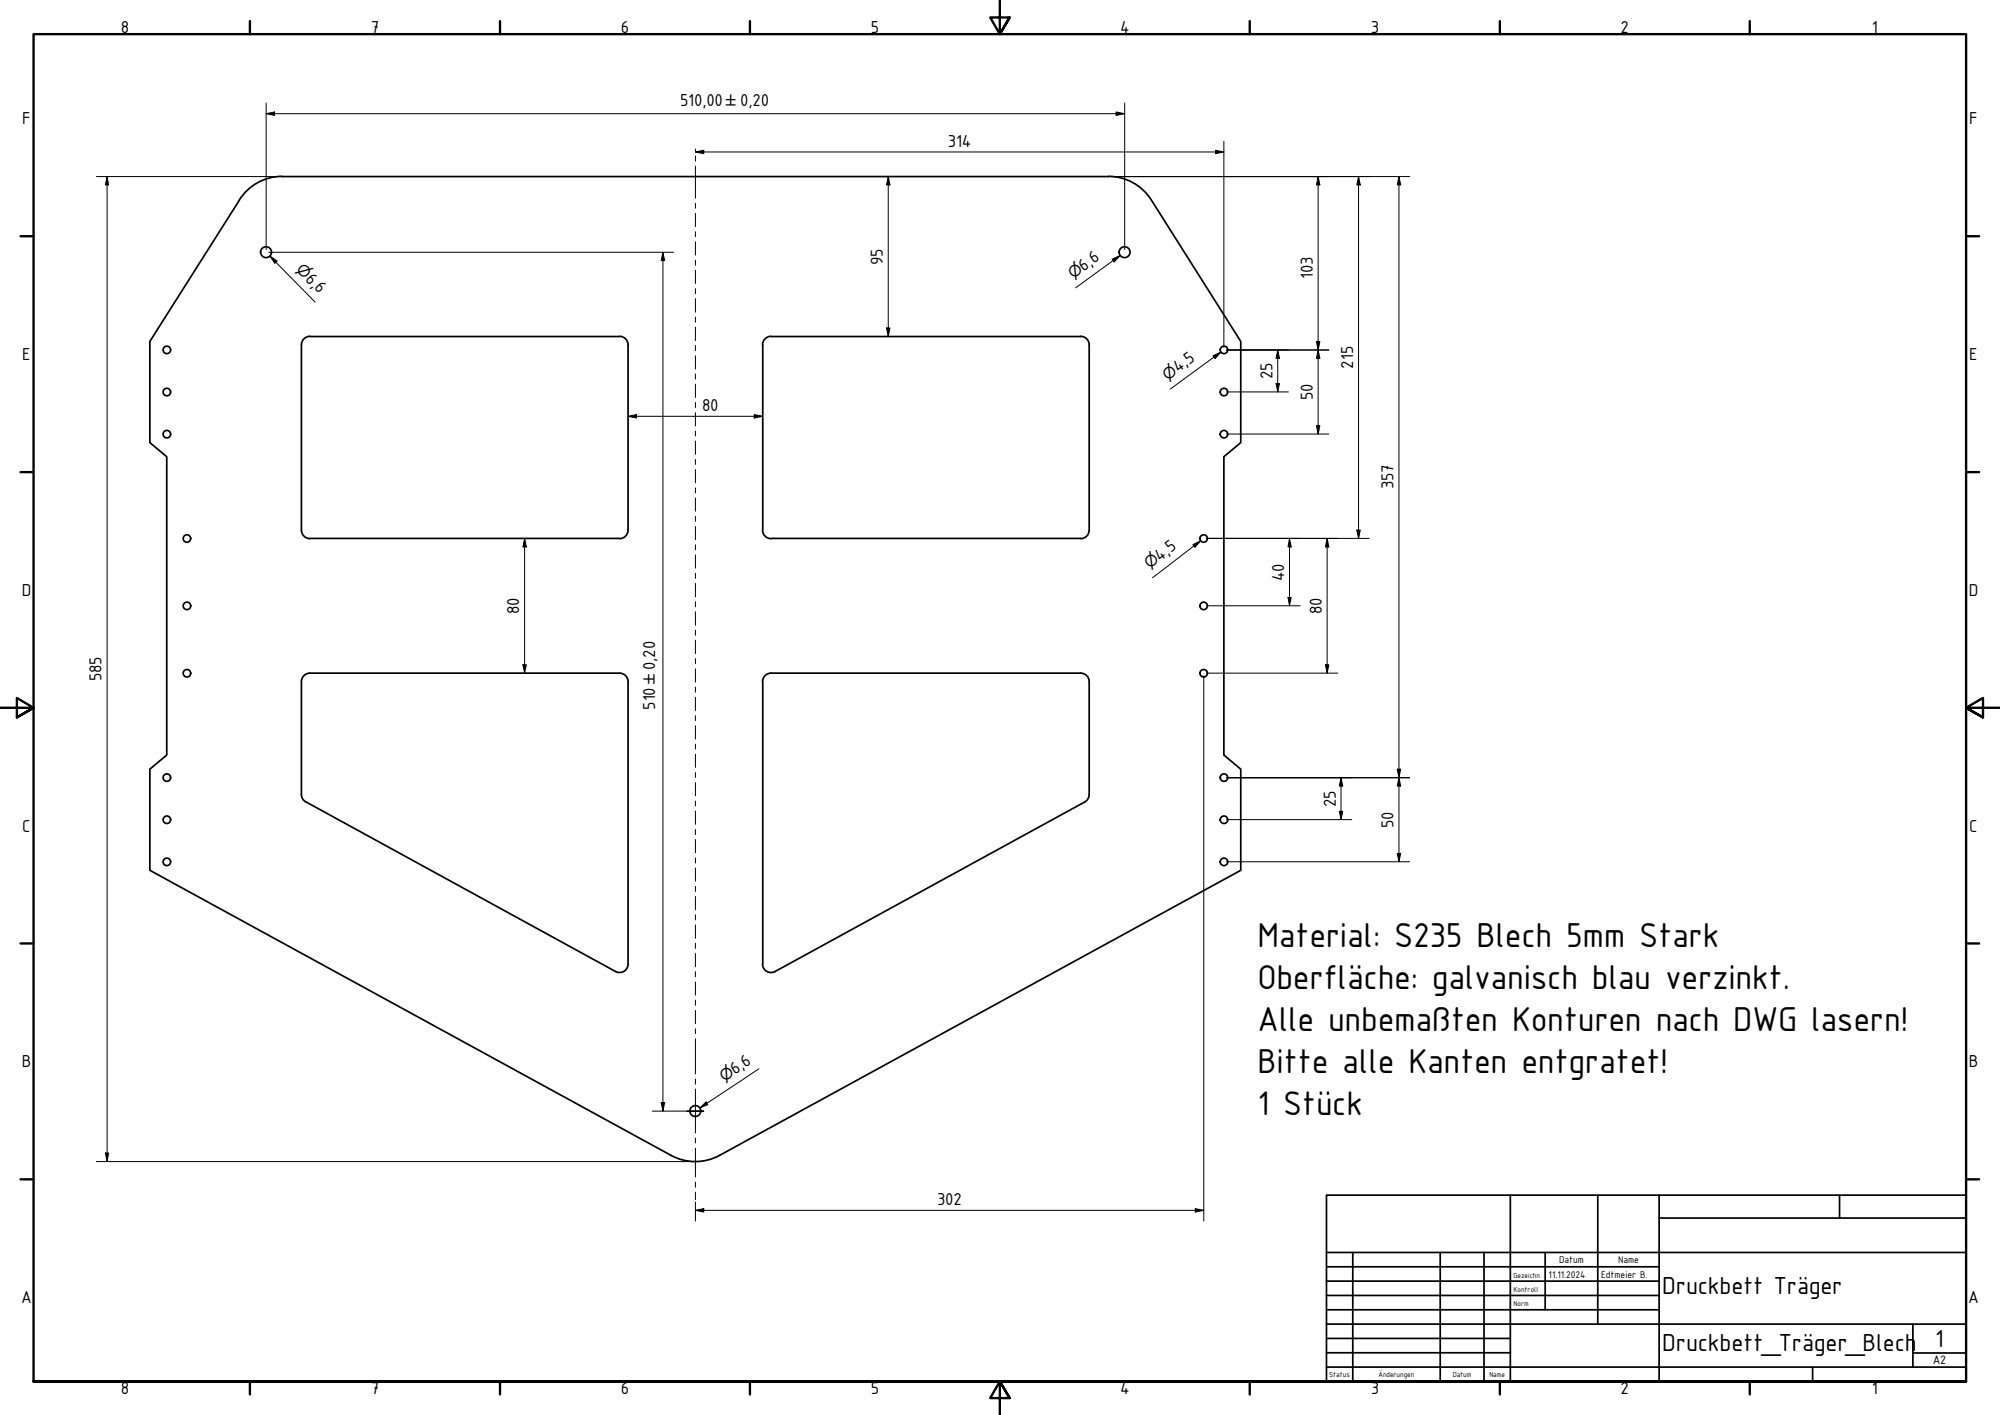
[picture p50: page 1]

Material: S235 Blech 5mm Stark
Oberflche: galvanisch blau verzinkt.
Alle unbematen Konturen nach DWG lasern!
Bitte alle Kanten entgratet!

Datum | Name | Druckbett Trger

Gezeichn | 11.11.2024 | Edtmeier B.

Kontroll

Norm
