Edtison/EDTV4/hardware/cad/sheetmetal/Frontblech.pdf

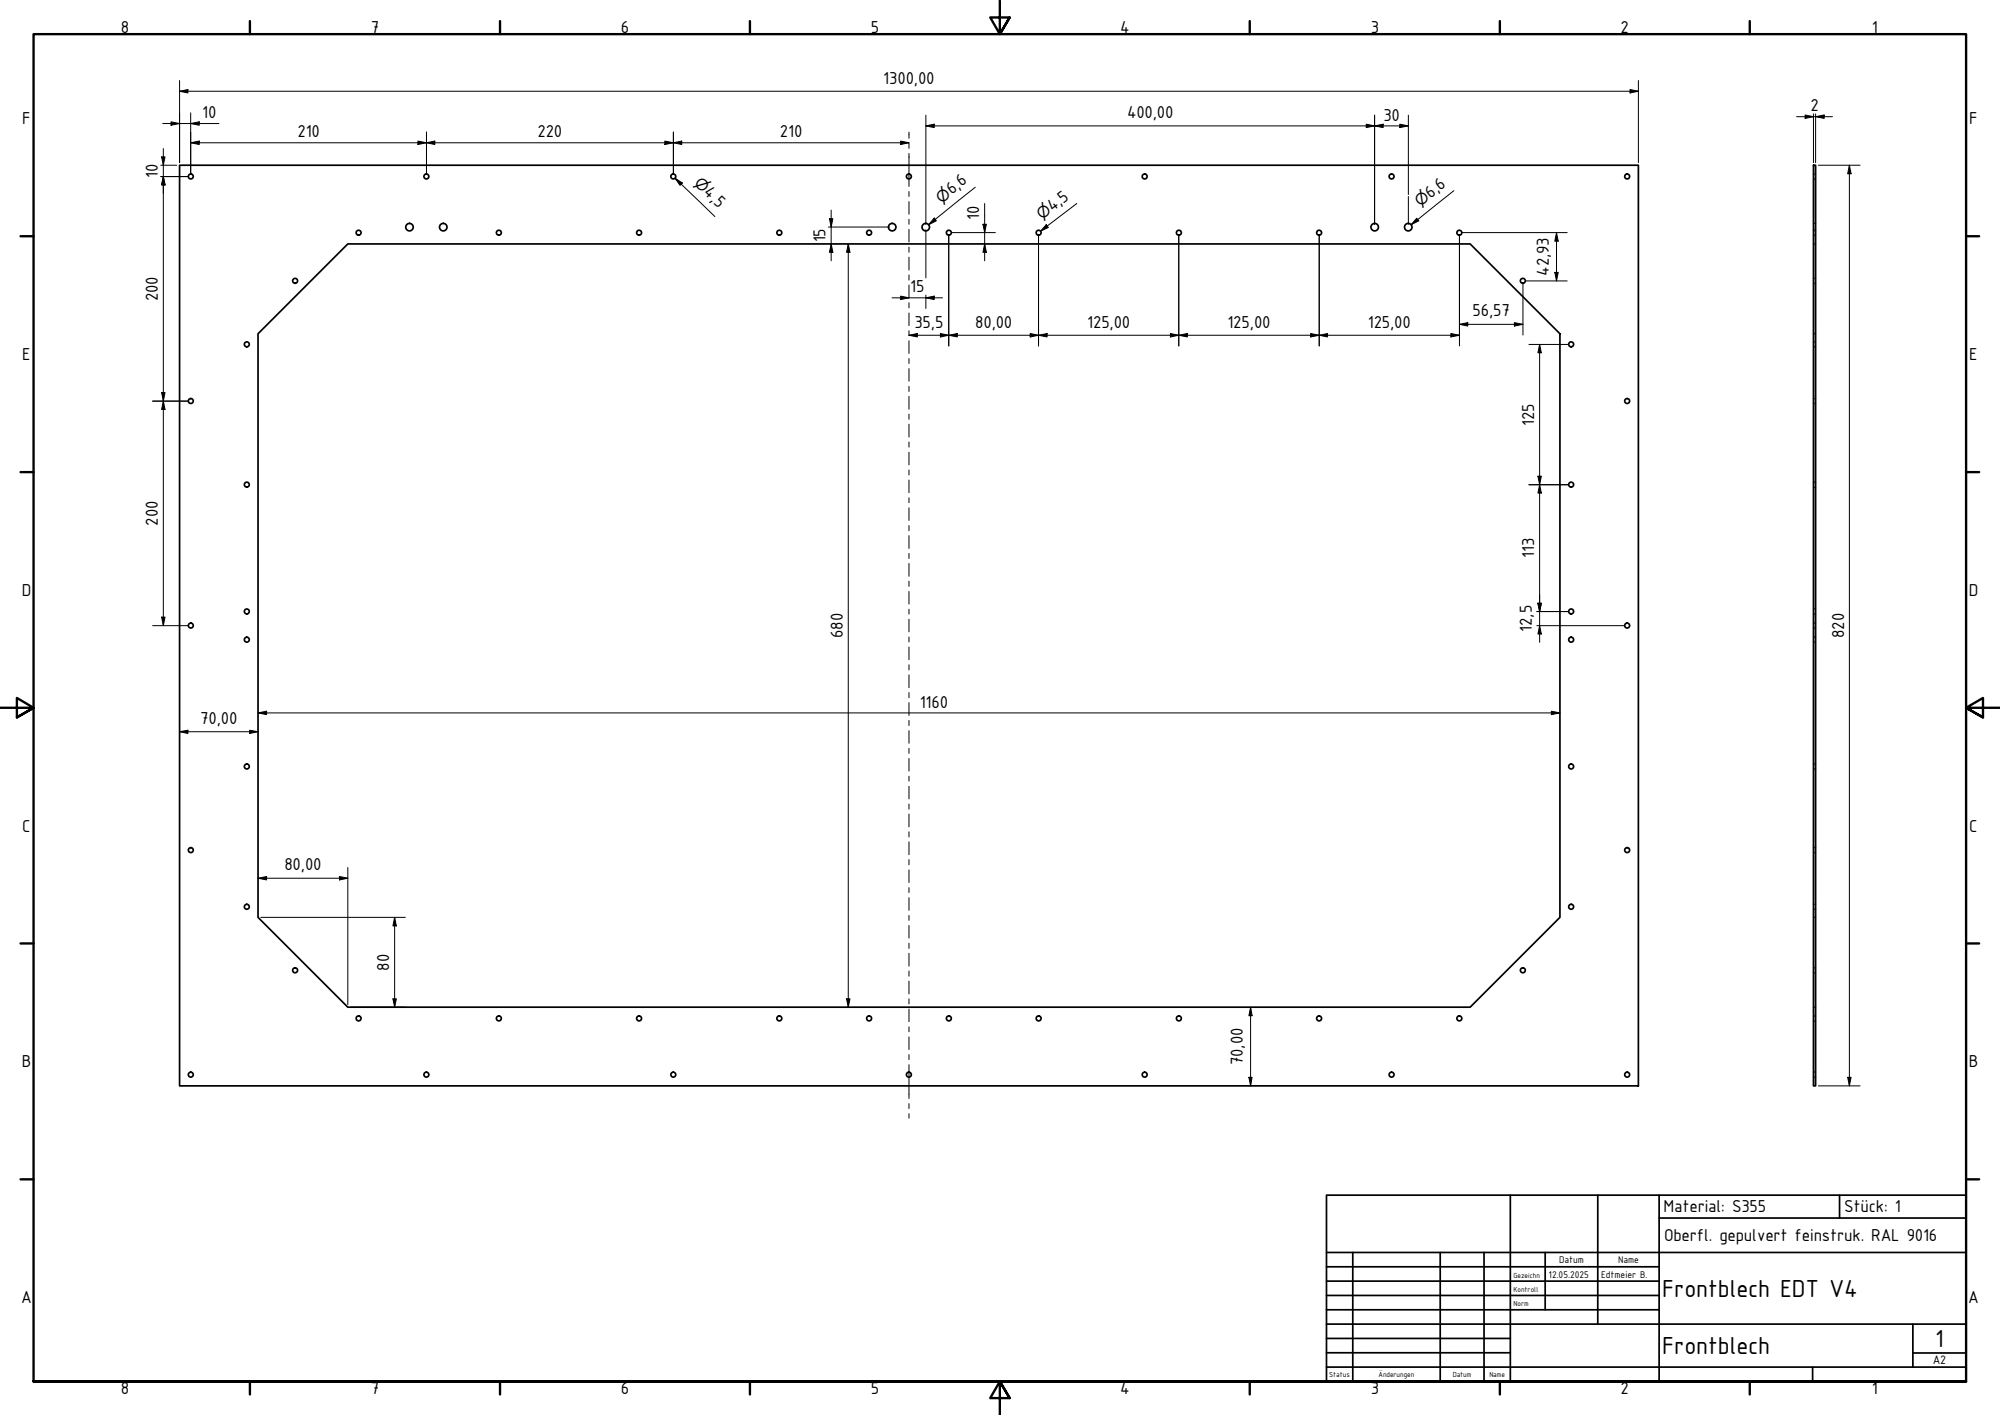
[picture p51: page 1]
Material: S355

Oberfl. gepulvert feinstruk. RAL 9016

Datum | Name | Frontblech EDT V4

Gezeichn | 12.05.2025 | Edtmeier B.

Kontroll

Norm
