Edtison/EDTV4/hardware/cad/sheetmetal/Mitnehmer kabelschlepp Extruder.pdf

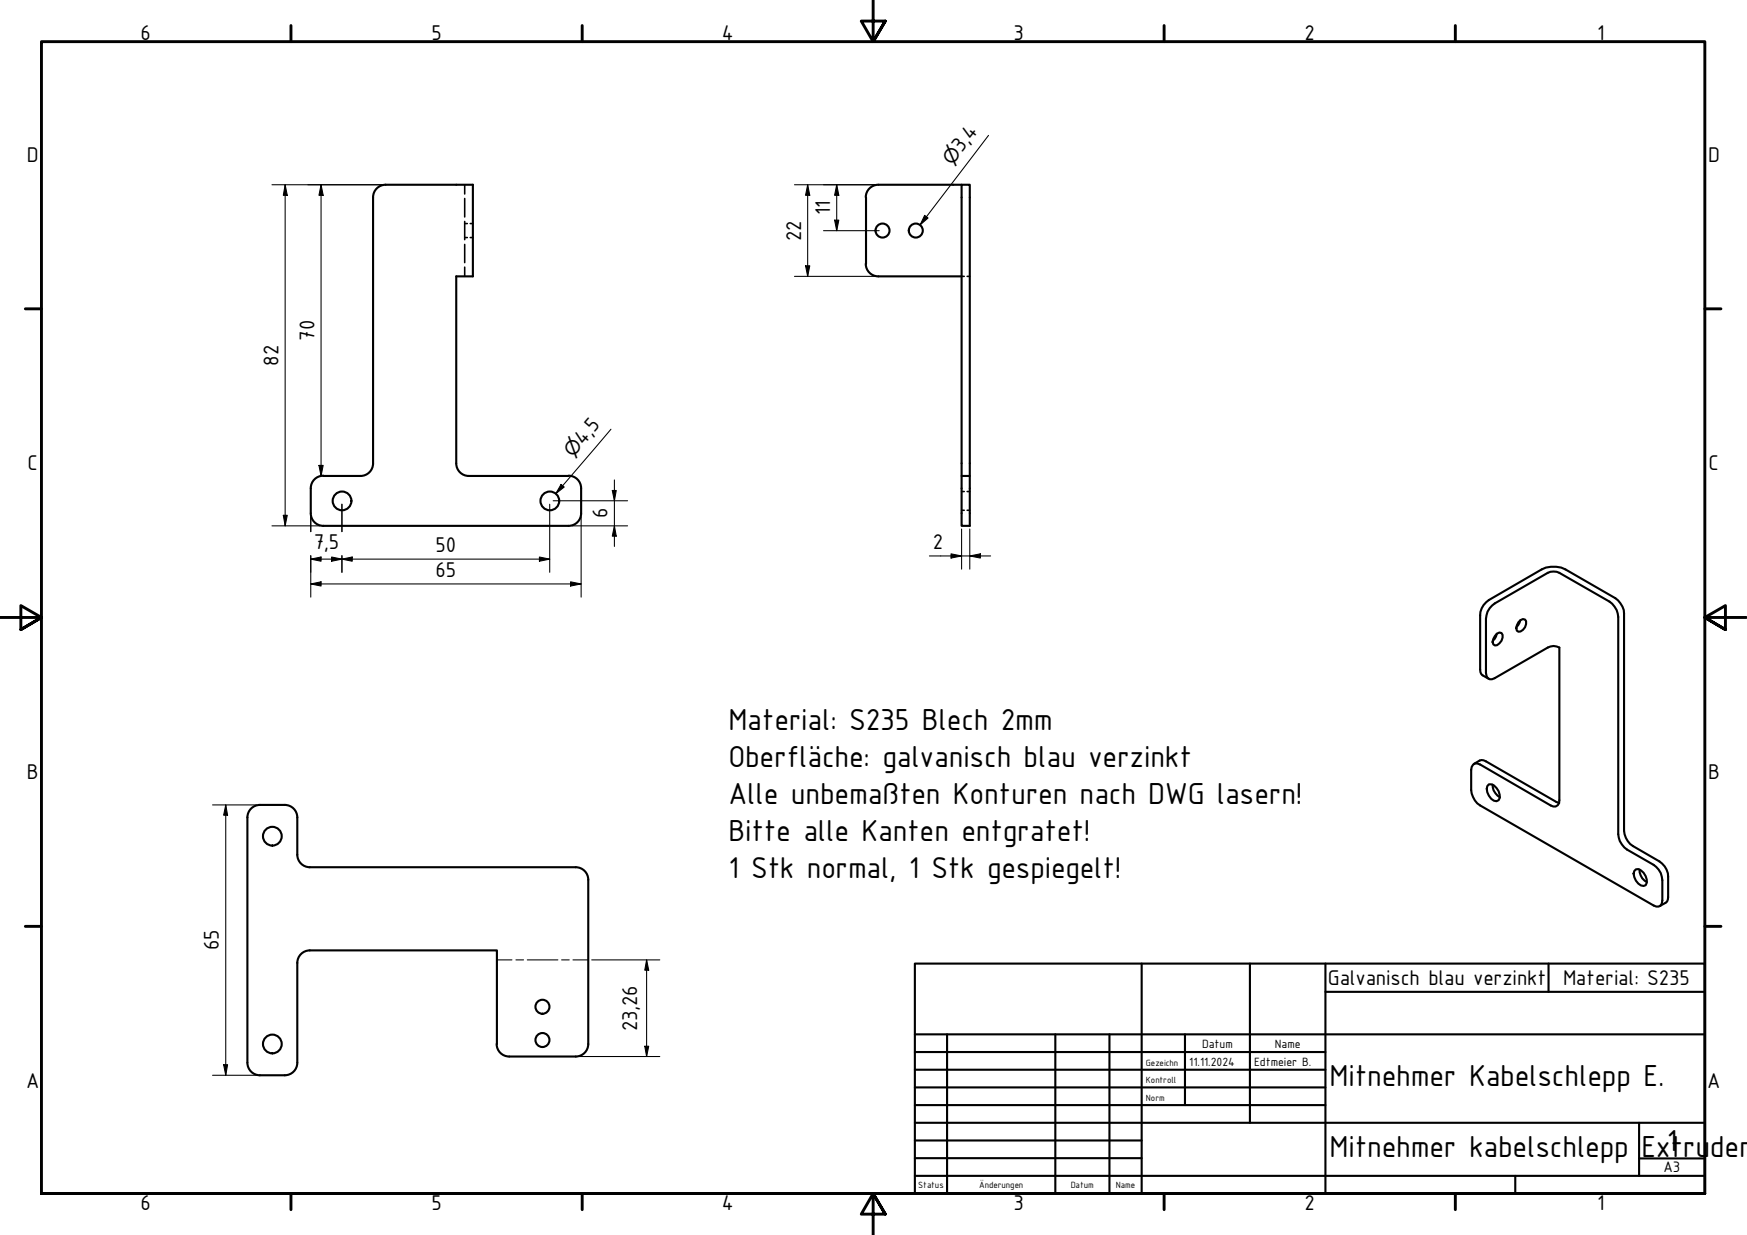
[picture p52: page 1]
Mitnehmer kabelschlepp; Extruder; Galvanisch blau verzinkt; Material: S235

Material: S235 Blech 2mm
Oberflche: galvanisch blau verzinkt
Alle unbematen Konturen nach DWG lasern!
Bitte alle Kanten entgratet!
1 Stk normal, 1 Stk gespiegelt!

Datum | Name | Mitnehmer Kabelschlepp E.

Gezeichn | 11.11.2024 | Edtmeier B.

Kontroll

Norm
