Edtison/EDTV4/hardware/cad/sheetmetal/Mitnehmer Kabelschlepp X.pdf

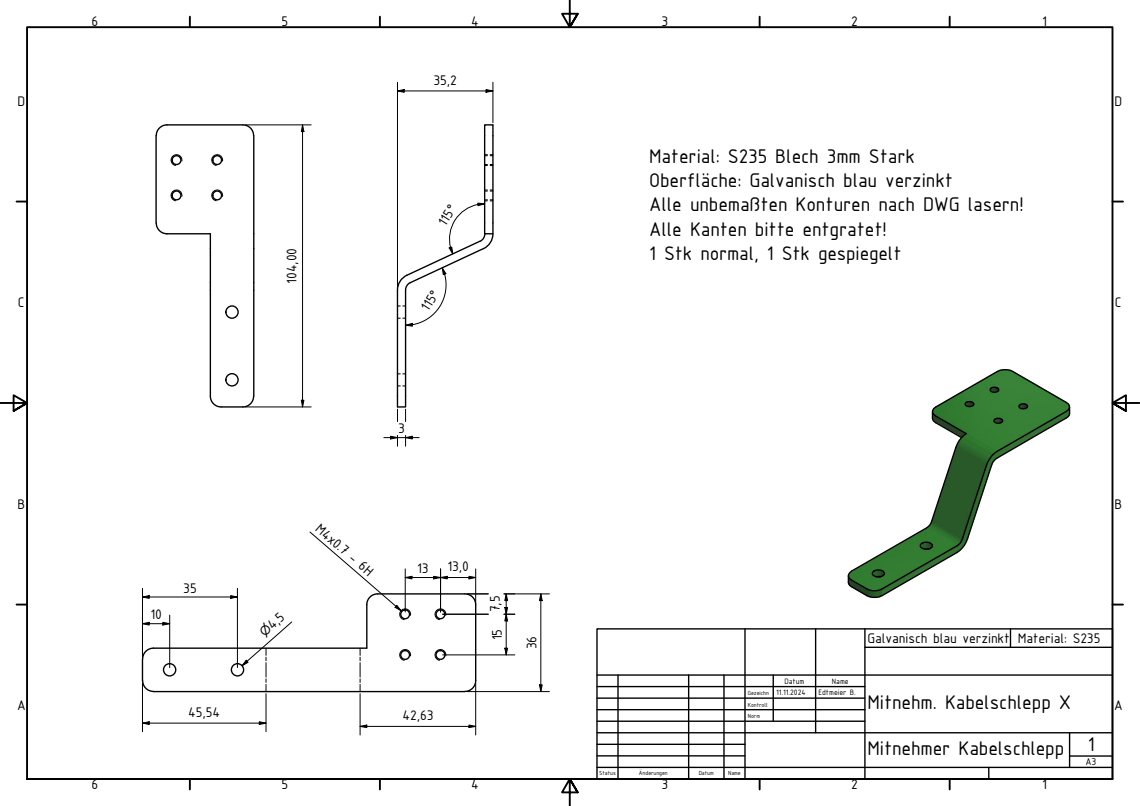
[picture p53: page 1]
Mitnehmer Kabelschlepp; Galvanisch blau verzinkt; Material: S235

Material: S235 Blech 3mm Stark
Oberflche: Galvanisch blau verzinkt
Alle unbematen Konturen nach DWG lasern!
Alle Kanten bitte entgratet!
1 Stk normal, 1 Stk gespiegelt

Datum | Name | Mitnehm. Kabelschlepp X

Gezeichn | 11.11.2024 | Edtmeier B.

Kontroll

Norm
