Edtison/EDTV4/hardware/cad/sheetmetal/Montageplatte_Lenkrollen_Fuss.pdf

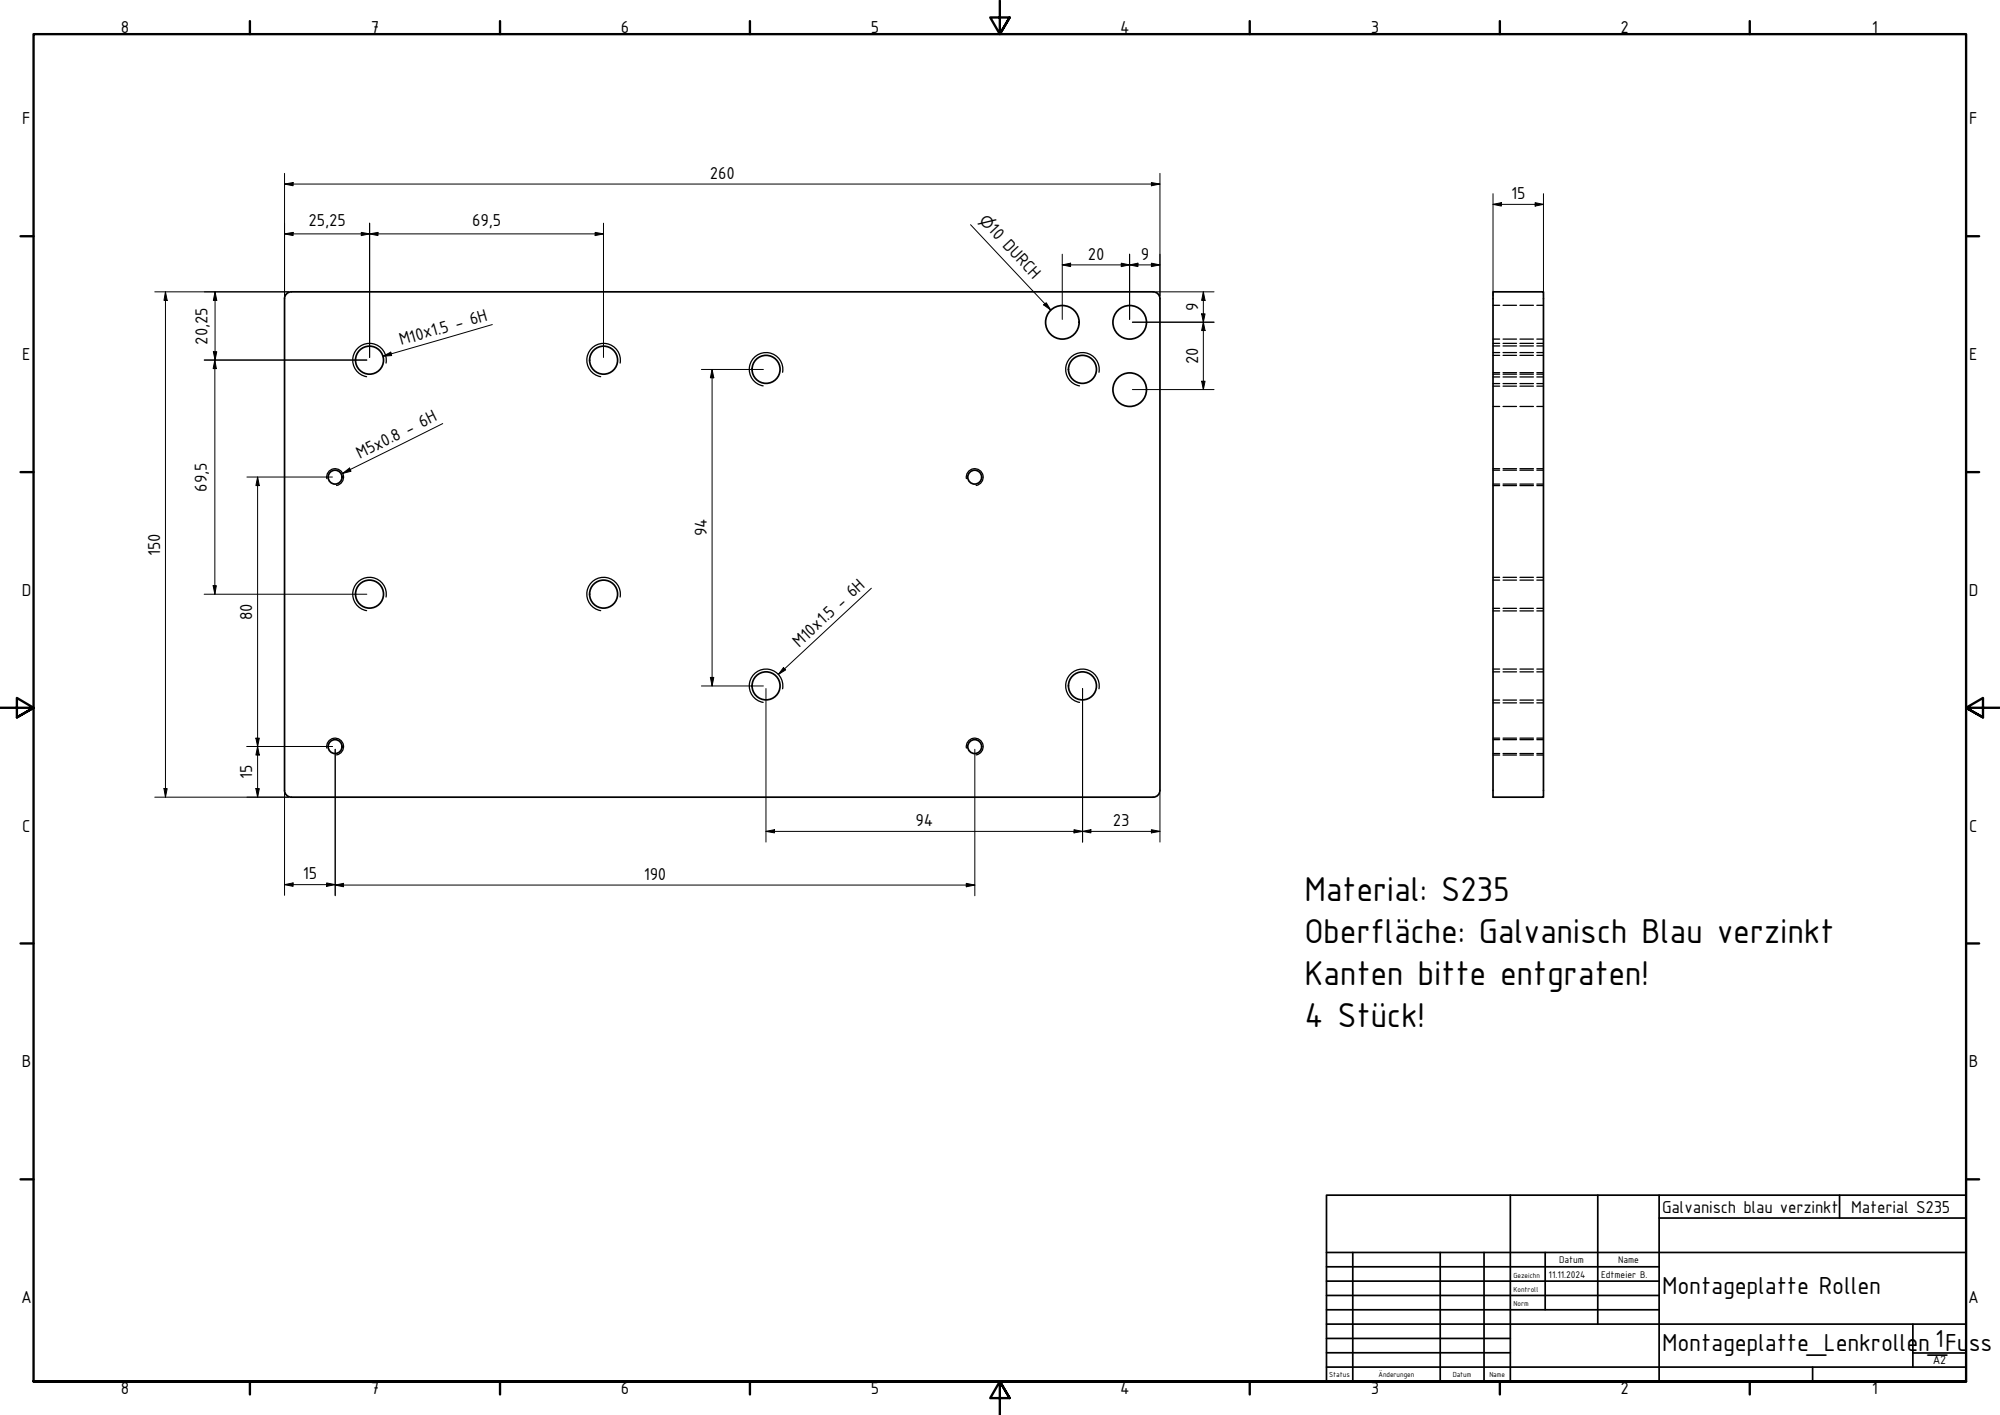
[picture p54: page 1]
Galvanisch blau verzinkt; Material S235

Material: S235
Oberflche: Galvanisch Blau verzinkt
Kanten bitte entgraten!

Datum | Name | Montageplatte Rollen

Gezeichn | 11.11.2024 | Edtmeier B.

Kontroll

Norm
