Edtison/EDTV4/hardware/cad/sheetmetal/Motorhalter Z-Achse Nema 23.pdf

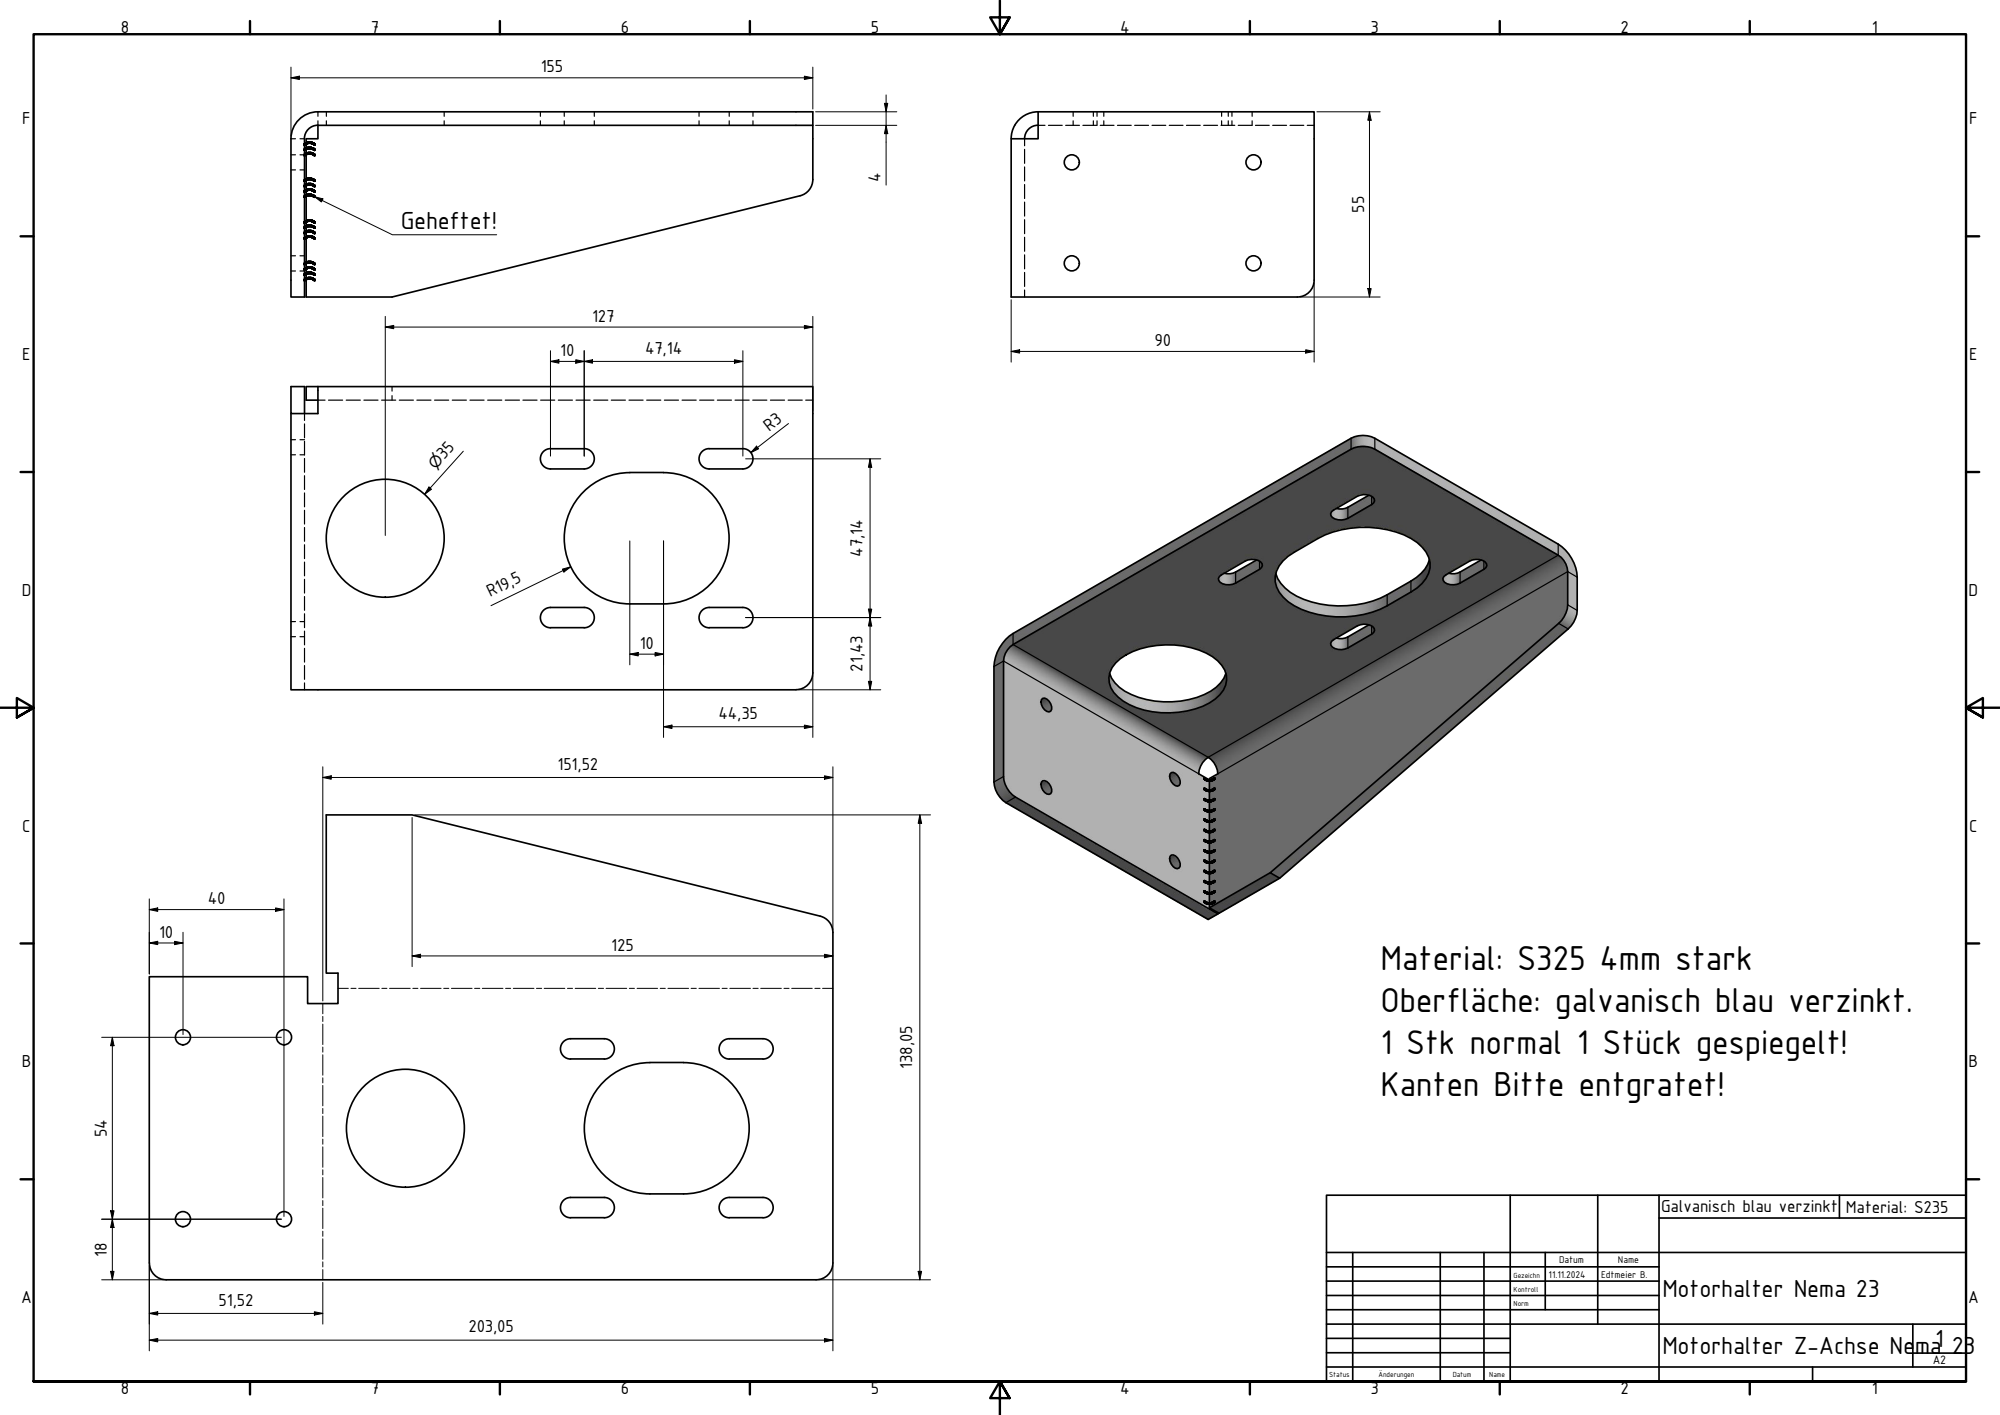
[picture p55: page 1]
Galvanisch blau verzinkt; Material: S235

Material: S325 4mm stark
Oberflche: galvanisch blau verzinkt.
1 Stk normal 1 St¯ck gespiegelt!
Kanten Bitte entgratet!

Datum | Name | Motorhalter Nema 23

Gezeichn | 11.11.2024 | Edtmeier B.

Kontroll

Norm

Motorhalter Z-Achse Nema 23
