Edtison/EDTV4/hardware/cad/sheetmetal/Riemenspanner Y.pdf

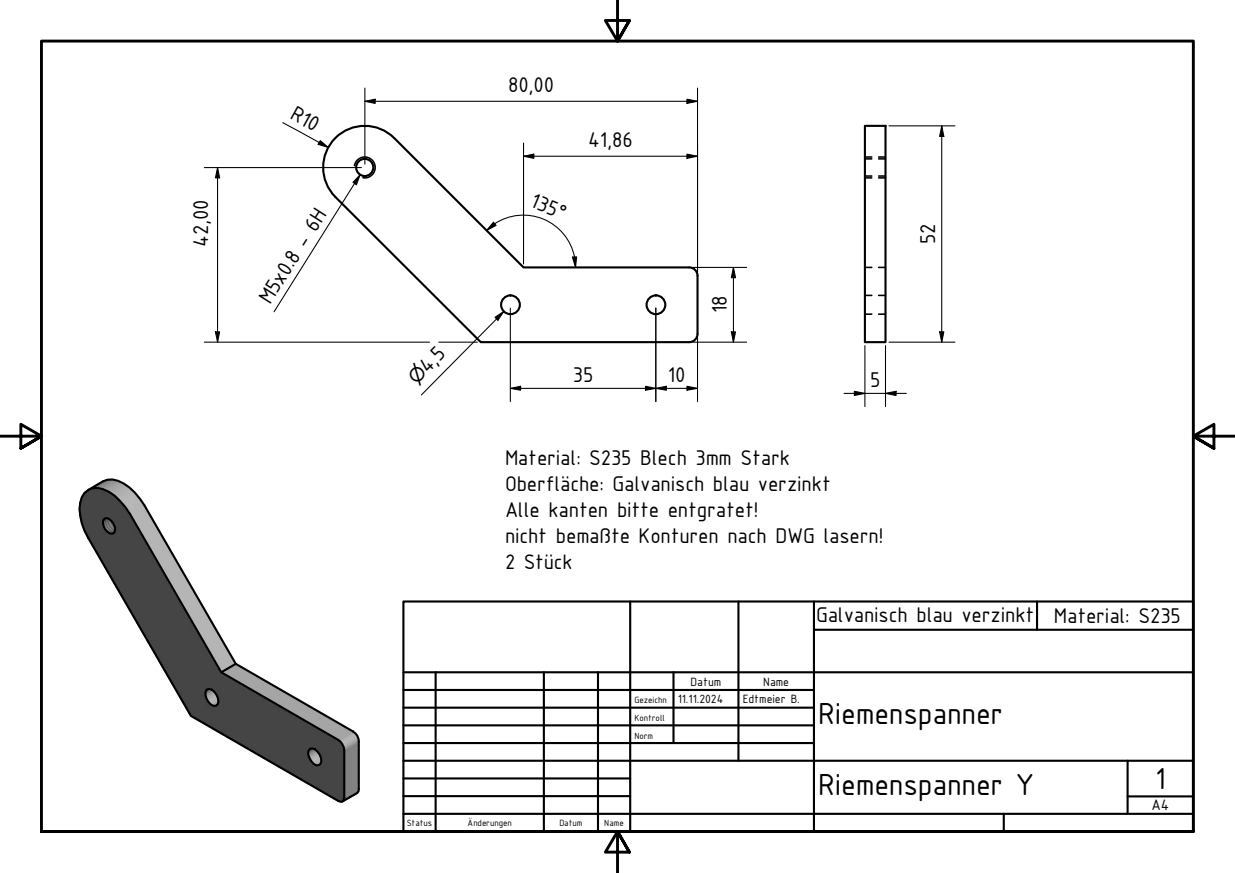
[picture p56: page 1]
Riemenspanner Y; Galvanisch blau verzinkt; Material: S235

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

Datum | Name | Riemenspanner

Gezeichn | 11.11.2024 | Edtmeier B.

Kontroll

Norm
