Edtison/EDTV4/hardware/cad/sheetmetal/Seitenblech.pdf

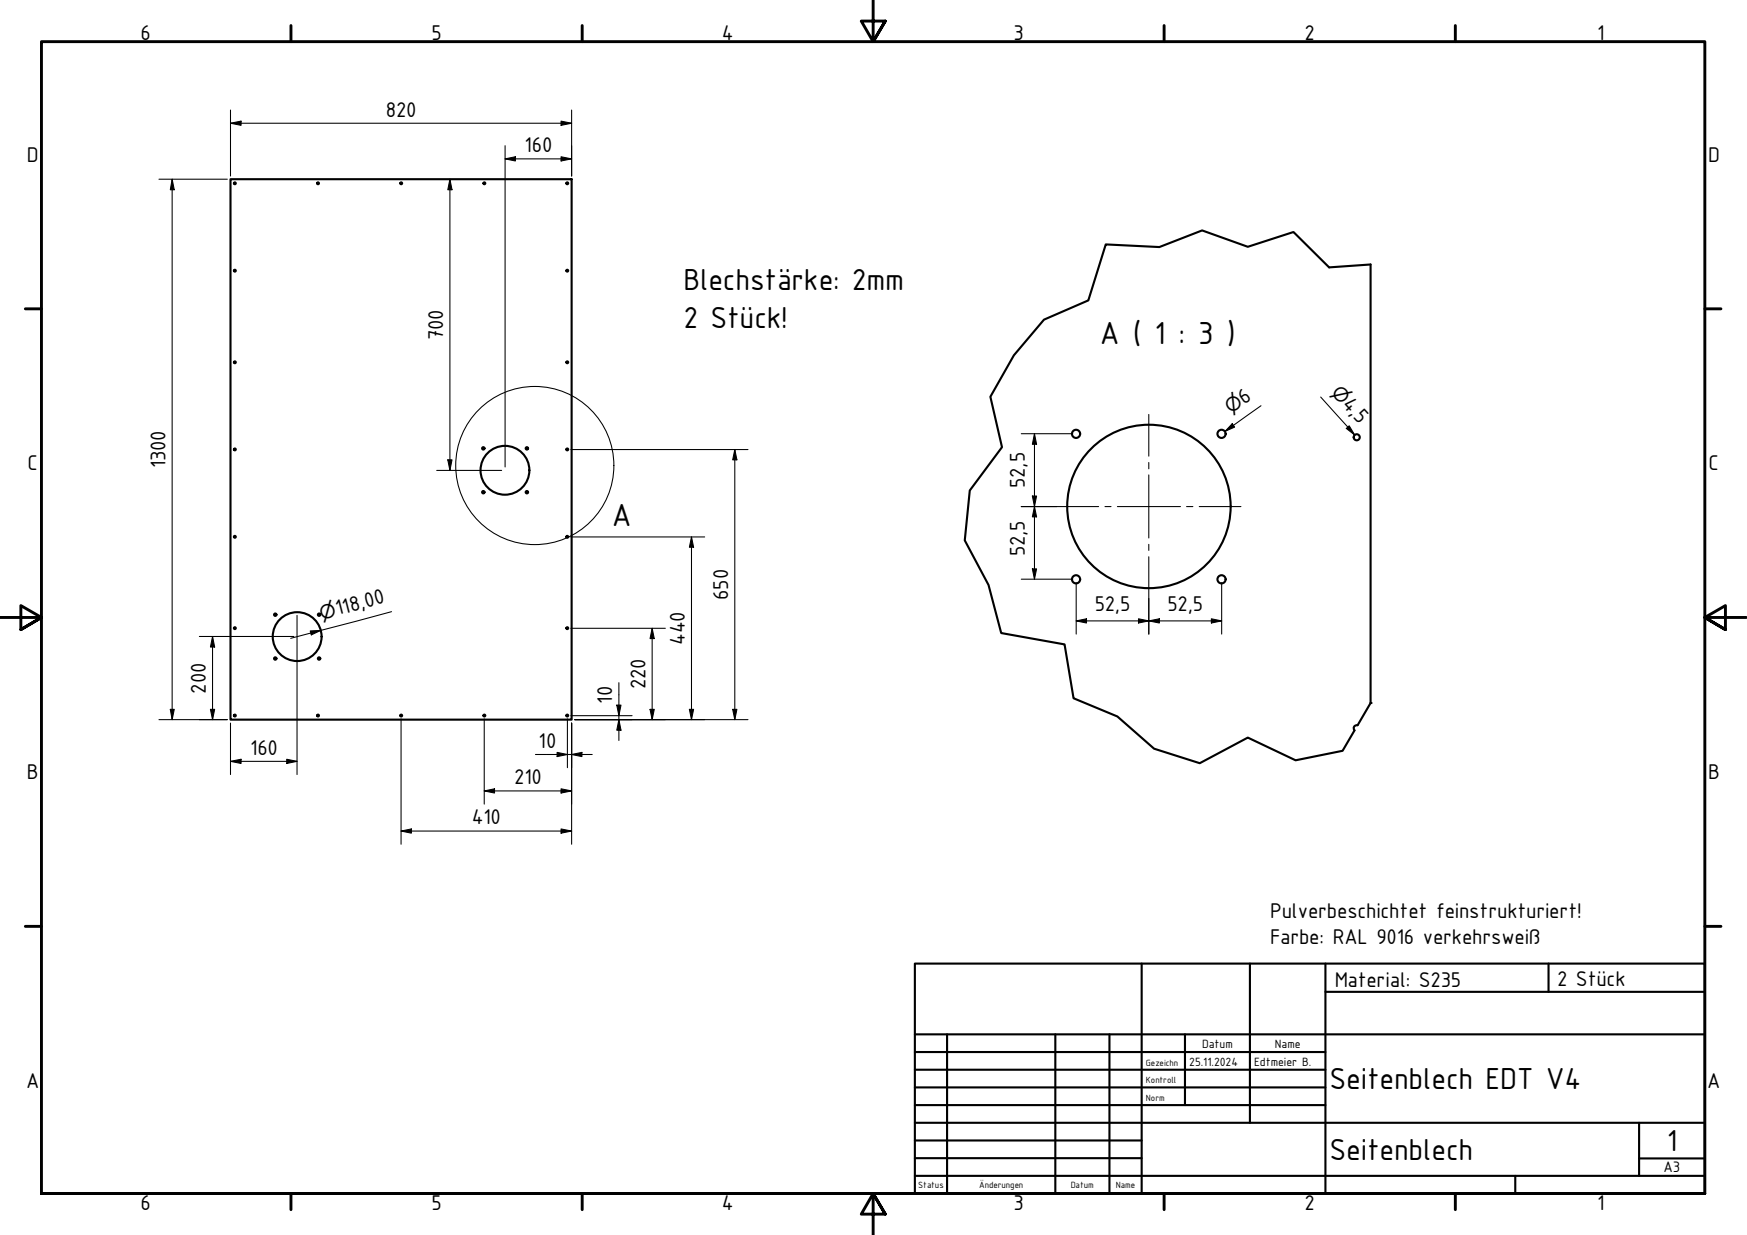
[picture p57: page 1]
Material: S235

Pulverbeschichtet feinstrukturiert!
Farbe: RAL 9016 verkehrswei

Datum | Name | Seitenblech EDT V4

Gezeichn | 25.11.2024 | Edtmeier B.

Kontroll

Norm
