Edtison/EDTV4/hardware/cad/sheetmetal/Tuerblech_Front.pdf

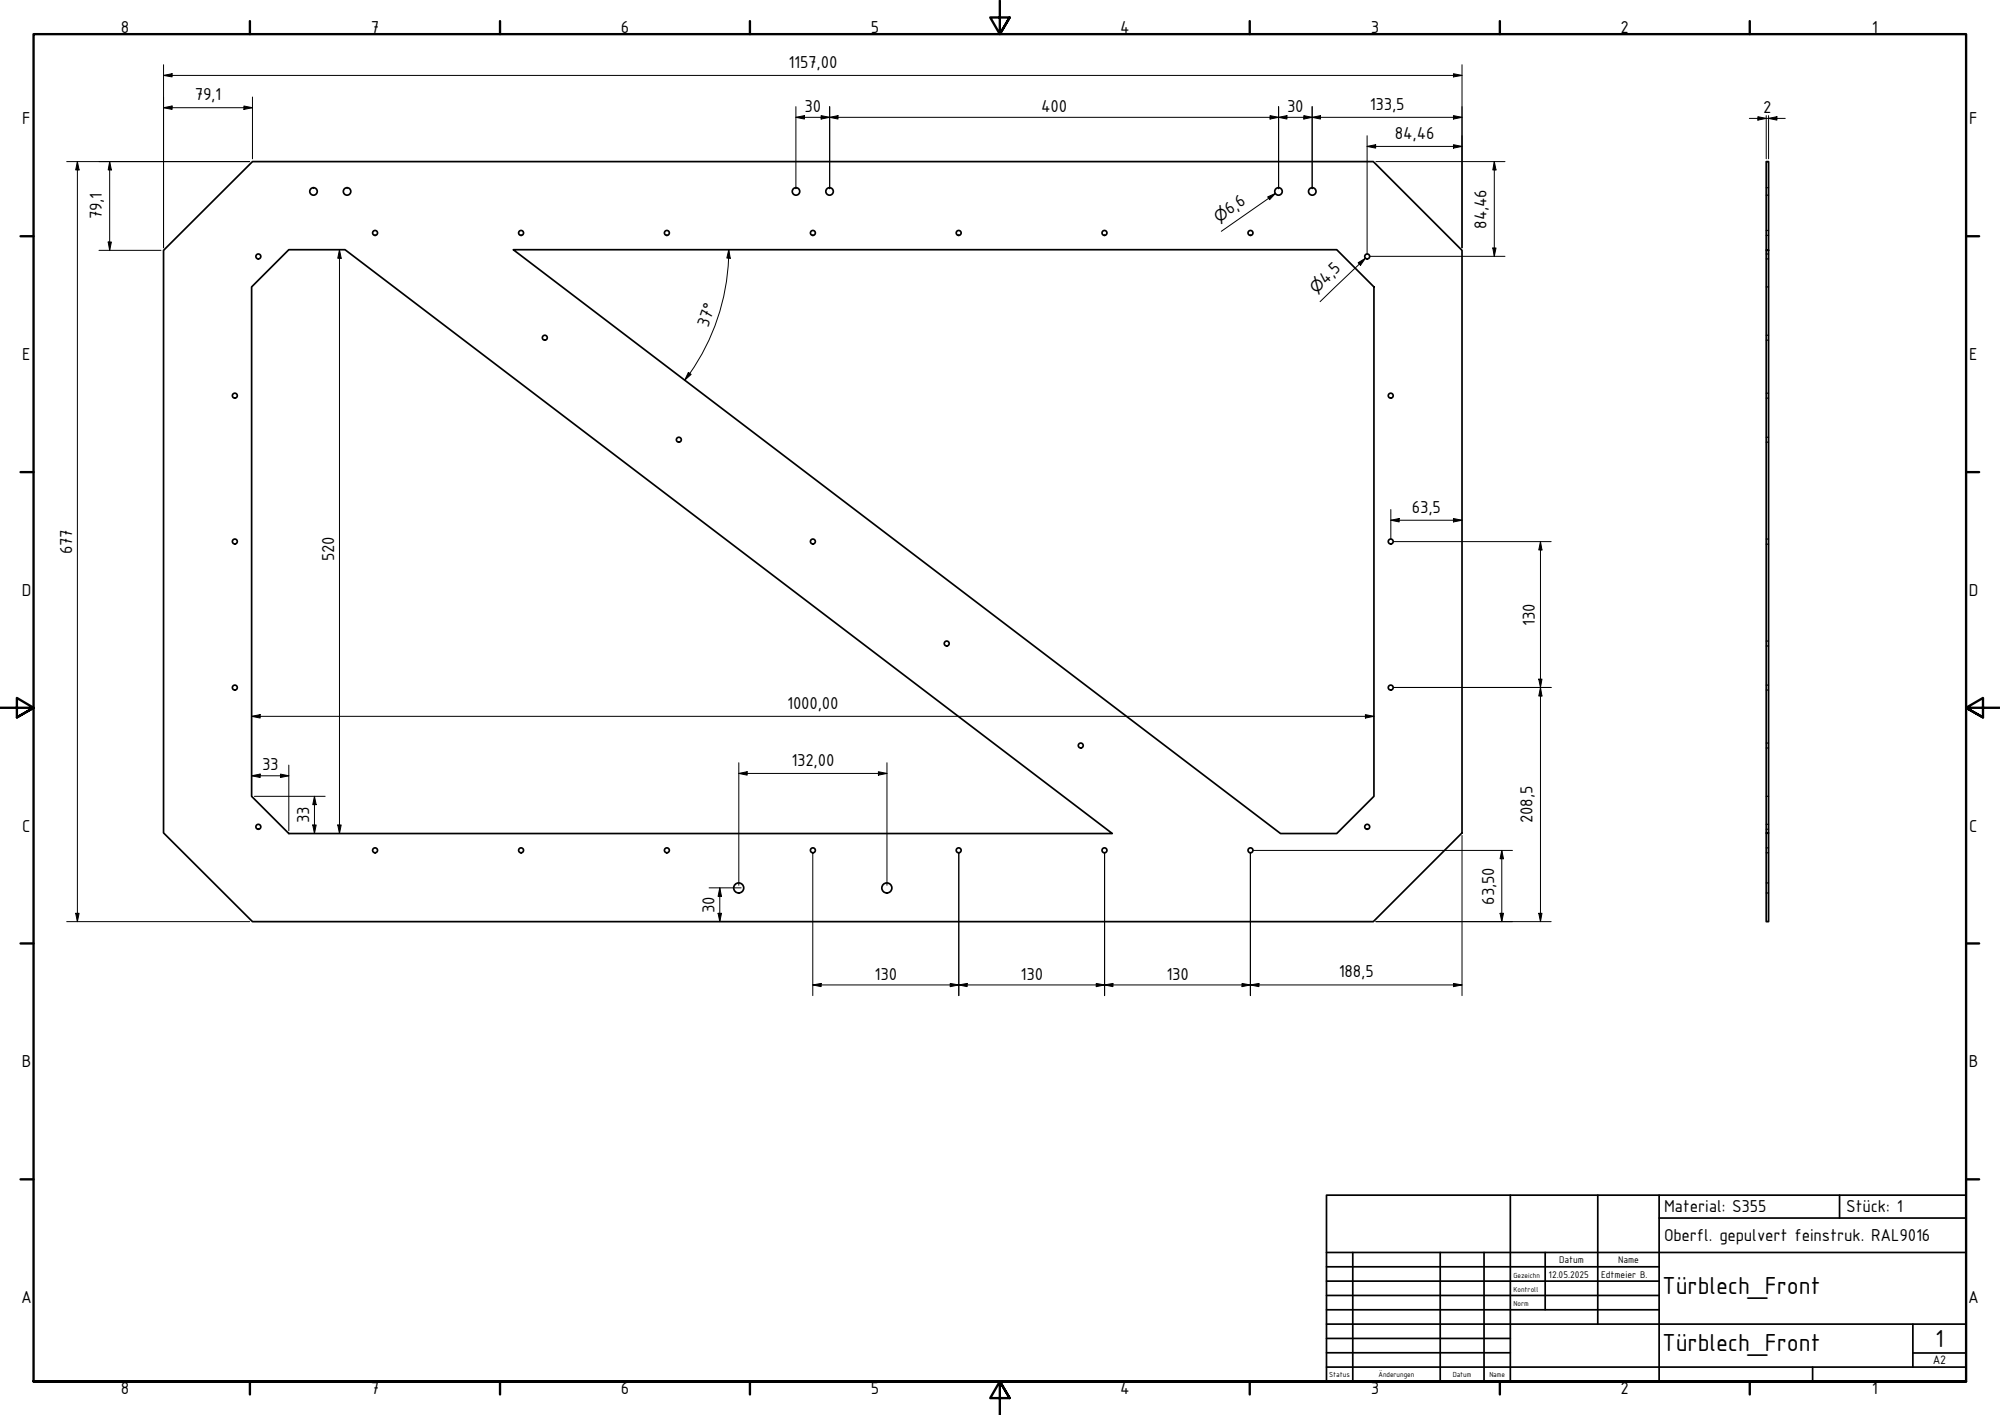
[picture p58: page 1]
Material: S355

Oberfl. gepulvert feinstruk. RAL9016

Datum | Name | T¯rblech_Front

Gezeichn | 12.05.2025 | Edtmeier B.

Kontroll

Norm
