Edtison/EDTV4/hardware/cad/sheetmetal/Winkel_Fuehrung_zu_Taeger.pdf

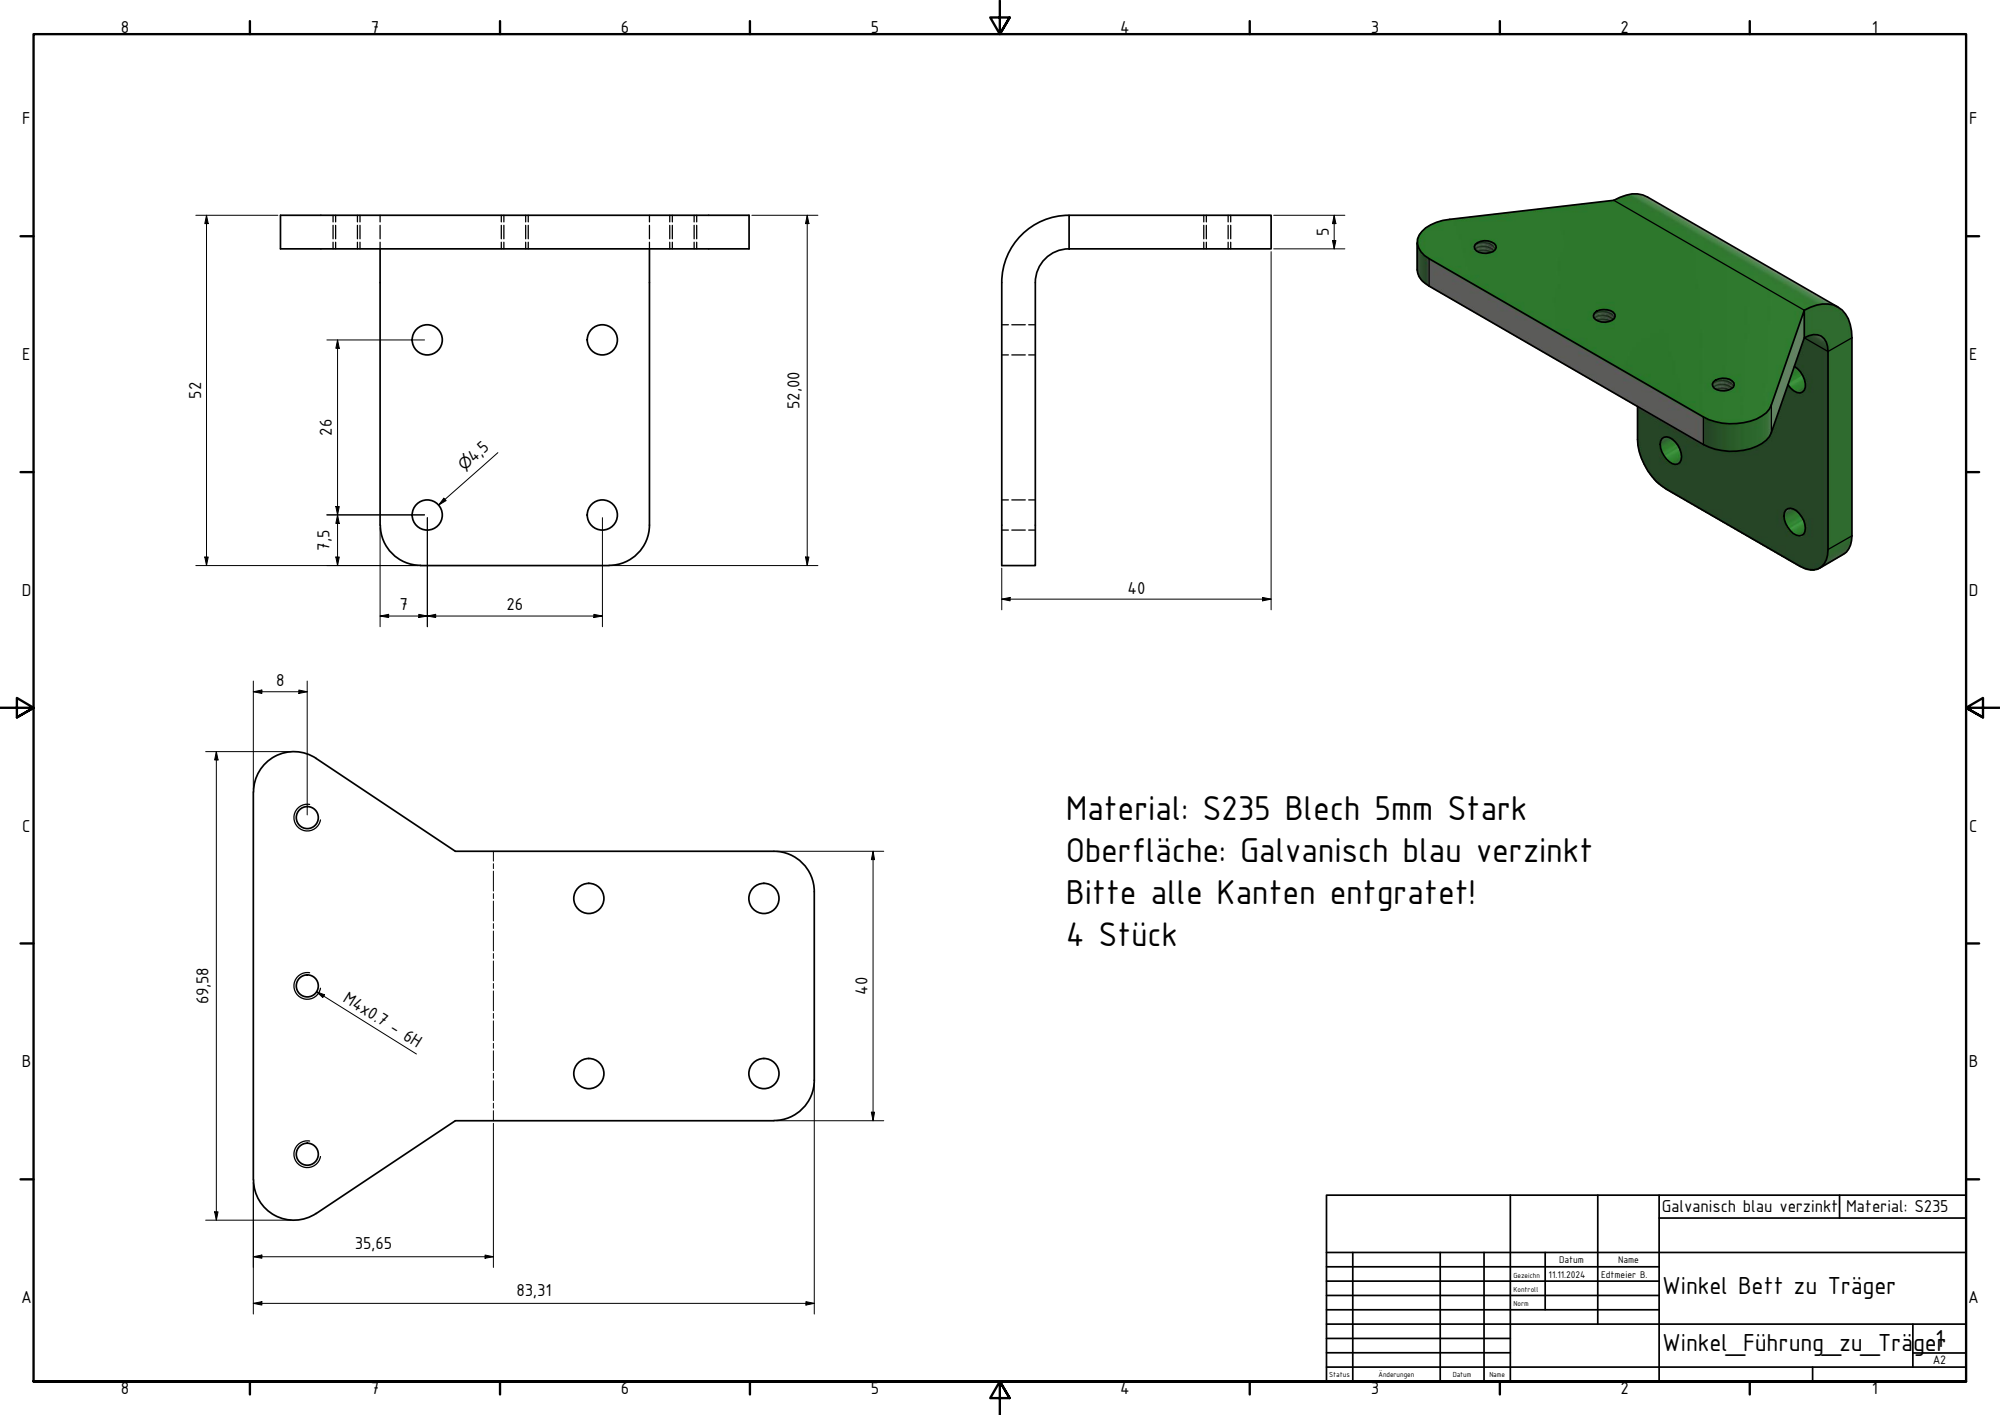
[picture p59: page 1]
Galvanisch blau verzinkt; Material: S235

Material: S235 Blech 5mm Stark
Oberflche: Galvanisch blau verzinkt
Bitte alle Kanten entgratet!

Datum | Name | Winkel Bett zu Trger

Gezeichn | 11.11.2024 | Edtmeier B.

Kontroll

Norm
