Edtison/EDTV4/hardware/cad/sheetmetal/Zwischenblech_Klappe.pdf

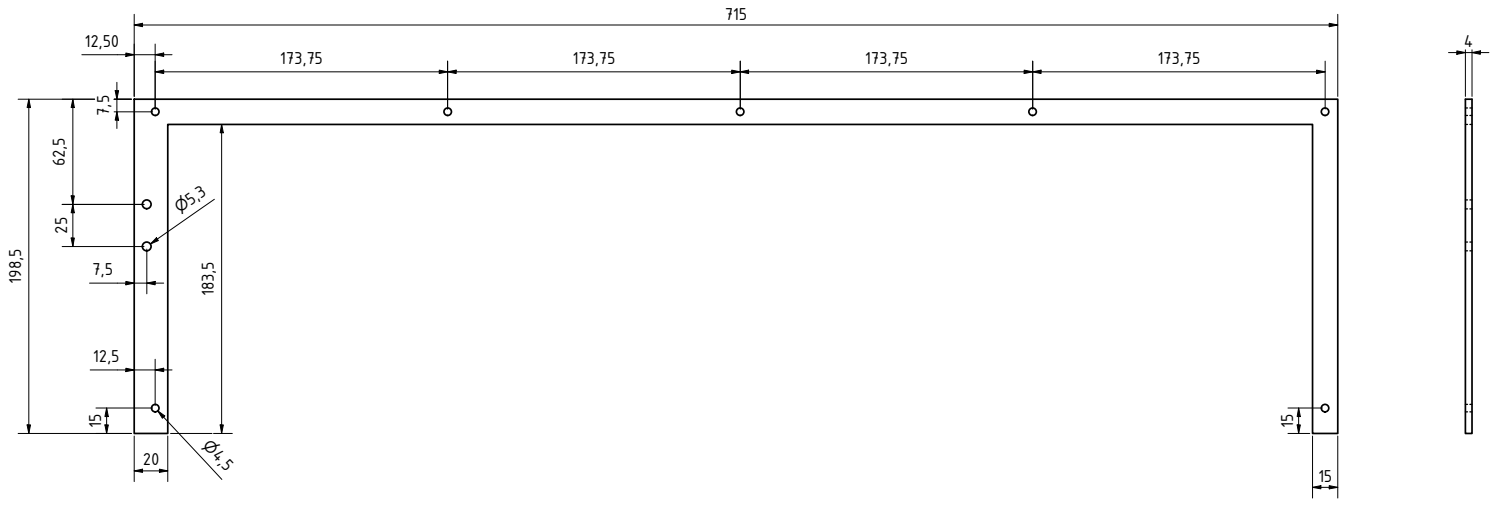
[picture p60: page 1]
Material: S355

Oberflche galv. blau verzinkt

Datum | Name | Zwischenblech Klappe

Gezeichn | 12.05.2025 | Edtmeier B.

Kontroll

Norm
