Edtison/EDTV4/hardware/cad/sheetmetal/Deckel_Klappe_Blech.pdf

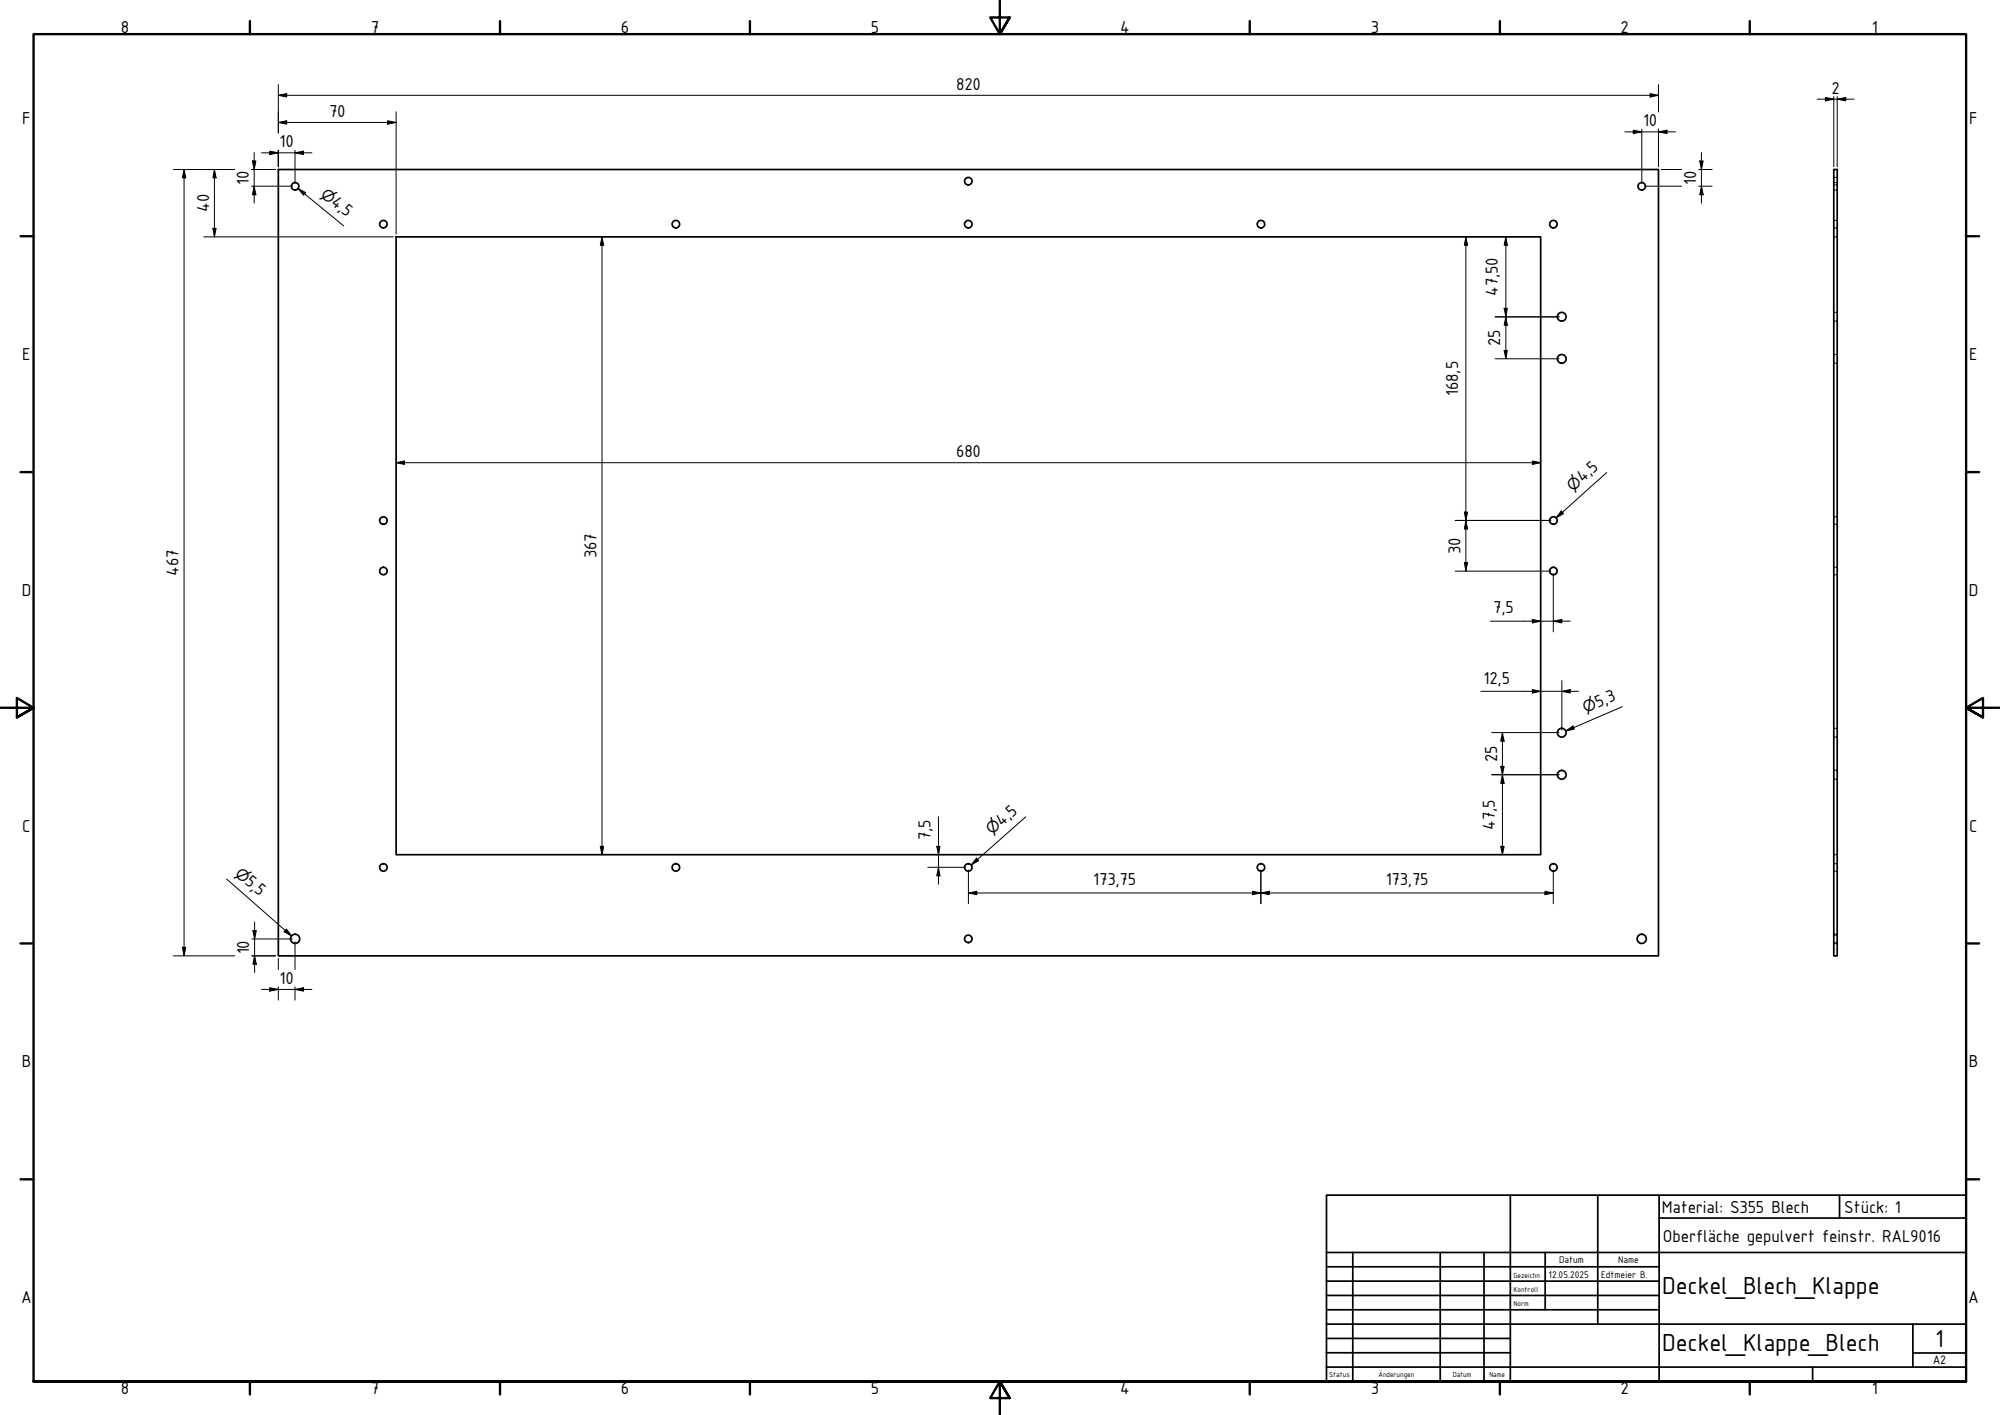
[picture p61: page 1]

G e z eic h n | 1 2.0 5.2 0 2 5 | E d t m eie r
