Edtison/EDTV4/media/photos/EDTV4_completed.jpg

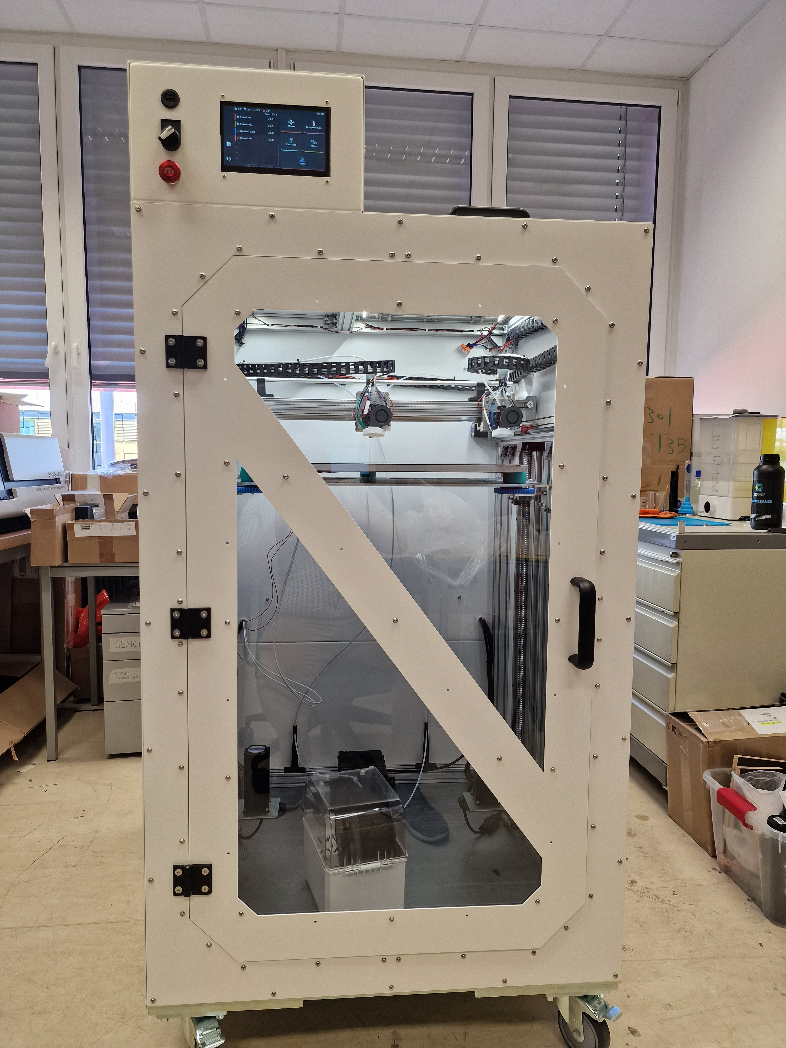
[picture p1: media/photos/EDTV4_completed.jpg]
media/photos/EDTV4_completed.jpg
