Edtison/EDTV4/media/photos/EDTV4_Testprint.jpg

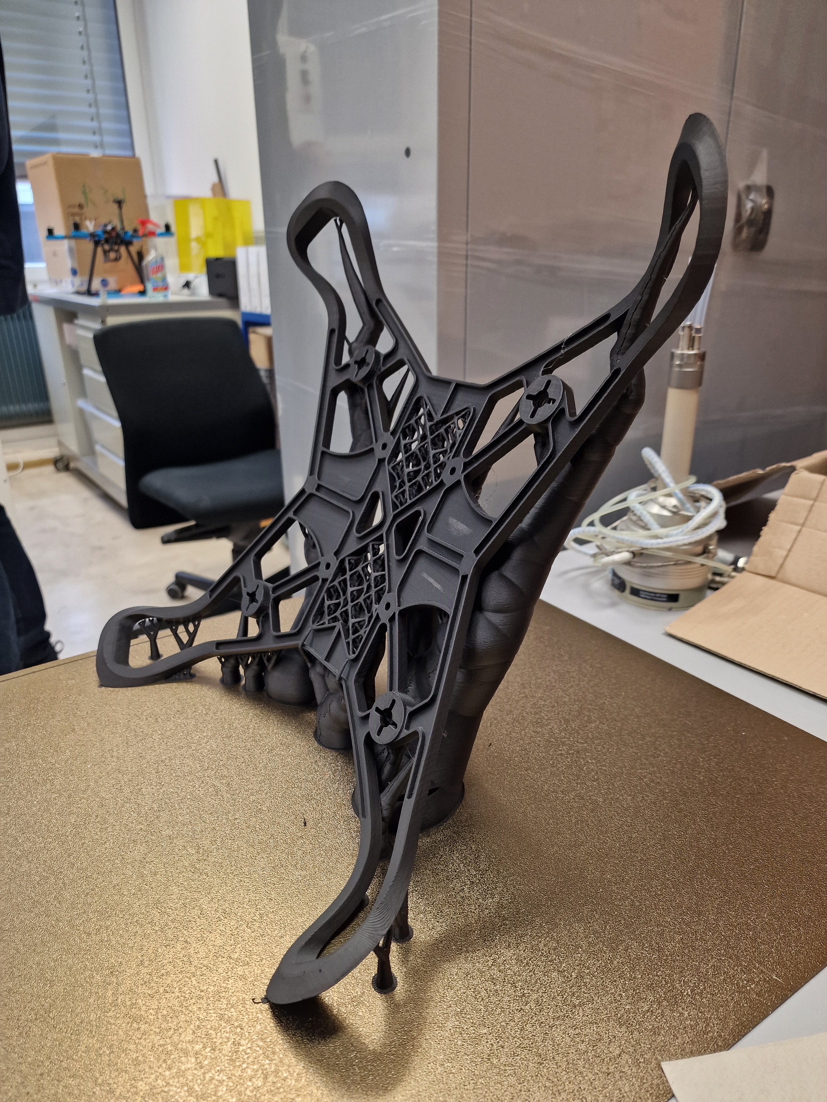
[picture p4: media/photos/EDTV4_Testprint.jpg]
media/photos/EDTV4_Testprint.jpg
